iseegr8tfuldeadppl/Kiwico/ByeDominoRobotOG/domino_robot.png

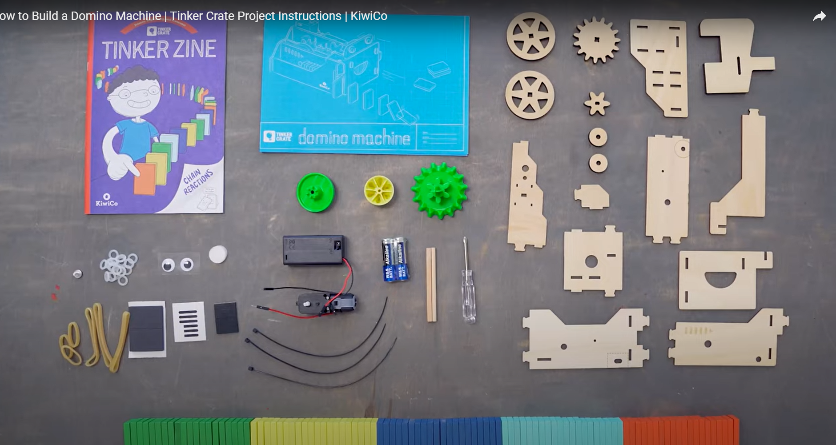
ByeDominoRobotOG/domino_robot.png
