iseegr8tfuldeadppl/Kiwico/circuitDiagrams/2.jpg

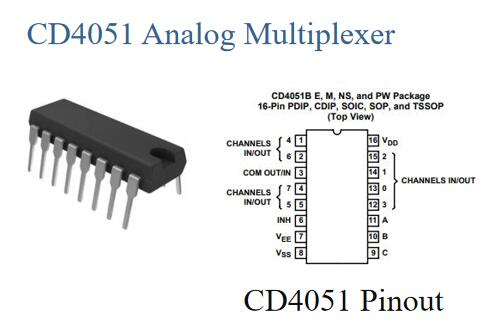
circuitDiagrams/2.jpg
