iseegr8tfuldeadppl/Kiwico/rpm_to_mm_per_s.png

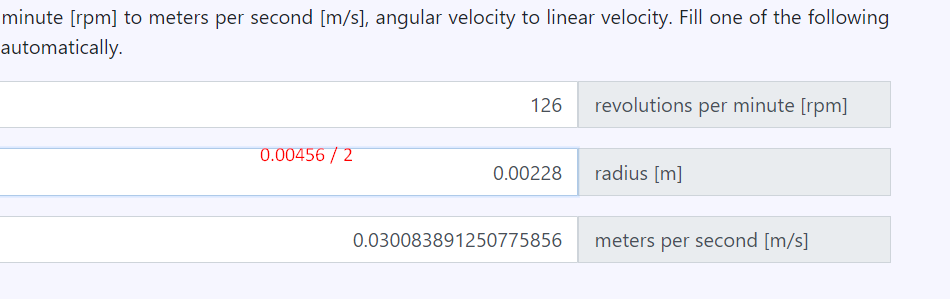
rpm_to_mm_per_s.png
