iseegr8tfuldeadppl/Kiwico/UselessBox/useless_box_truth_table.png

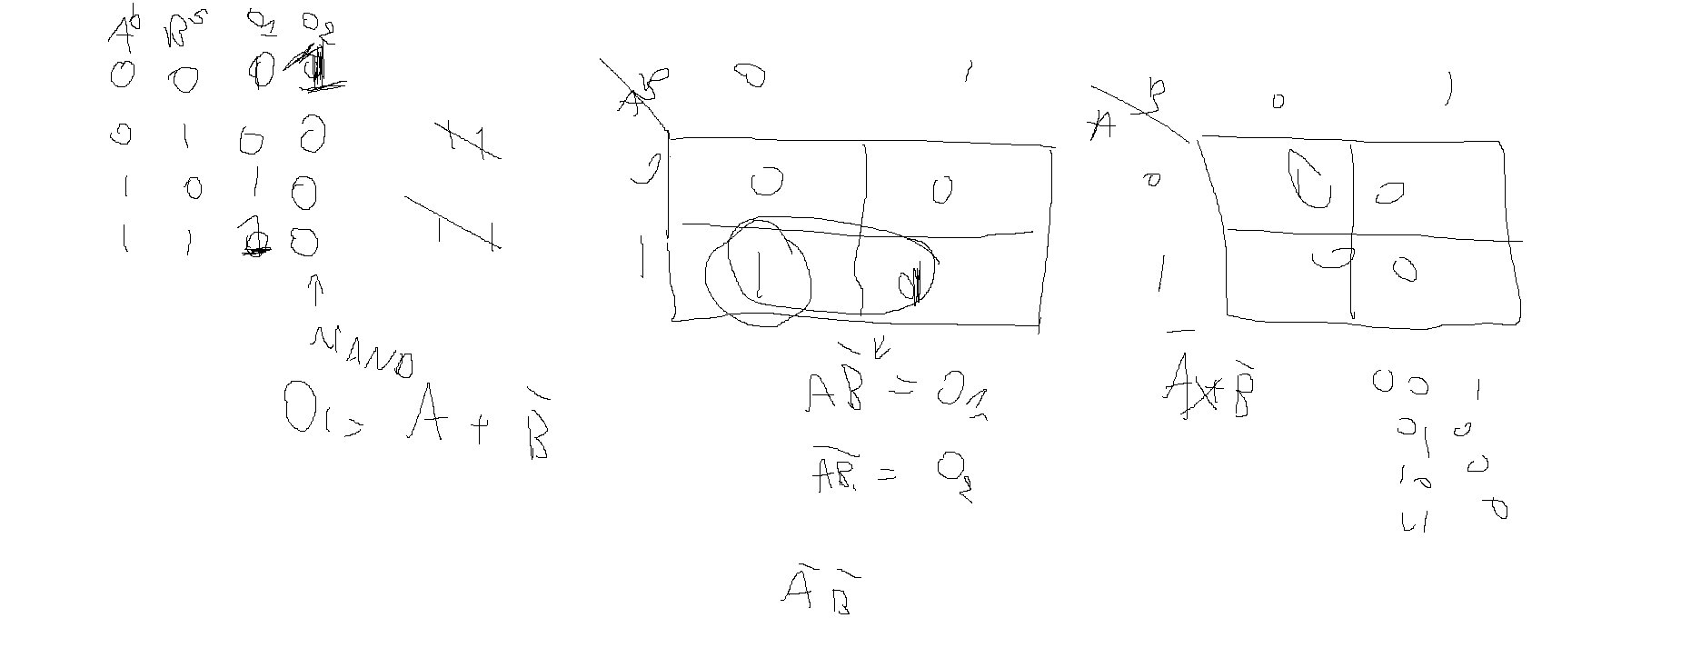
UselessBox/useless_box_truth_table.png
