iseegr8tfuldeadppl/Kiwico/body.SLDASM

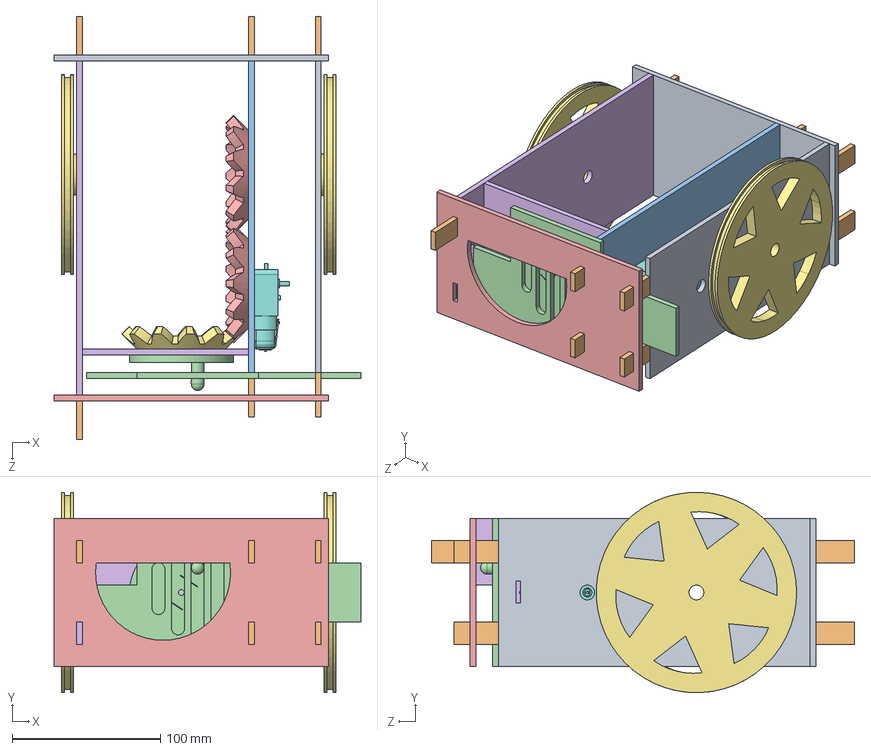
[picture p64: CAD file, 2023-03-07]
body.SLDASM
206.8 x 135.0 x 285.0 mm
back-wall
pin x 11
right-wall
front-wall
BevelGear x 2
separator
wheel x 2
TT Motor
right-most-wall
gear_back_plate
gear_front_plate
rotating_plate
front-smiley
left-wall
frontGear
