iseegr8tfuldeadppl/Kiwico/DominoRobotRework/body-v.SLDASM

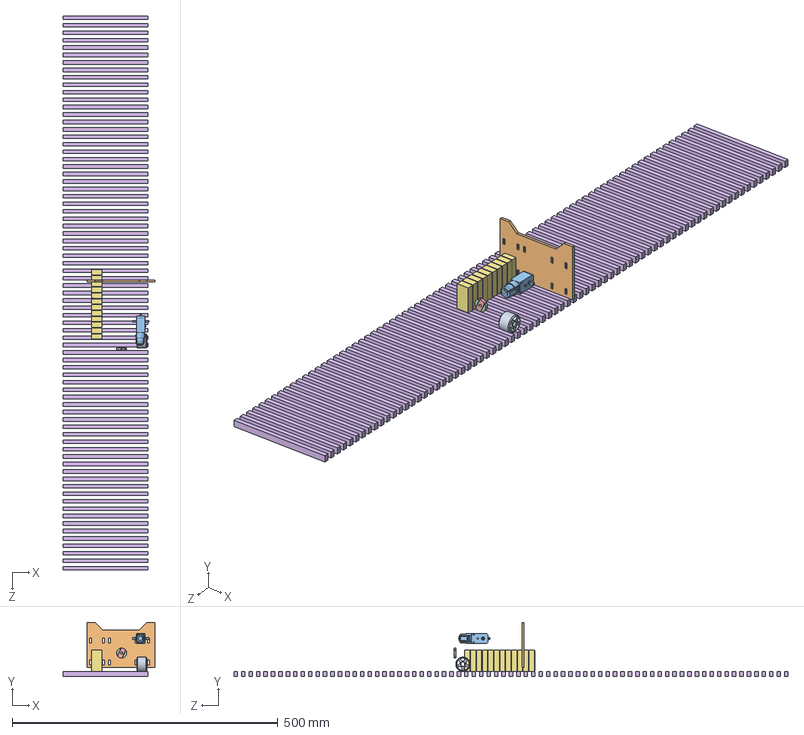
[picture p65: CAD file, 2023-03-17]
DominoRobotRework/body-v.SLDASM
172.5 x 102.5 x 1043.0 mm
back-wall-v
TT Motor-v
gear_front_plate-v
gear_back_plate-v
domino-v x 12
left-tiny_wheel-v
