iseegr8tfuldeadppl/Kiwico/ByeDominoRobotOG/other/developingMyOwnBevelGear/myStandGears.SLDASM

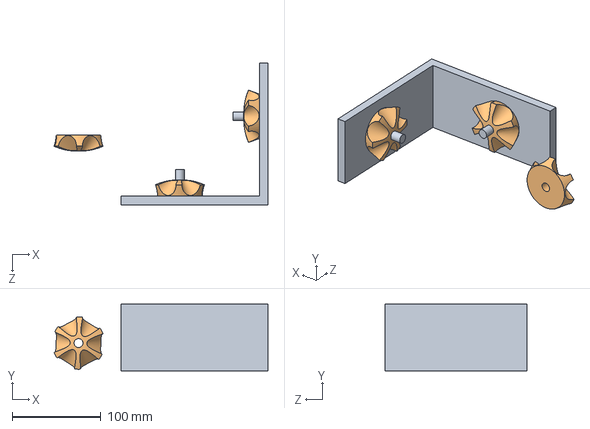
[picture p66: CAD file, 2022-07-12]
ByeDominoRobotOG/other/developingMyOwnBevelGear/myStandGears.SLDASM
241.6 x 75.2 x 160.0 mm
myGearTest
myBevelGear x 3
