iseegr8tfuldeadppl/Kiwico/ByeDominoRobotOG/test parts/test_set.SLDASM

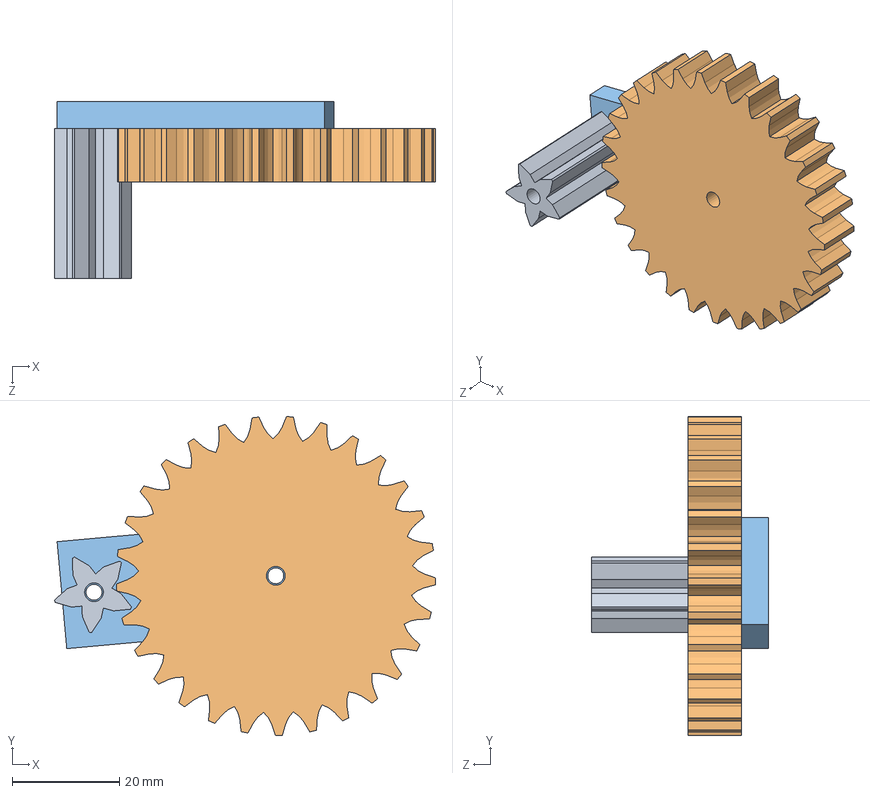
[picture p67: CAD file, 2022-07-19]
ByeDominoRobotOG/test parts/test_set.SLDASM
71.0 x 59.4 x 33.0 mm
test_leg_gear
test_motors_gear
test_stand
