iseegr8tfuldeadppl/Kiwico/UselessBox/entire_thing.SLDASM

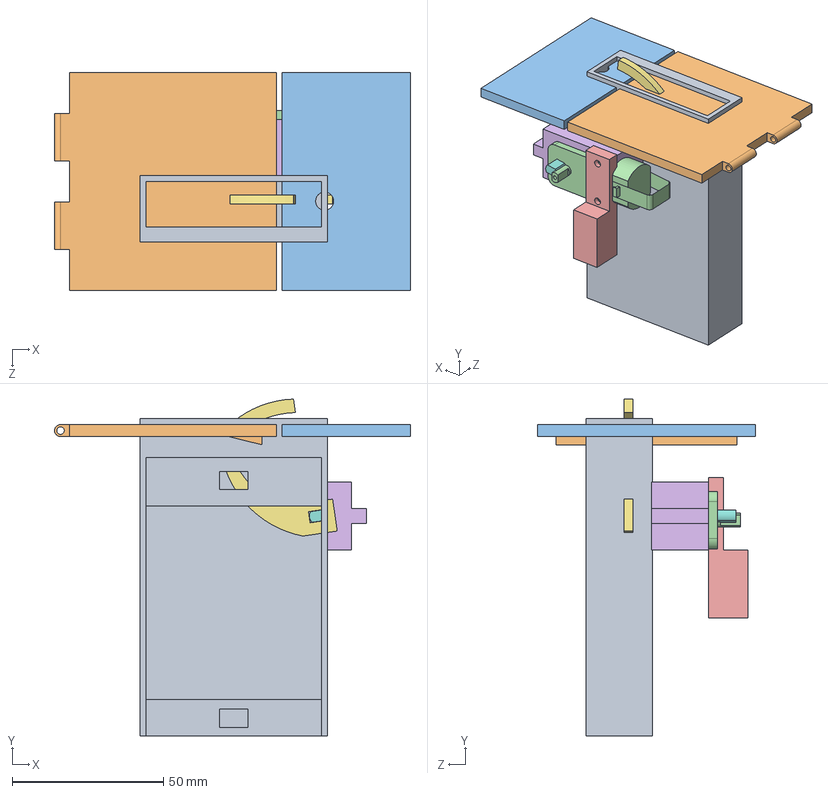
[picture p68: CAD file, 2022-09-26]
UselessBox/entire_thing.SLDASM
117.8 x 111.4 x 72.0 mm
box_openable_top
box_stationary_top
motor_holder
motor
rotator
motor_axis
