iseegr8tfuldeadppl/Kiwico/ByeDominoRobotOG/body-n.SLDASM

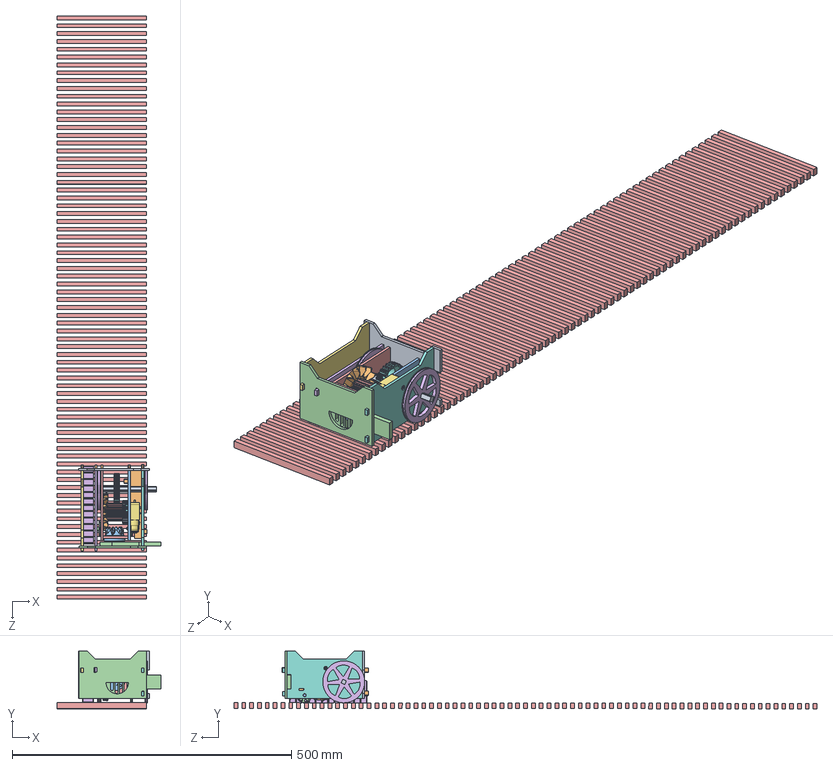
[picture p69: CAD file, 2022-10-12]
ByeDominoRobotOG/body-n.SLDASM
185.5 x 103.6 x 1043.0 mm
back-wall-n
pin-n x 12
right-wall-n
front-wall-n
separator-n
wheel-n x 2
TT Motor-n
right-most-wall-n
gear_back_plate-n
gear_front_plate-n
rotating_plate-n
front-smiley-n
left-wall-n
left-most-wall-n
leftest-most-wall
motors_gear
axis
floor
left_small_wheel_axis
tiny_wheel x 2
domino x 12
4mm_pin x 4
motor-gear
leg-gear
new-good-gear
sweep-gear
right_small_wheel_axis
pre-leg-gear
