iseegr8tfuldeadppl/Kiwico/bevel_gear_testing.SLDASM

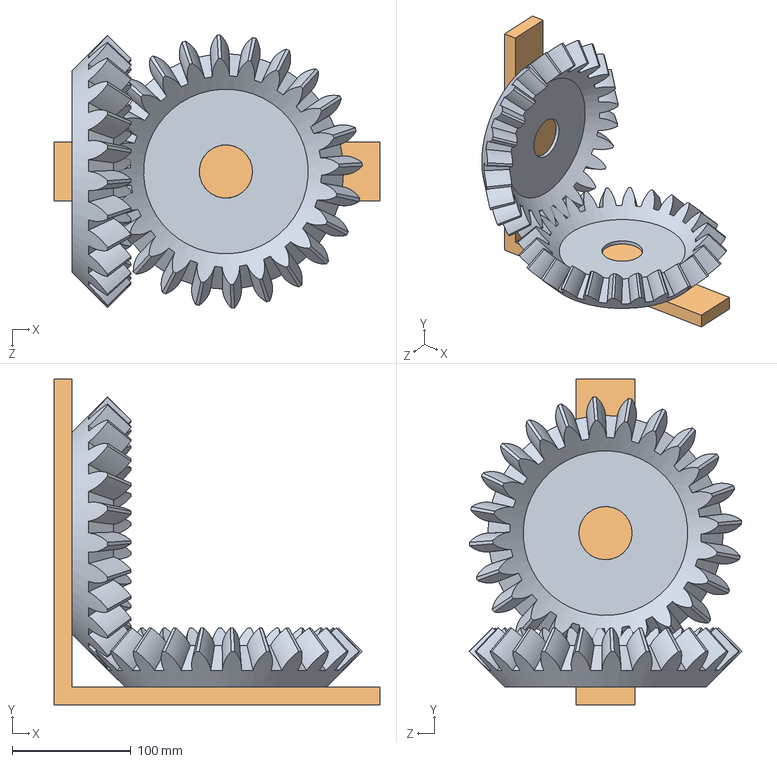
[picture p70: CAD file, 2022-07-11]
bevel_gear_testing.SLDASM
275.0 x 275.0 x 230.2 mm
BevelGear x 2
platform2
