iseegr8tfuldeadppl/Kiwico/ByeDominoRobotOG/other/OGBackup/body.SLDASM

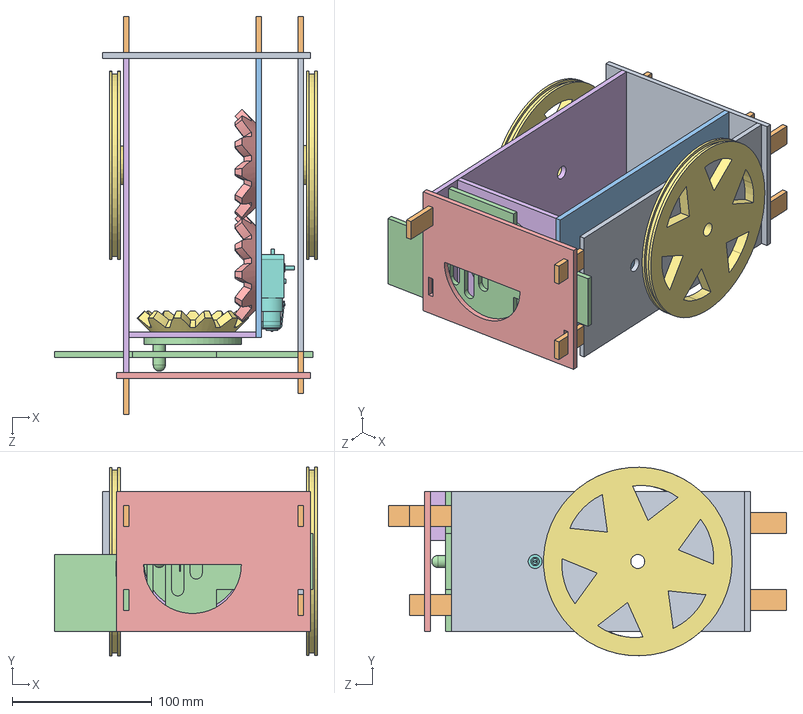
[picture p71: CAD file, 2022-07-11]
ByeDominoRobotOG/other/OGBackup/body.SLDASM
188.3 x 135.0 x 285.0 mm
back-wall
pin x 9
right-wall
front-wall
BevelGear x 2
separator
wheel x 2
TT Motor
right-most-wall
gear_back_plate
gear_front_plate
rotating_plate
front-smiley
left-wall
frontGear
