iseegr8tfuldeadppl/Kiwico/other/gear_training.SLDASM

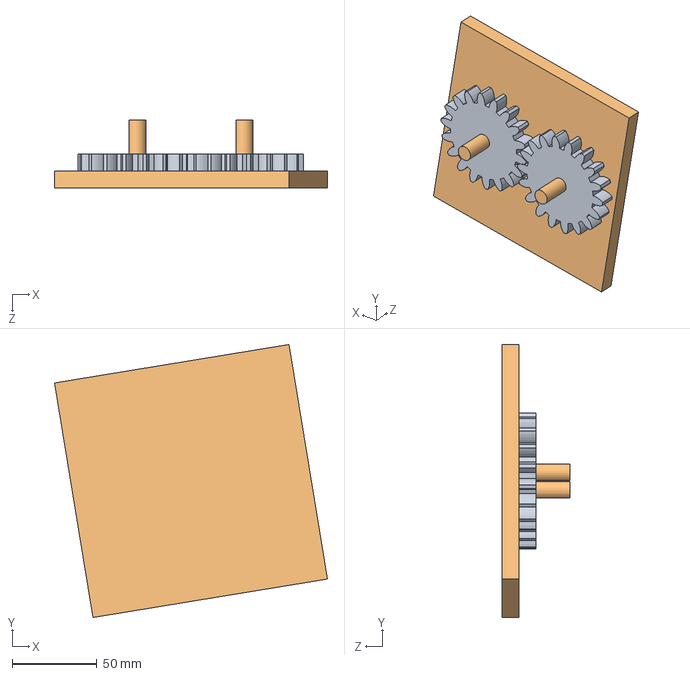
[picture p72: CAD file, 2022-07-11]
other/gear_training.SLDASM
160.8 x 160.8 x 40.0 mm
Gear x 2
platform
