iseegr8tfuldeadppl/Kiwico/ByeDominoRobotOG/completeRework/gear.SLDPRT

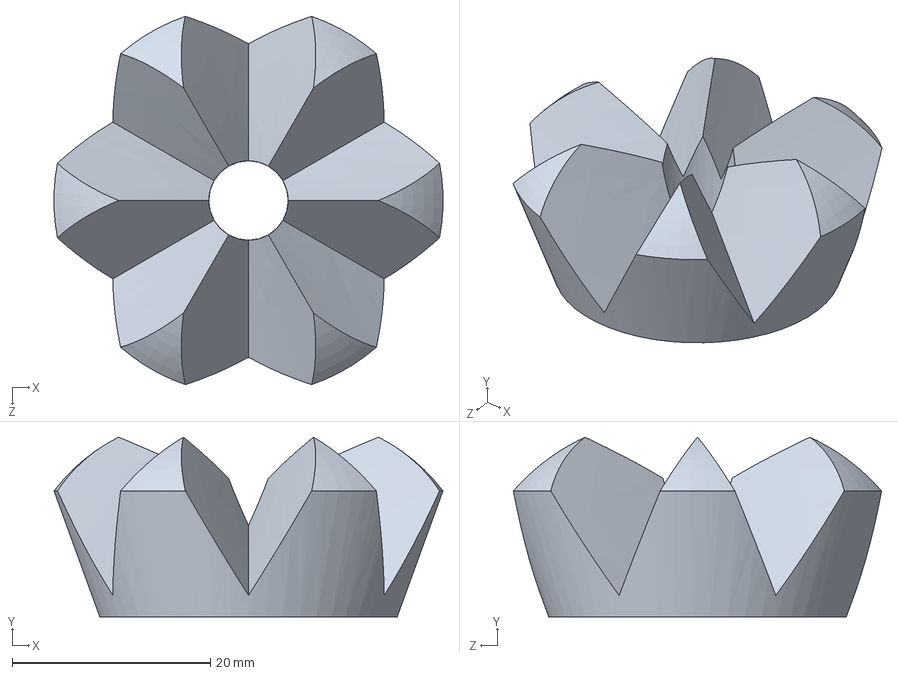
[picture p73: CAD file, 2022-09-19]
ByeDominoRobotOG/completeRework/gear.SLDPRT
39.2 x 18.1 x 37.1 mm
