iseegr8tfuldeadppl/Kiwico/ByeDominoRobotOG/other/developingMyOwnBevelGear/smolmyBevelMarkedGear.SLDPRT

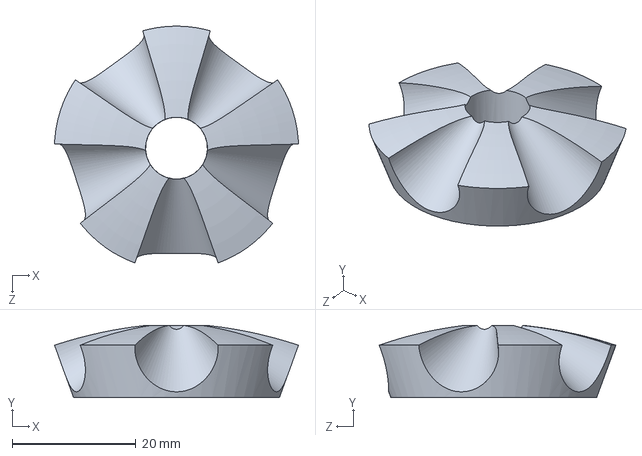
[picture p74: CAD file, 2022-07-17]
ByeDominoRobotOG/other/developingMyOwnBevelGear/smolmyBevelMarkedGear.SLDPRT
39.5 x 11.7 x 38.3 mm
