iseegr8tfuldeadppl/Kiwico/ByeDominoRobotOG/other/OGBackup/left-wall.SLDPRT

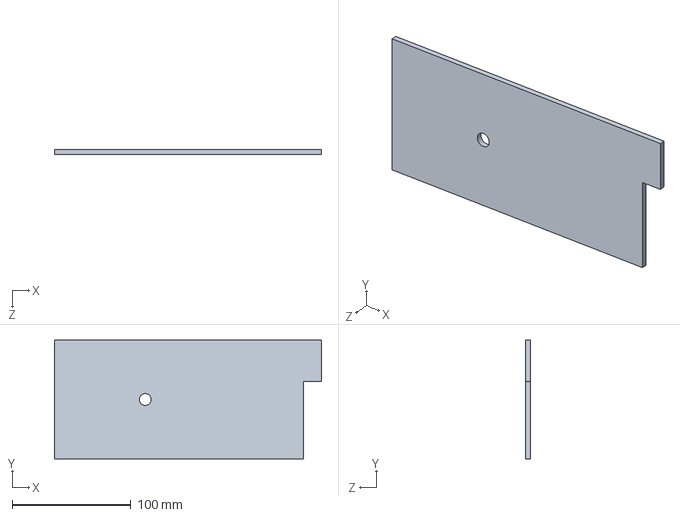
[picture p75: CAD file, 2022-07-11]
ByeDominoRobotOG/other/OGBackup/left-wall.SLDPRT
225.0 x 100.0 x 4.00 mm
