iseegr8tfuldeadppl/Kiwico/ByeDominoRobotOG/right_small_wheel_axis.SLDPRT

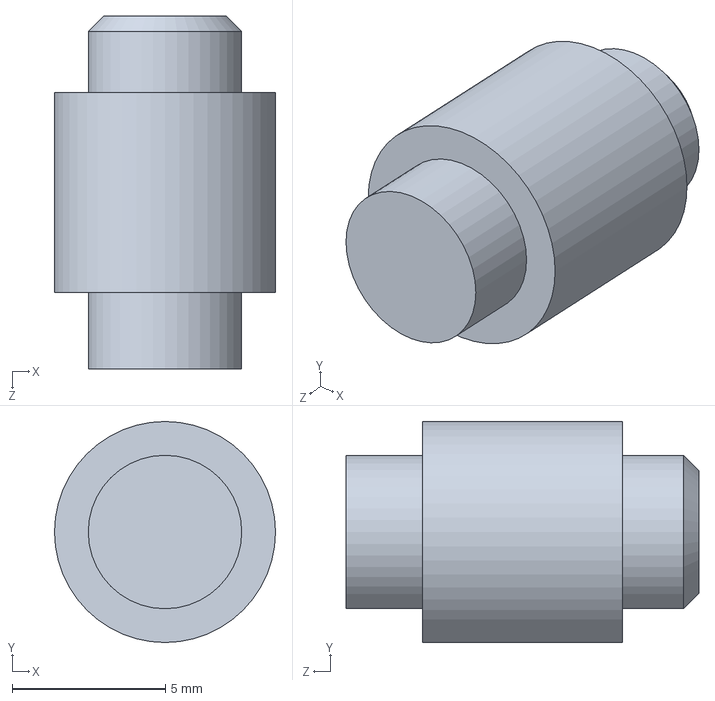
[picture p76: CAD file, 2022-10-16]
ByeDominoRobotOG/right_small_wheel_axis.SLDPRT
7.20 x 7.20 x 11.5 mm
