iseegr8tfuldeadppl/Kiwico/ByeDominoRobotOG/test parts/insertion_and_hole.SLDPRT

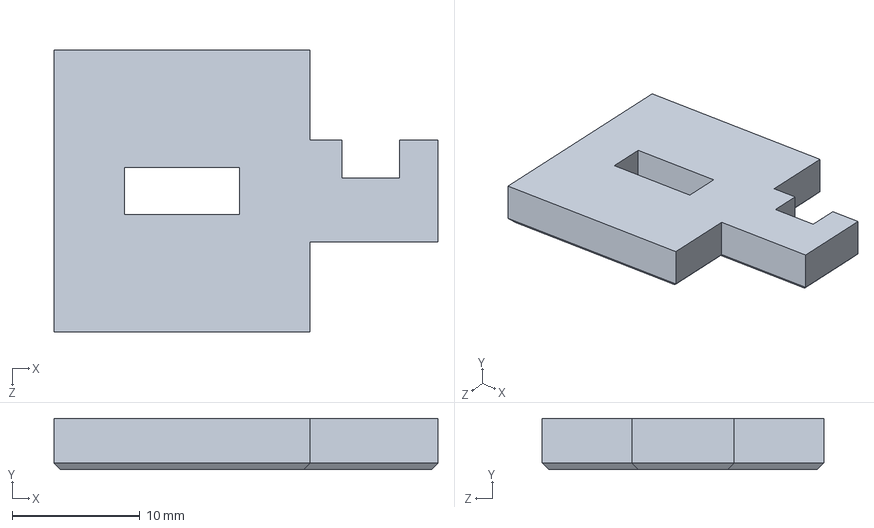
[picture p77: CAD file, 2022-10-12]
ByeDominoRobotOG/test parts/insertion_and_hole.SLDPRT
30.0 x 4.00 x 22.0 mm
