iseegr8tfuldeadppl/Kiwico/DominoRobotRework/test parts/wheelhole.SLDPRT

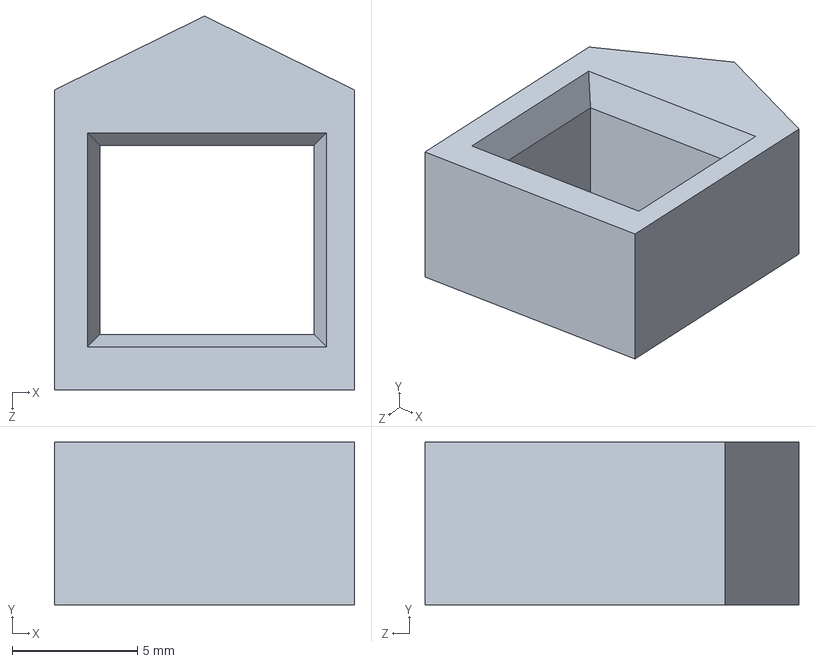
[picture p78: CAD file, 2022-10-24]
DominoRobotRework/test parts/wheelhole.SLDPRT
12.0 x 6.50 x 15.0 mm
