iseegr8tfuldeadppl/Kiwico/I came back to organize all print files/wider-front-smiley-v-between-right-walls.SLDPRT

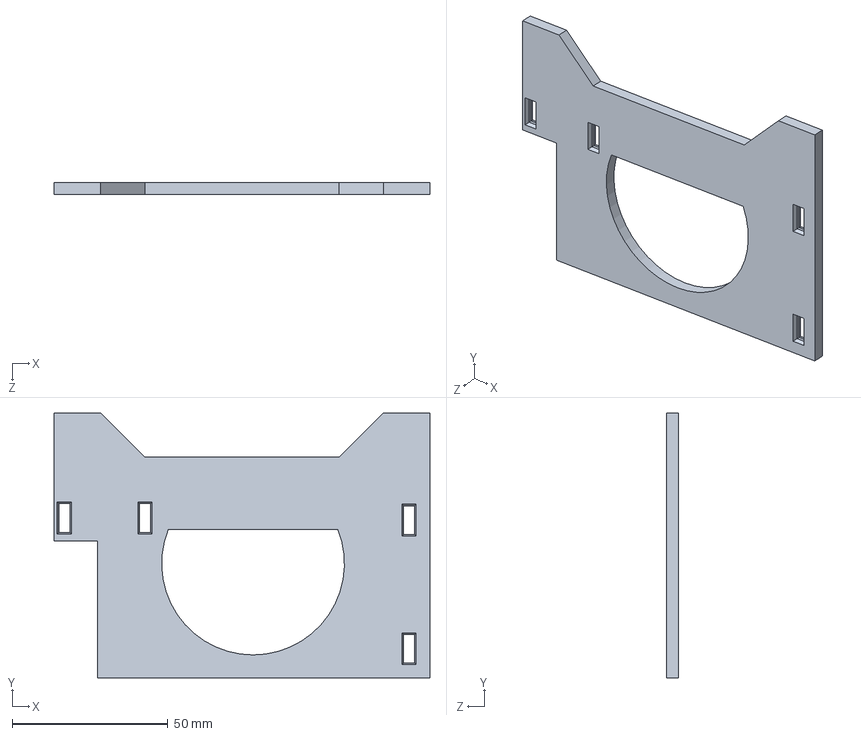
[picture p79: CAD file, 2023-03-14]
I came back to organize all print files/wider-front-smiley-v-between-right-walls.SLDPRT
120.7 x 85.0 x 4.00 mm
