iseegr8tfuldeadppl/Kiwico/other/TT Motor.step.SLDPRT

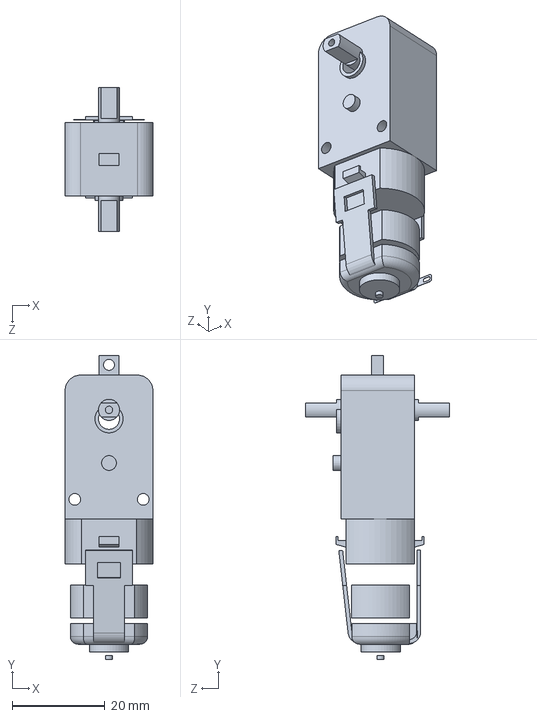
[picture p80: CAD file, 2023-03-07]
other/TT Motor.step.SLDPRT
19.0 x 65.7 x 31.1 mm
