iseegr8tfuldeadppl/Kiwico/UselessBox/switch_holder.SLDPRT

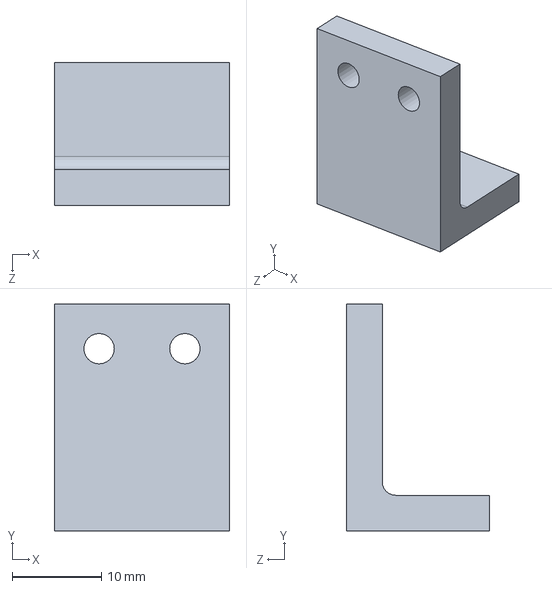
[picture p81: CAD file, 2022-10-02]
UselessBox/switch_holder.SLDPRT
19.6 x 25.4 x 16.0 mm
