iseegr8tfuldeadppl/Kiwico/UselessBox/testParts/axis.SLDPRT

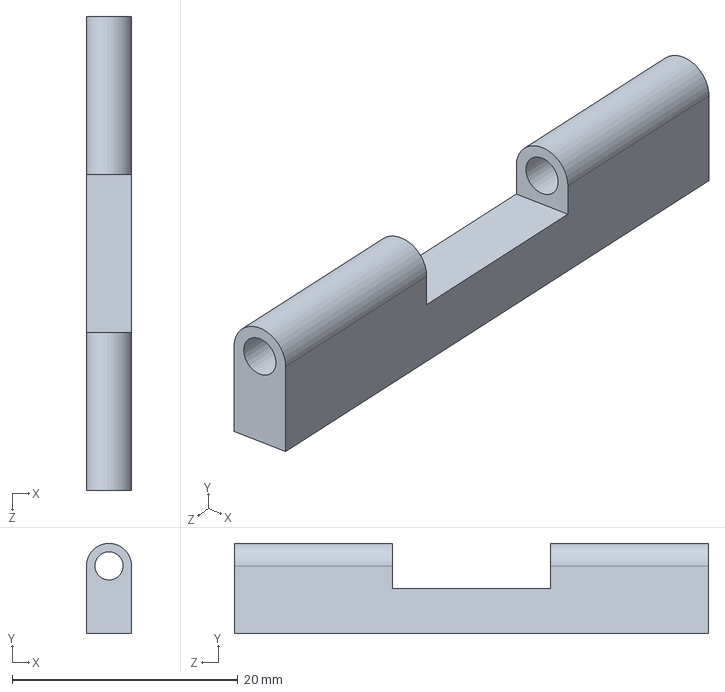
[picture p82: CAD file, 2022-09-25]
UselessBox/testParts/axis.SLDPRT
4.00 x 7.99 x 42.0 mm
