iseegr8tfuldeadppl/Kiwico/ByeDominoRobotOG/left_small_wheel_axis.SLDPRT

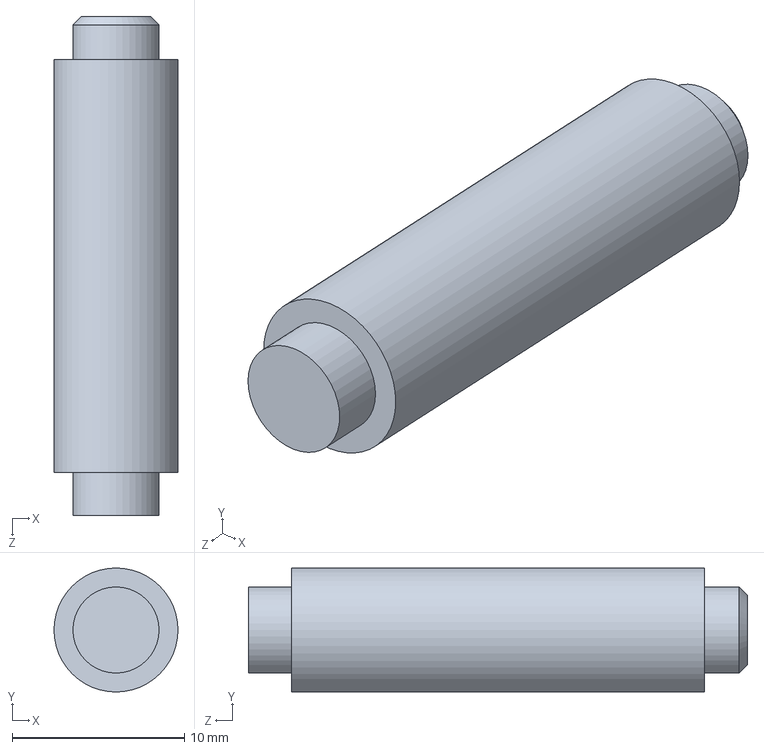
[picture p83: CAD file, 2022-10-16]
ByeDominoRobotOG/left_small_wheel_axis.SLDPRT
7.20 x 7.20 x 29.0 mm
