iseegr8tfuldeadppl/Kiwico/ByeDominoRobotOG/other/developingMyOwnBevelGear/backupmySquashedBevelMarkedGear.SLDPRT

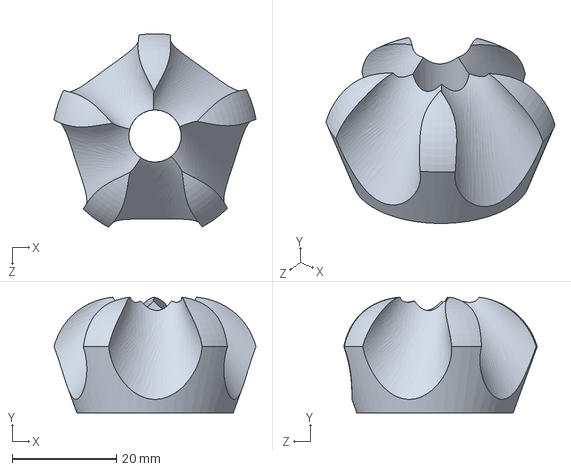
[picture p84: CAD file, 2022-07-17]
ByeDominoRobotOG/other/developingMyOwnBevelGear/backupmySquashedBevelMarkedGear.SLDPRT
38.7 x 22.2 x 37.1 mm
