iseegr8tfuldeadppl/Kiwico/ByeDominoRobotOG/other/OGBackup/back-wall.SLDPRT

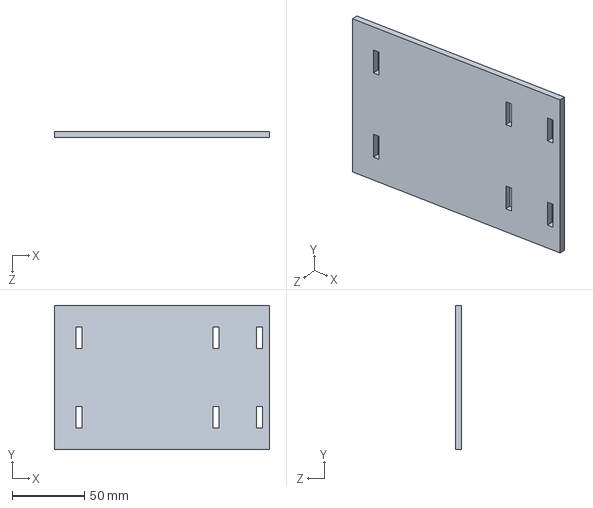
[picture p85: CAD file, 2022-07-11]
ByeDominoRobotOG/other/OGBackup/back-wall.SLDPRT
149.0 x 100.0 x 4.00 mm
