iseegr8tfuldeadppl/Kiwico/ByeDominoRobotOG/test parts/tiny_wheel_hole.SLDPRT

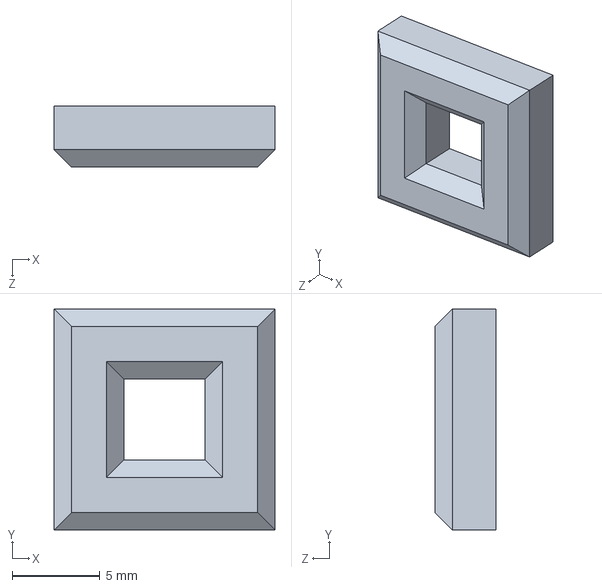
[picture p86: CAD file, 2022-09-28]
ByeDominoRobotOG/test parts/tiny_wheel_hole.SLDPRT
12.6 x 12.6 x 3.50 mm
