iseegr8tfuldeadppl/Kiwico/DominoRobotRework/back-wall-v.SLDPRT

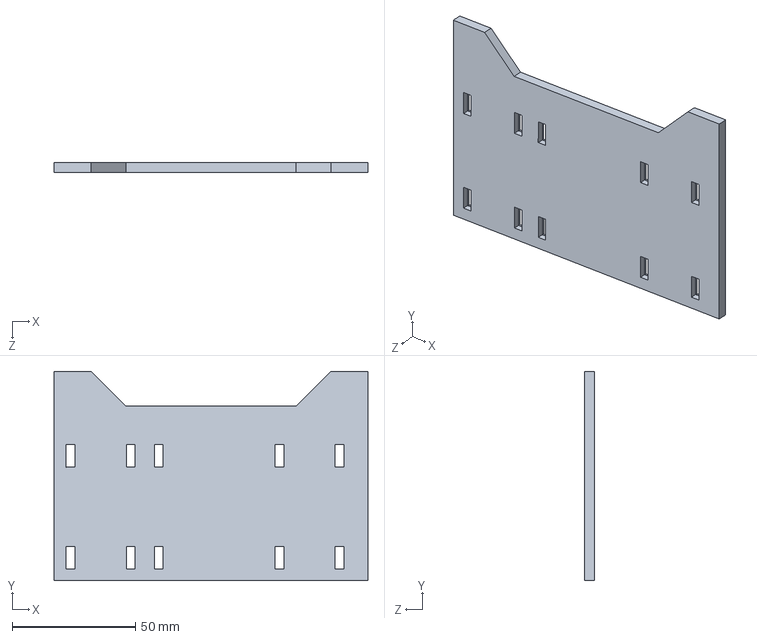
[picture p87: CAD file, 2023-03-17]
DominoRobotRework/back-wall-v.SLDPRT
127.4 x 85.0 x 4.00 mm
