iseegr8tfuldeadppl/Kiwico/DominoRobotRework/test parts/axis-test.SLDPRT

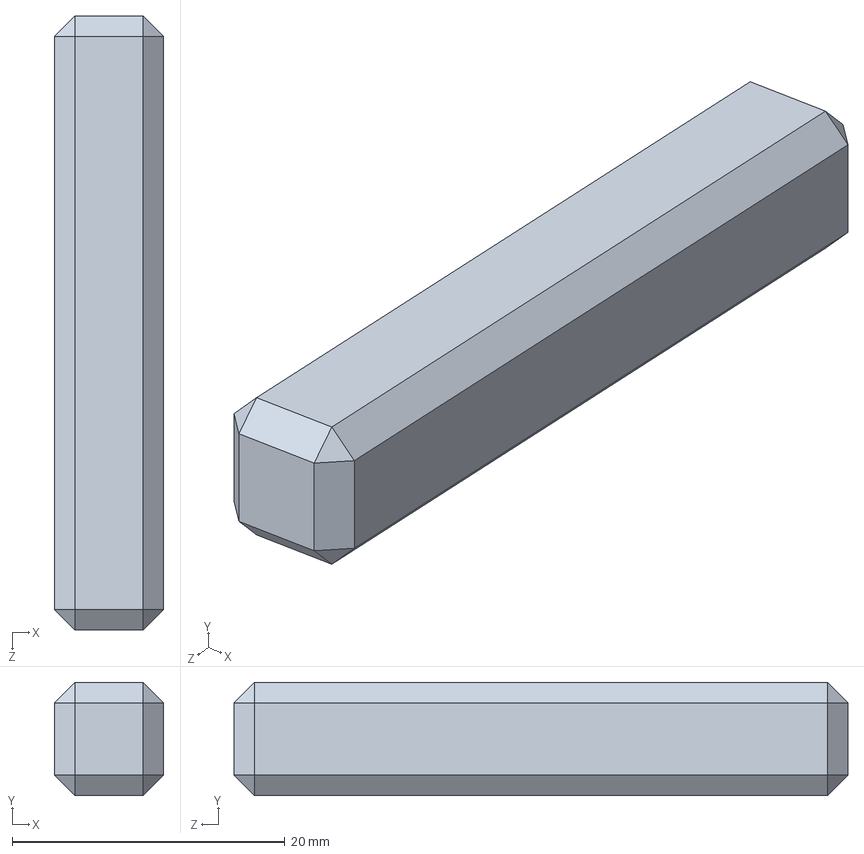
[picture p88: CAD file, 2022-10-24]
DominoRobotRework/test parts/axis-test.SLDPRT
8.00 x 8.30 x 45.0 mm
