iseegr8tfuldeadppl/Kiwico/other/platform2.SLDPRT

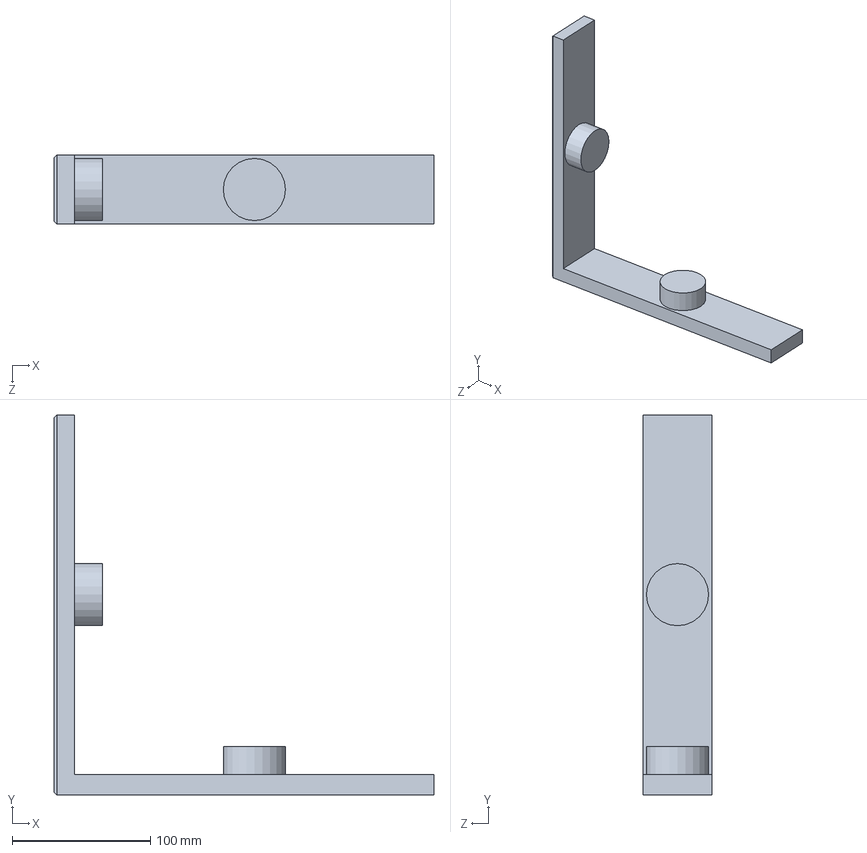
[picture p89: CAD file, 2022-07-11]
other/platform2.SLDPRT
275.0 x 275.0 x 50.0 mm
