iseegr8tfuldeadppl/Kiwico/UselessBox/small_switch_holder.SLDPRT

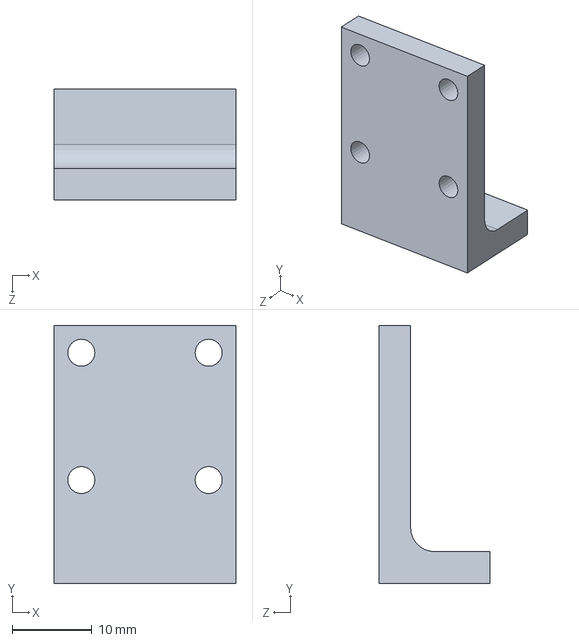
[picture p90: CAD file, 2022-10-02]
UselessBox/small_switch_holder.SLDPRT
22.8 x 32.4 x 14.0 mm
