iseegr8tfuldeadppl/Kiwico/ByeDominoRobotOG/other/developingMyOwnBevelGear/myBevelGear.SLDPRT

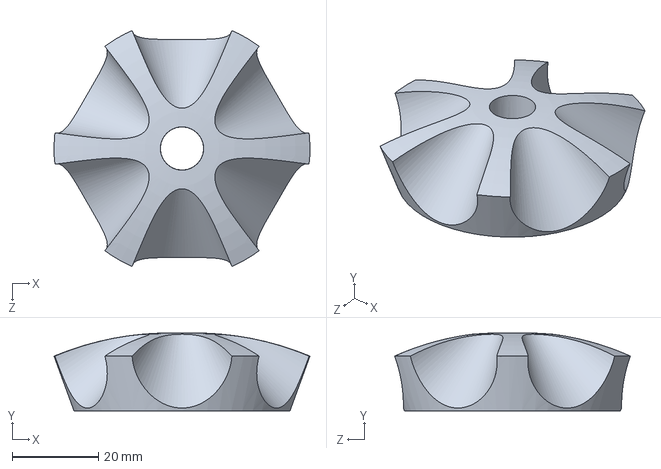
[picture p91: CAD file, 2022-07-12]
ByeDominoRobotOG/other/developingMyOwnBevelGear/myBevelGear.SLDPRT
59.2 x 18.0 x 54.5 mm
