iseegr8tfuldeadppl/Kiwico/ByeDominoRobotOG/other/OGBackup/separator.SLDPRT

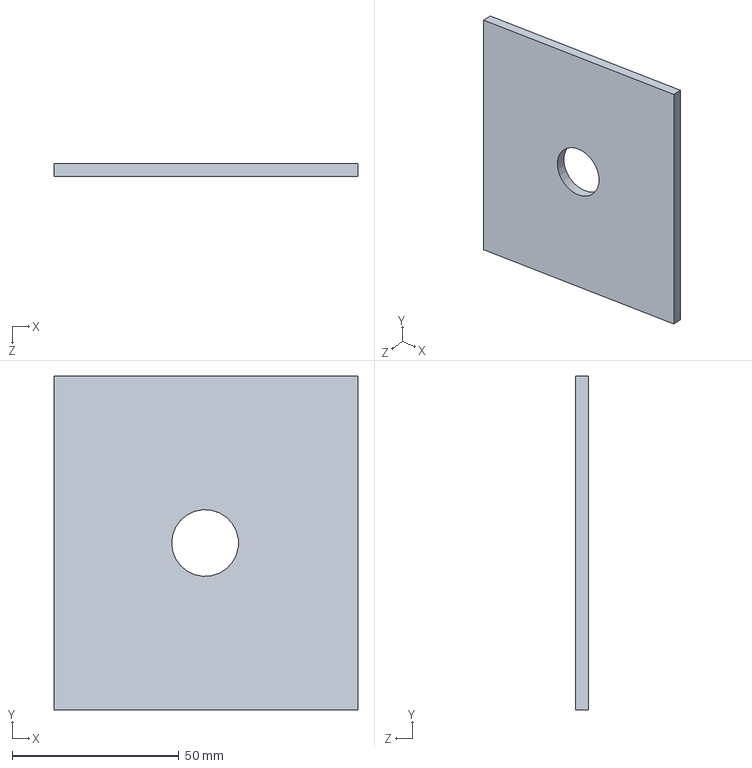
[picture p92: CAD file, 2022-07-11]
ByeDominoRobotOG/other/OGBackup/separator.SLDPRT
91.0 x 100.0 x 4.00 mm
