iseegr8tfuldeadppl/Kiwico/ByeDominoRobotOG/pin-n.SLDPRT

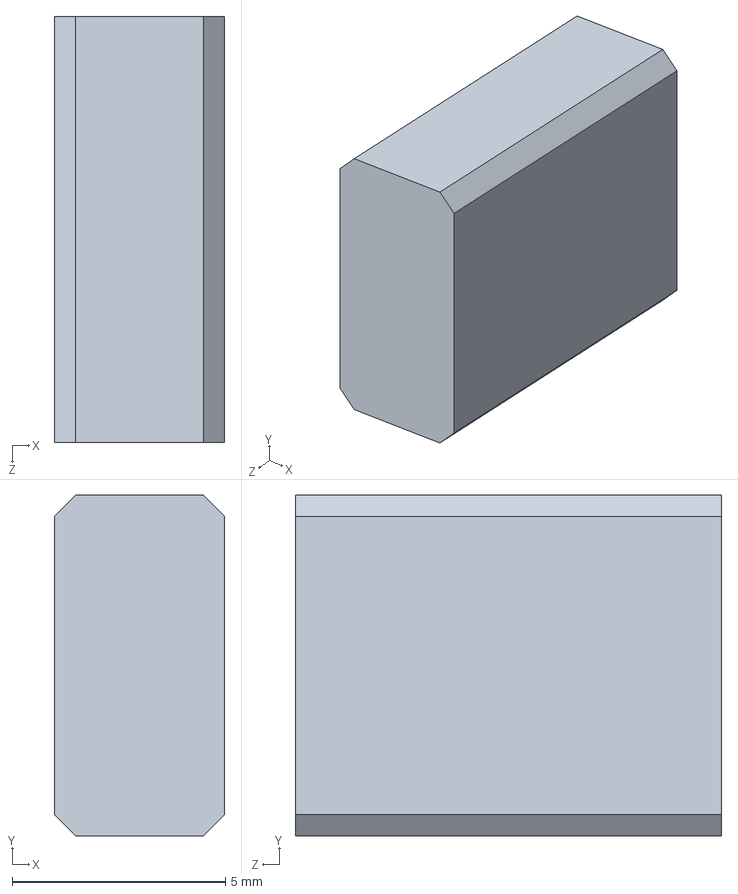
[picture p93: CAD file, 2022-10-12]
ByeDominoRobotOG/pin-n.SLDPRT
4.00 x 8.00 x 10.0 mm
