iseegr8tfuldeadppl/Kiwico/ByeDominoRobotOG/test parts/motorShaftFemaleTest.SLDPRT

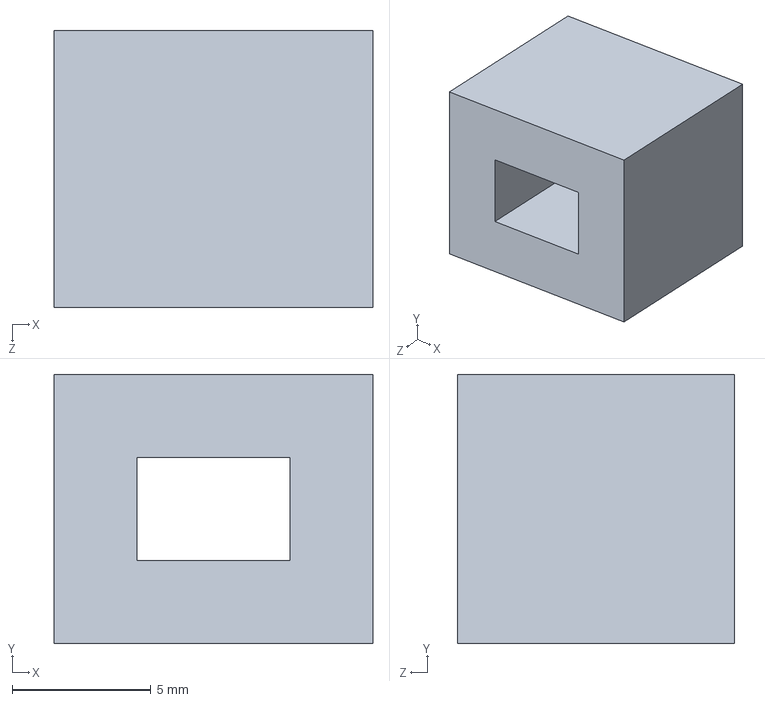
[picture p94: CAD file, 2022-09-18]
ByeDominoRobotOG/test parts/motorShaftFemaleTest.SLDPRT
11.5 x 9.70 x 10.0 mm
