iseegr8tfuldeadppl/Kiwico/DominoRobotRework/left-tiny_wheel-v.SLDPRT

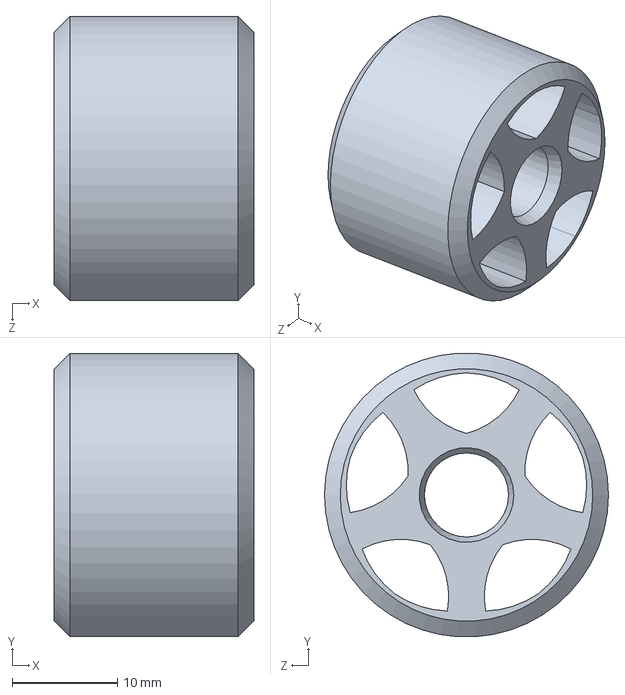
[picture p95: CAD file, 2023-03-17]
DominoRobotRework/left-tiny_wheel-v.SLDPRT
19.0 x 26.9 x 27.0 mm
