iseegr8tfuldeadppl/Kiwico/DominoRobotRework/test parts/insertion.SLDPRT

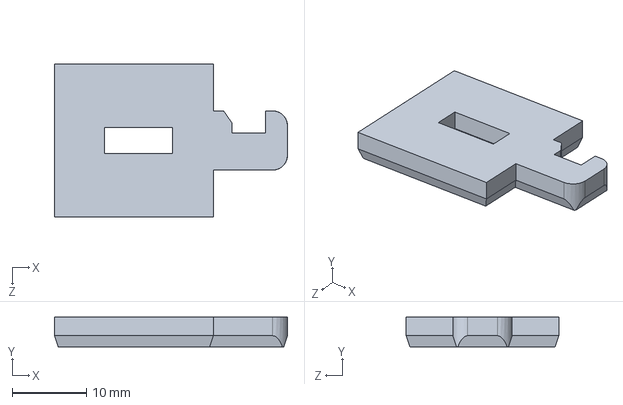
[picture p96: CAD file, 2022-10-20]
DominoRobotRework/test parts/insertion.SLDPRT
31.4 x 4.00 x 20.6 mm
