iseegr8tfuldeadppl/Kiwico/Gear.SLDPRT

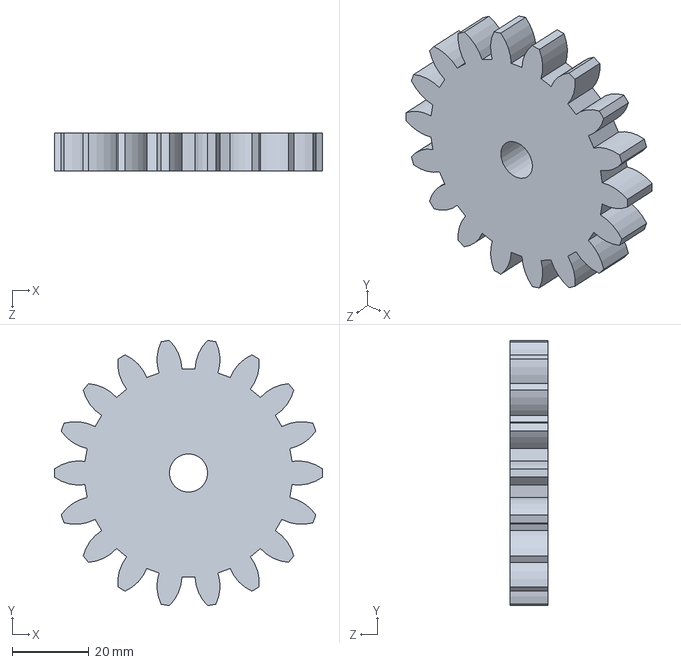
[picture p97: CAD file, 2022-07-11]
Gear.SLDPRT
70.0 x 69.3 x 10.0 mm
