iseegr8tfuldeadppl/Kiwico/other/platform.SLDPRT

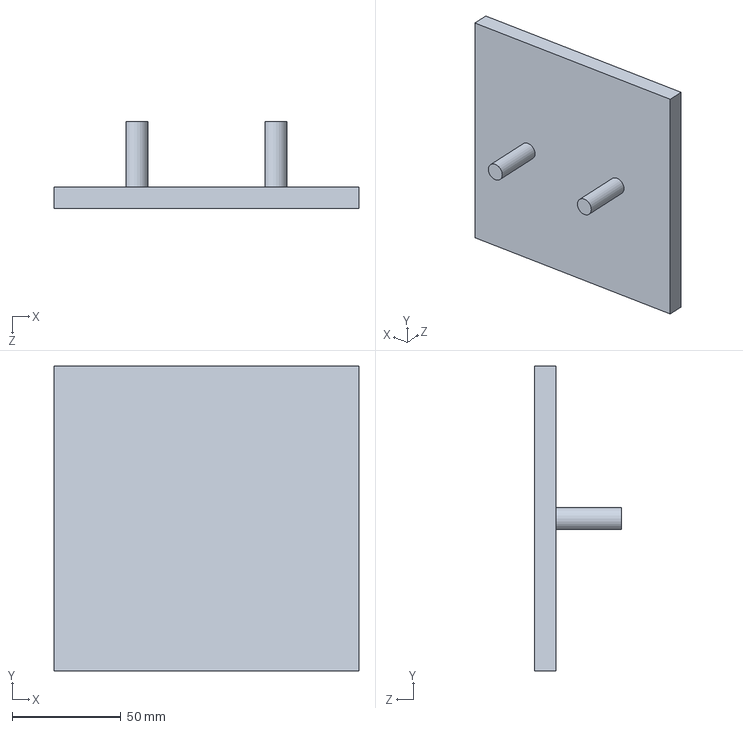
[picture p98: CAD file, 2022-07-11]
other/platform.SLDPRT
140.0 x 140.0 x 40.0 mm
