iseegr8tfuldeadppl/Kiwico/UselessBox/rotator.SLDPRT

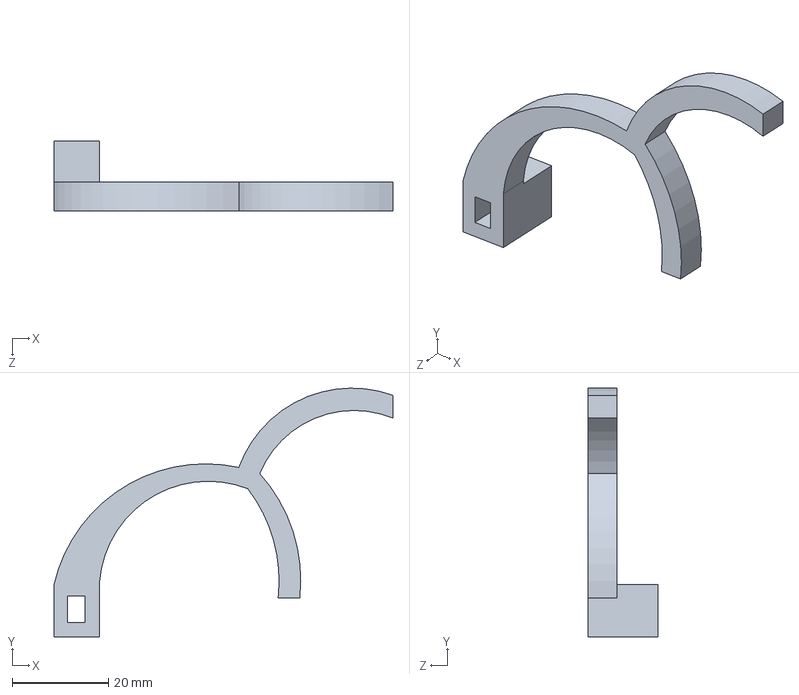
[picture p99: CAD file, 2022-09-27]
UselessBox/rotator.SLDPRT
70.4 x 51.7 x 14.5 mm
