iseegr8tfuldeadppl/Kiwico/ByeDominoRobotOG/motors_gear.SLDPRT

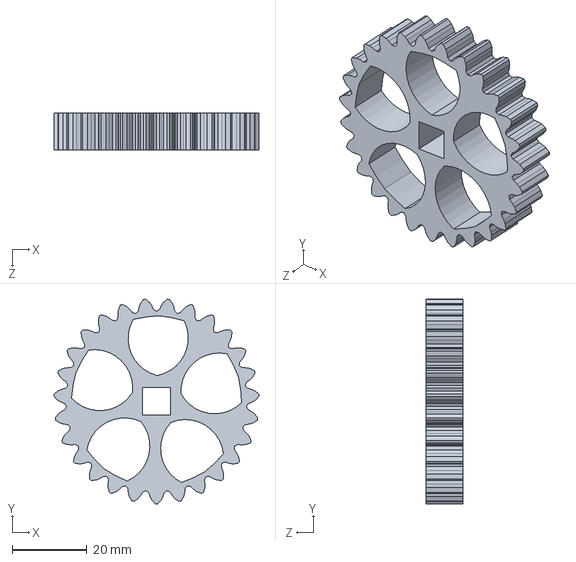
[picture p100: CAD file, 2022-10-12]
ByeDominoRobotOG/motors_gear.SLDPRT
54.9 x 54.8 x 10.0 mm
