iseegr8tfuldeadppl/Kiwico/ByeDominoRobotOG/other/OGBackup/front-smiley.SLDPRT

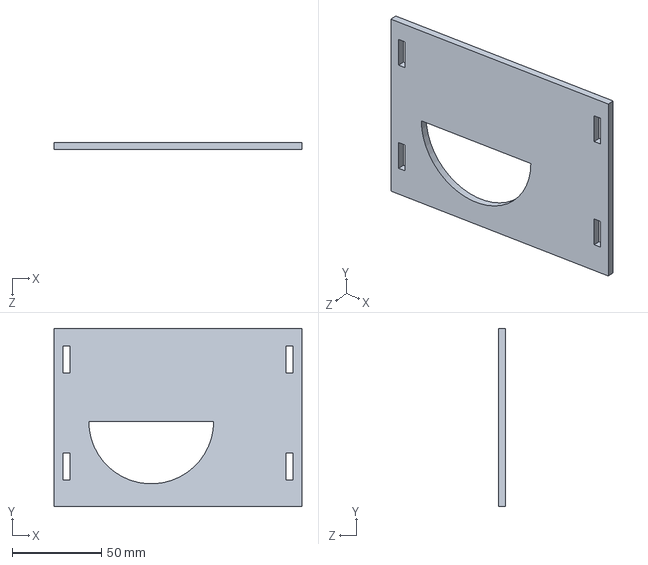
[picture p101: CAD file, 2022-07-11]
ByeDominoRobotOG/other/OGBackup/front-smiley.SLDPRT
139.0 x 100.0 x 4.00 mm
