iseegr8tfuldeadppl/Kiwico/ByeDominoRobotOG/test parts/test_stand.SLDPRT

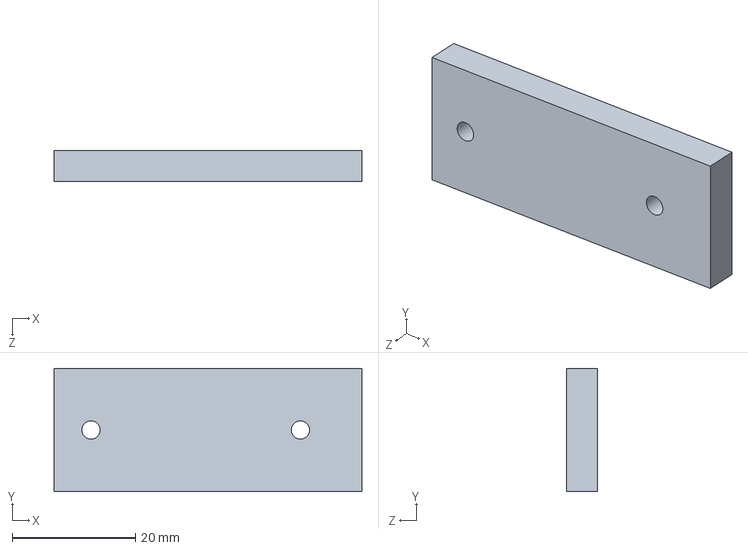
[picture p102: CAD file, 2022-07-20]
ByeDominoRobotOG/test parts/test_stand.SLDPRT
50.0 x 20.0 x 5.00 mm
