iseegr8tfuldeadppl/Kiwico/DominoRobotRework/box.SLDPRT

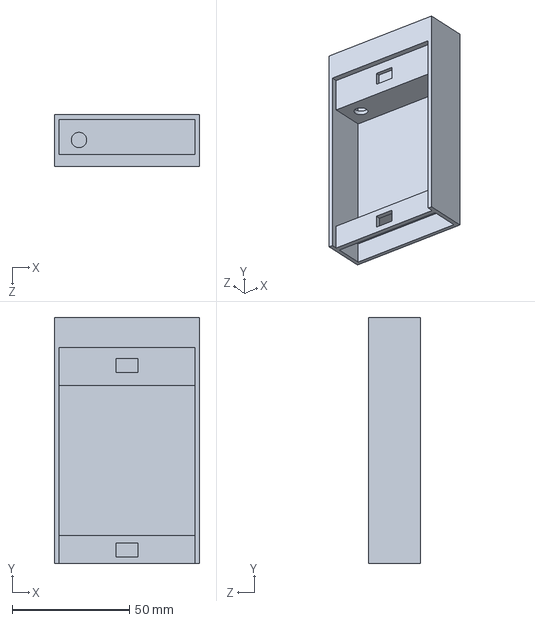
[picture p103: CAD file, 2023-03-17]
DominoRobotRework/box.SLDPRT
62.0 x 105.0 x 22.0 mm
