iseegr8tfuldeadppl/Kiwico/DominoRobotRework/test parts/tiny_wheel_hole.SLDPRT

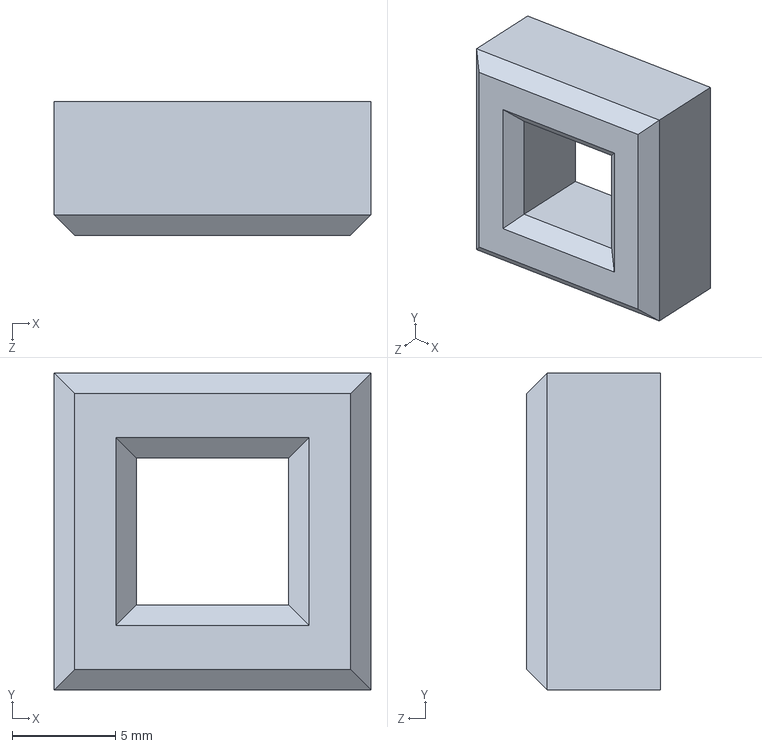
[picture p104: CAD file, 2022-10-20]
DominoRobotRework/test parts/tiny_wheel_hole.SLDPRT
15.4 x 15.4 x 6.50 mm
