iseegr8tfuldeadppl/Kiwico/other/BevelGear2.SLDPRT

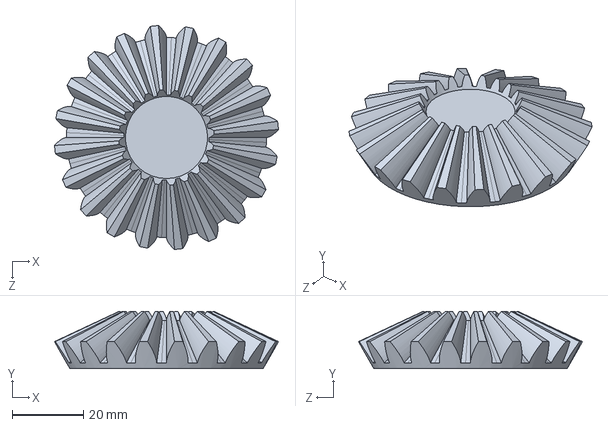
[picture p105: CAD file, 2022-07-11]
other/BevelGear2.SLDPRT
62.8 x 16.0 x 62.8 mm
