iseegr8tfuldeadppl/Kiwico/rotator.SLDPRT

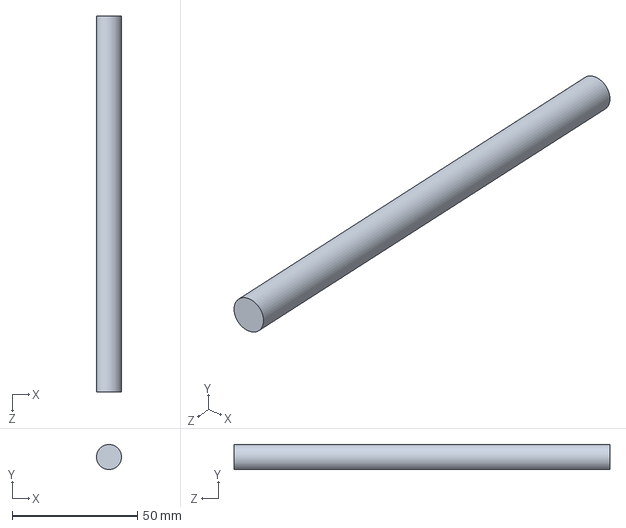
[picture p106: CAD file, 2022-07-11]
rotator.SLDPRT
10.0 x 10.0 x 150.0 mm
