iseegr8tfuldeadppl/Kiwico/UselessBox/box.SLDPRT

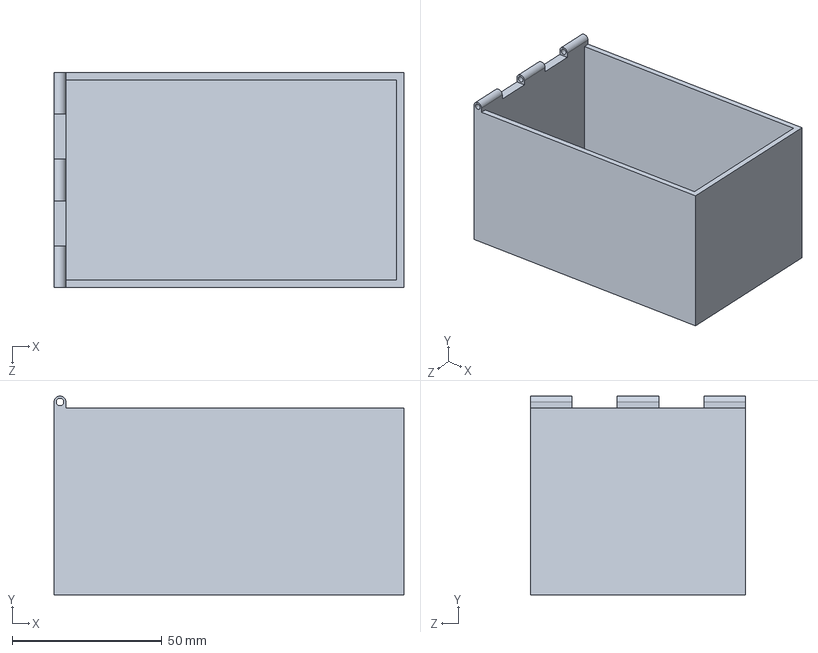
[picture p107: CAD file, 2022-09-26]
UselessBox/box.SLDPRT
117.0 x 66.5 x 72.0 mm
