iseegr8tfuldeadppl/Kiwico/back-wall.SLDPRT

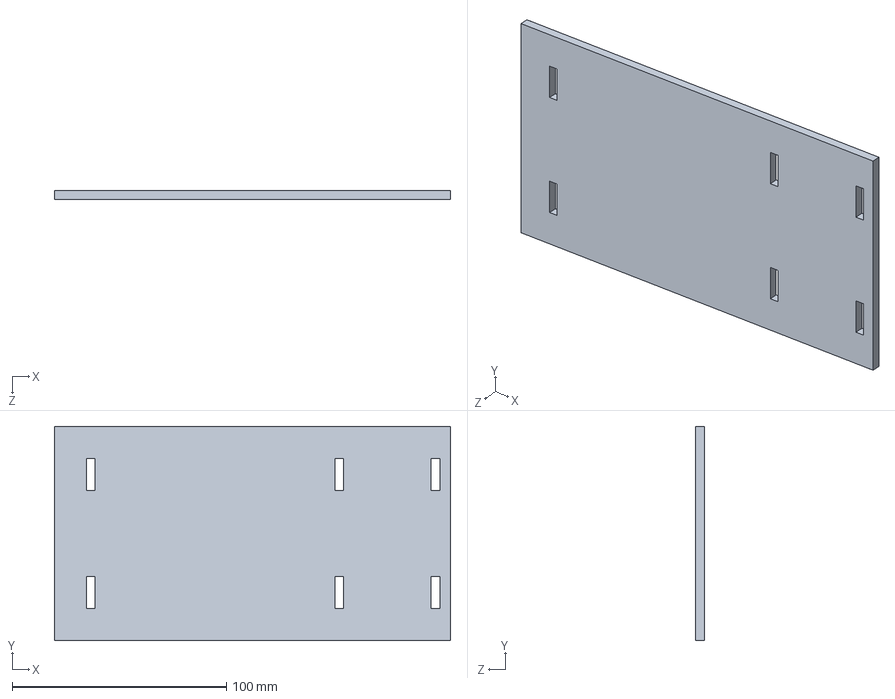
[picture p108: CAD file, 2022-07-11]
back-wall.SLDPRT
185.0 x 100.0 x 4.00 mm
