iseegr8tfuldeadppl/Kiwico/ByeDominoRobotOG/other/developingMyOwnBevelGear/myGearTest.SLDPRT

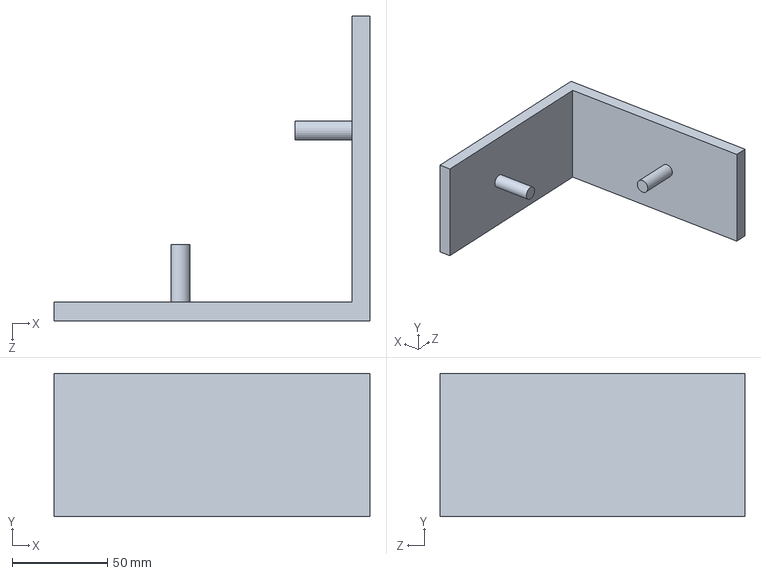
[picture p109: CAD file, 2022-07-12]
ByeDominoRobotOG/other/developingMyOwnBevelGear/myGearTest.SLDPRT
165.9 x 75.2 x 160.0 mm
