iseegr8tfuldeadppl/Kiwico/ByeDominoRobotOG/other/OGBackup/right-wall.SLDPRT

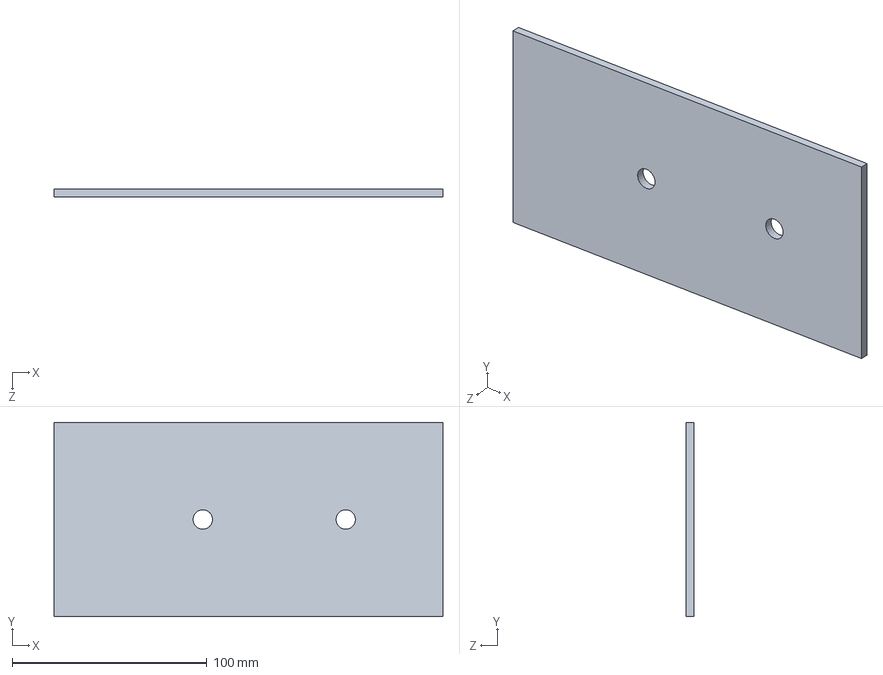
[picture p110: CAD file, 2022-07-11]
ByeDominoRobotOG/other/OGBackup/right-wall.SLDPRT
200.0 x 100.0 x 4.00 mm
