iseegr8tfuldeadppl/Kiwico/DominoRobotRework/left_small_wheel_sock.SLDPRT

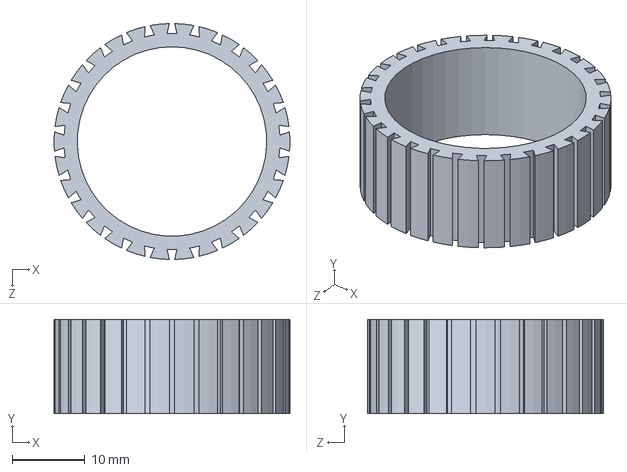
[picture p111: CAD file, 2023-03-17]
DominoRobotRework/left_small_wheel_sock.SLDPRT
32.4 x 13.0 x 32.4 mm
