iseegr8tfuldeadppl/Kiwico/ByeDominoRobotOG/leg-gear.SLDPRT

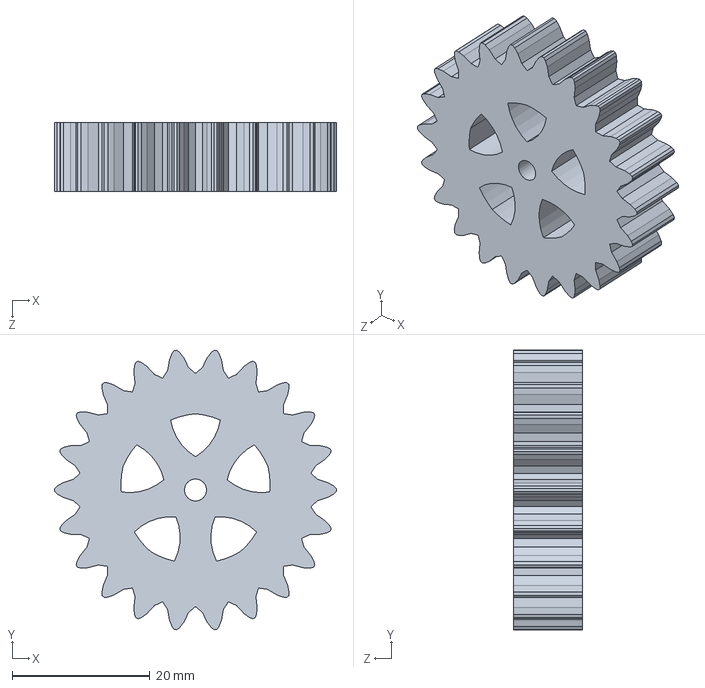
[picture p112: CAD file, 2022-10-12]
ByeDominoRobotOG/leg-gear.SLDPRT
41.0 x 40.6 x 10.0 mm
