iseegr8tfuldeadppl/Kiwico/ByeDominoRobotOG/other/OGBackup/front-wall.SLDPRT

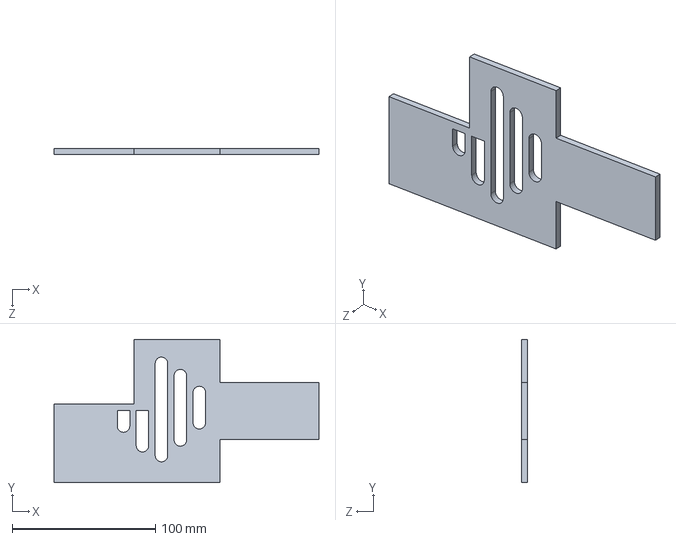
[picture p113: CAD file, 2022-07-11]
ByeDominoRobotOG/other/OGBackup/front-wall.SLDPRT
185.0 x 100.0 x 4.00 mm
