iseegr8tfuldeadppl/Kiwico/ByeDominoRobotOG/test parts/test_motors_gear.SLDPRT

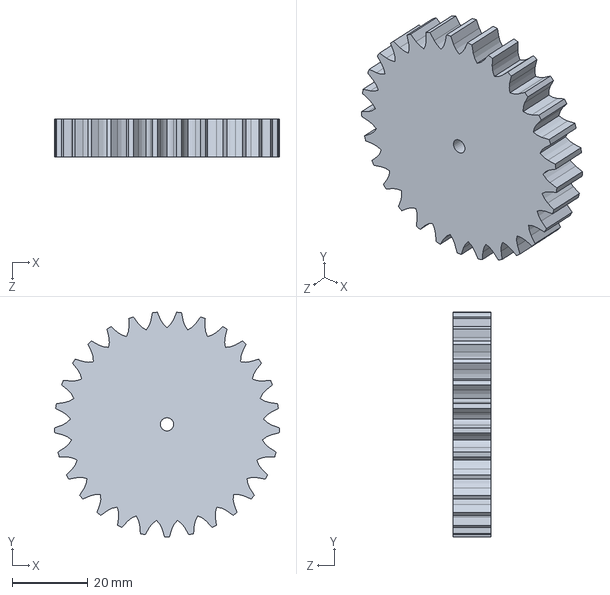
[picture p114: CAD file, 2022-07-19]
ByeDominoRobotOG/test parts/test_motors_gear.SLDPRT
59.5 x 59.4 x 10.0 mm
