iseegr8tfuldeadppl/Kiwico/DominoRobotRework/rotating_plate-v.SLDPRT

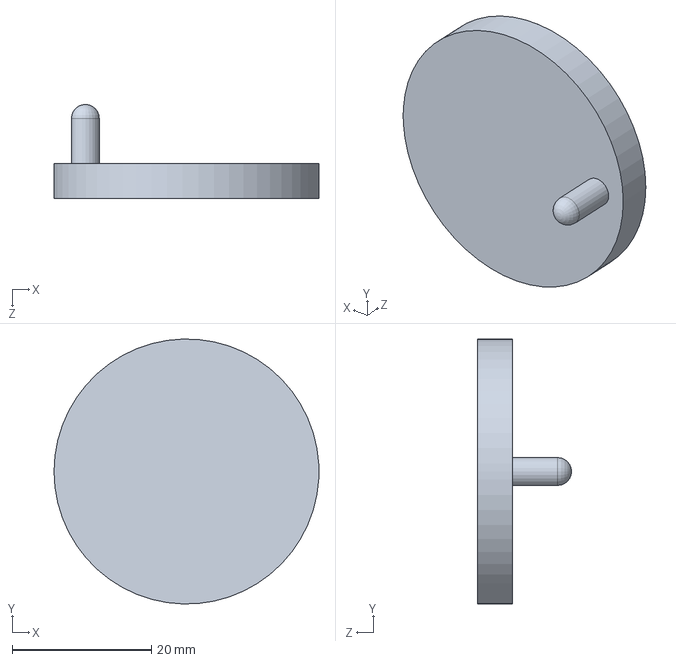
[picture p115: CAD file, 2023-03-17]
DominoRobotRework/rotating_plate-v.SLDPRT
38.0 x 38.0 x 13.5 mm
