iseegr8tfuldeadppl/Kiwico/front-smiley.SLDPRT

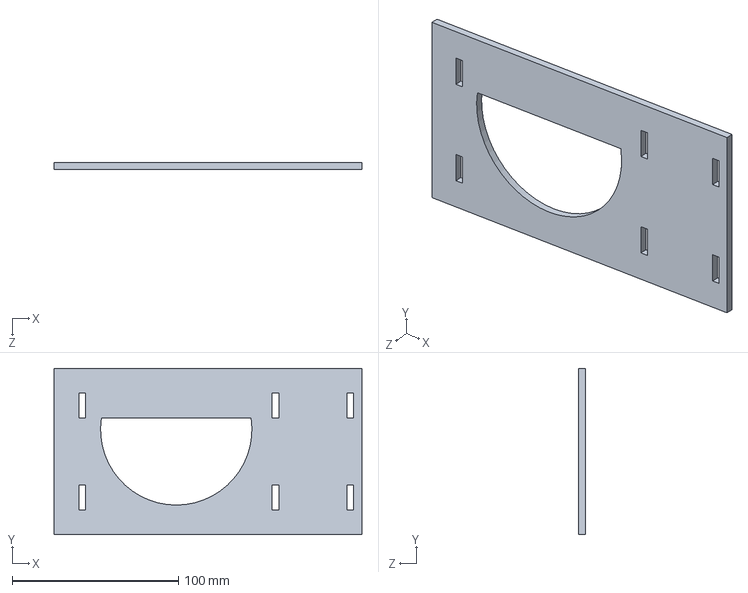
[picture p116: CAD file, 2022-07-11]
front-smiley.SLDPRT
185.0 x 100.0 x 4.00 mm
