iseegr8tfuldeadppl/Kiwico/UselessBox/box_openable_top.SLDPRT

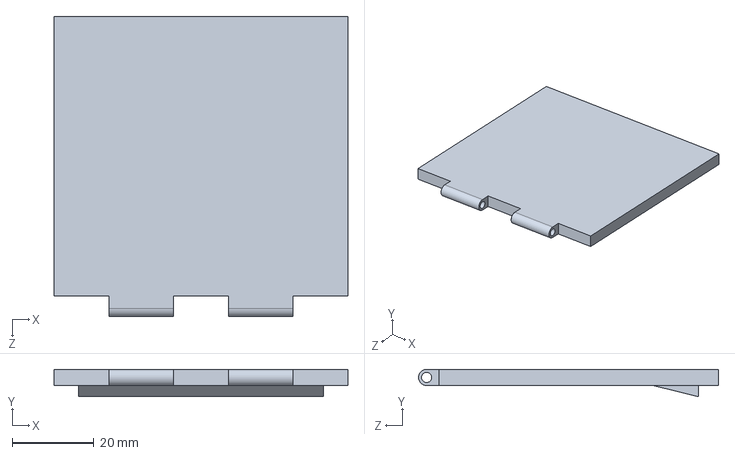
[picture p117: CAD file, 2022-09-26]
UselessBox/box_openable_top.SLDPRT
72.0 x 6.74 x 73.5 mm
