iseegr8tfuldeadppl/Kiwico/ByeDominoRobotOG/other/OGBackup/right-most-wall.SLDPRT

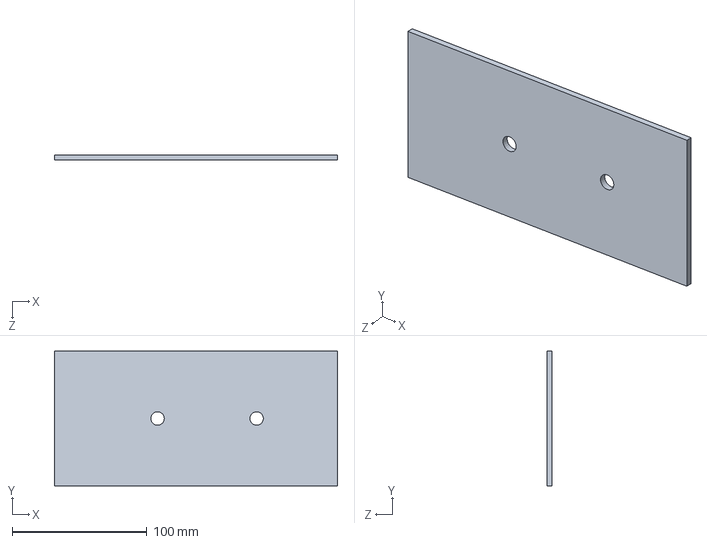
[picture p118: CAD file, 2022-07-11]
ByeDominoRobotOG/other/OGBackup/right-most-wall.SLDPRT
210.0 x 100.0 x 4.00 mm
