iseegr8tfuldeadppl/Kiwico/ByeDominoRobotOG/test parts/test_leg_gear.SLDPRT

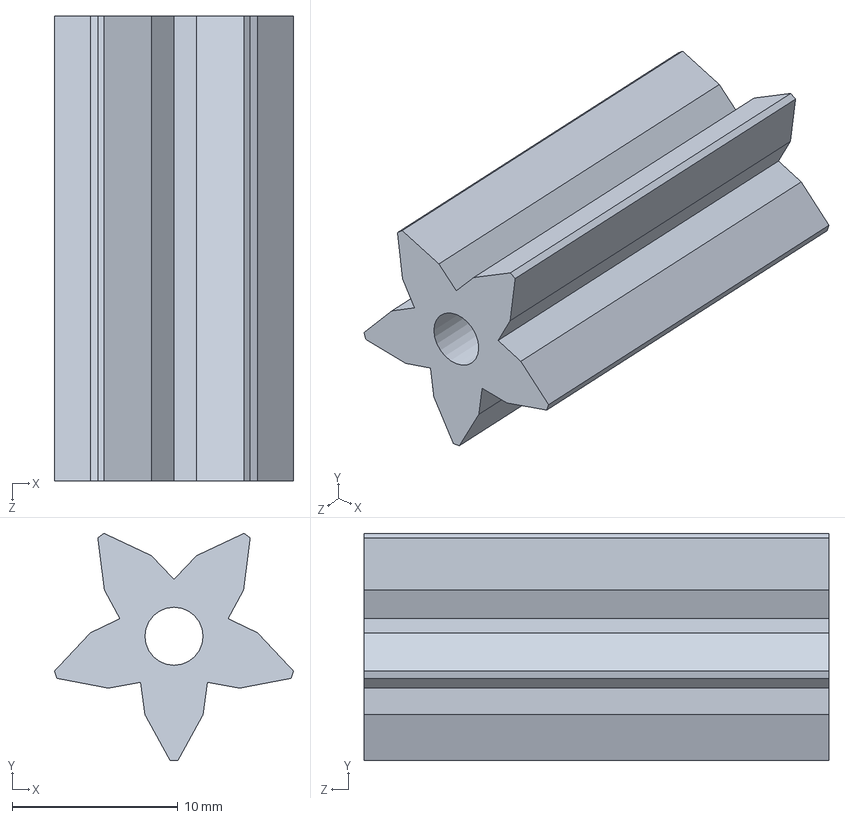
[picture p119: CAD file, 2022-07-19]
ByeDominoRobotOG/test parts/test_leg_gear.SLDPRT
14.4 x 13.7 x 28.0 mm
