iseegr8tfuldeadppl/Kiwico/connector.SLDPRT

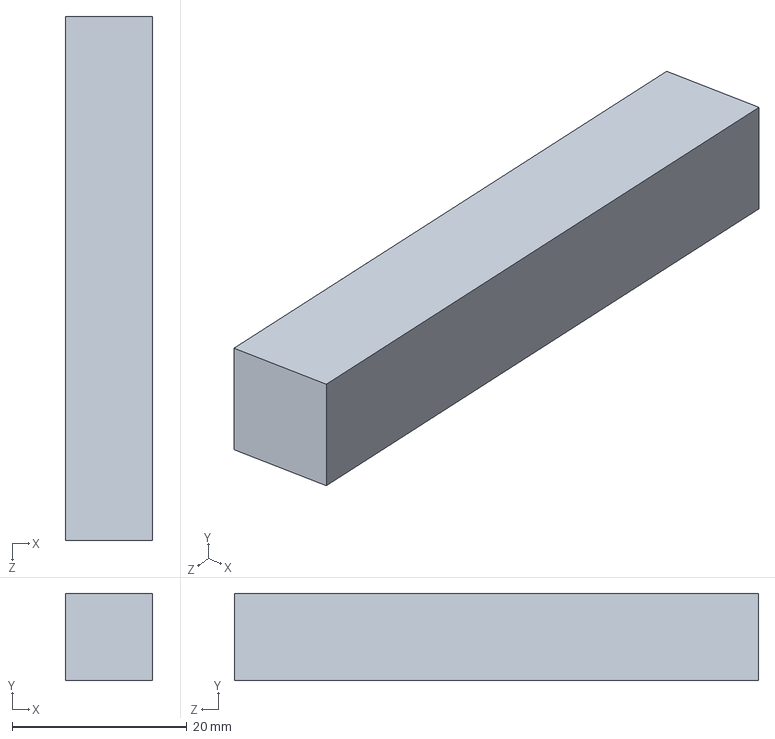
[picture p120: CAD file, 2022-07-11]
connector.SLDPRT
10.0 x 10.0 x 60.0 mm
