iseegr8tfuldeadppl/Kiwico/DominoRobotRework/sweep-gear-v.SLDPRT

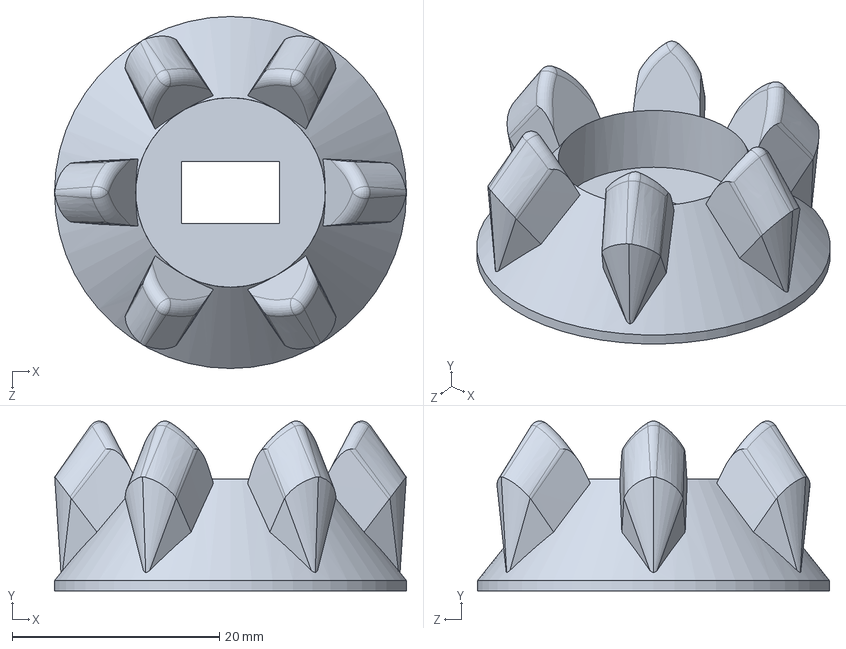
[picture p121: CAD file, 2023-03-17]
DominoRobotRework/sweep-gear-v.SLDPRT
34.0 x 16.4 x 34.0 mm
