iseegr8tfuldeadppl/Kiwico/other/BevelGearBackup.SLDPRT

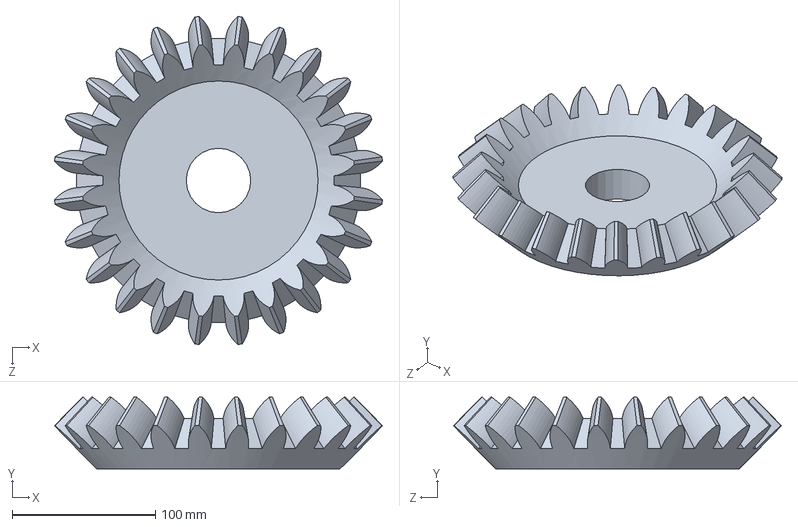
[picture p122: CAD file, 2022-07-11]
other/BevelGearBackup.SLDPRT
228.8 x 50.0 x 228.8 mm
