iseegr8tfuldeadppl/Kiwico/UselessBox/box_stationary_top.SLDPRT

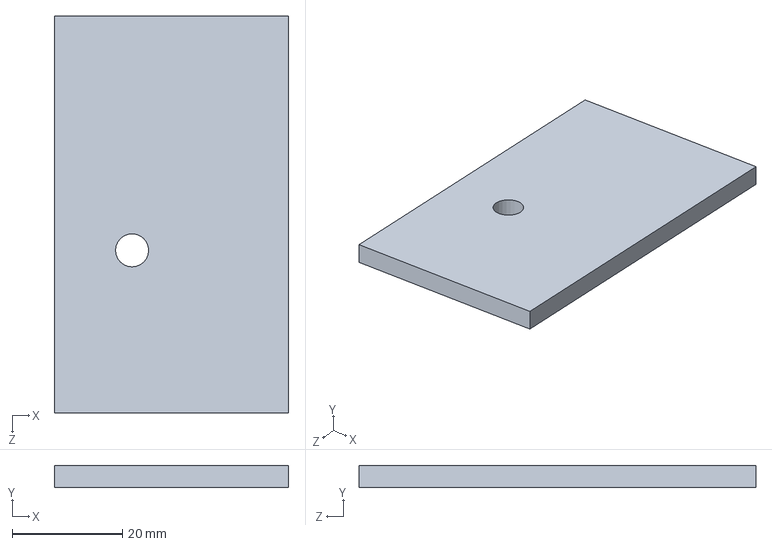
[picture p123: CAD file, 2022-09-25]
UselessBox/box_stationary_top.SLDPRT
42.5 x 4.00 x 72.0 mm
