iseegr8tfuldeadppl/Kiwico/ByeDominoRobotOG/other/OGBackup/rotating_plate.SLDPRT

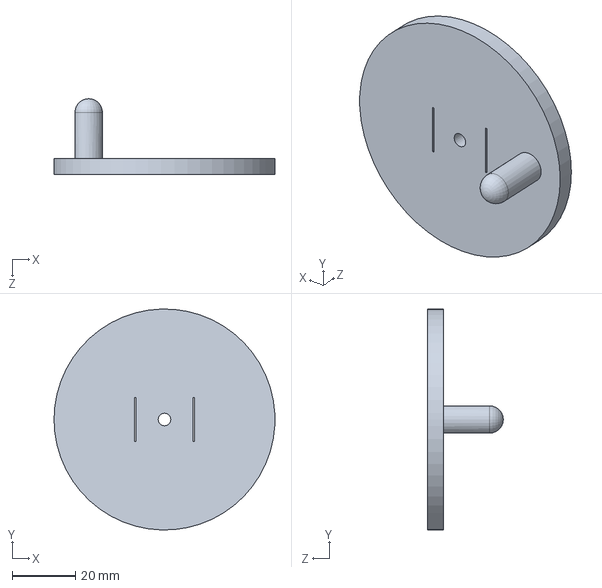
[picture p124: CAD file, 2022-07-11]
ByeDominoRobotOG/other/OGBackup/rotating_plate.SLDPRT
70.0 x 70.0 x 24.0 mm
