iseegr8tfuldeadppl/Kiwico/ByeDominoRobotOG/pinner.SLDPRT

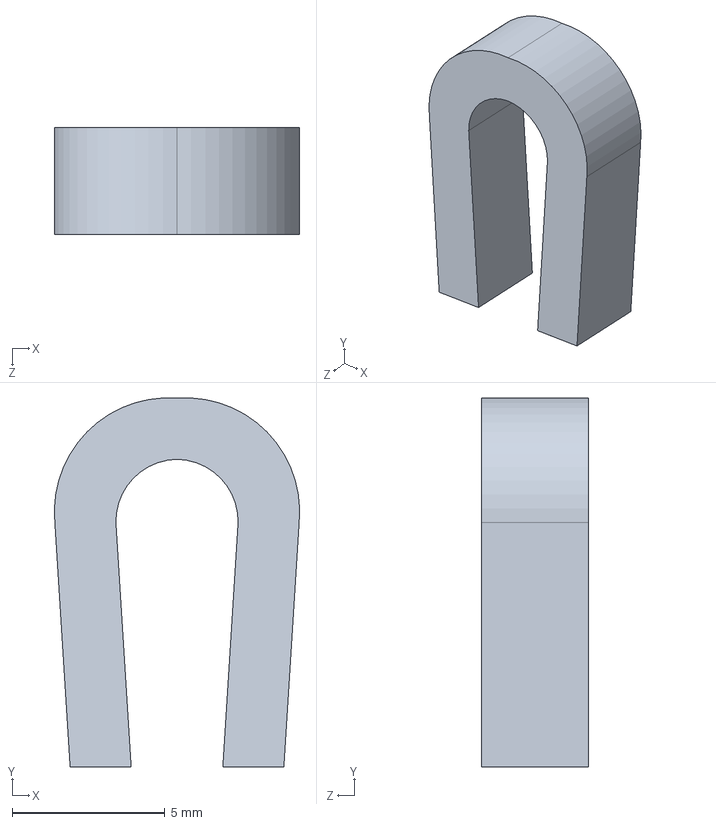
[picture p125: CAD file, 2022-10-12]
ByeDominoRobotOG/pinner.SLDPRT
8.03 x 12.1 x 3.50 mm
