iseegr8tfuldeadppl/Kiwico/DominoRobotRework/gear-back-plate-snap.SLDPRT

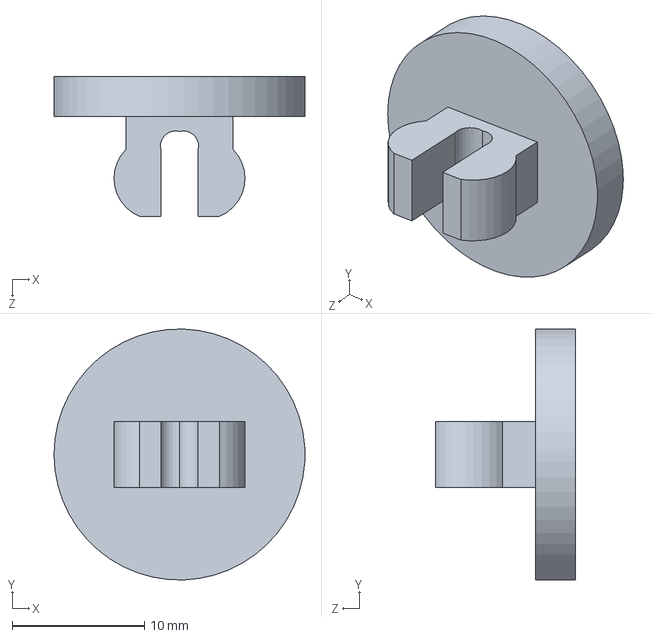
[picture p126: CAD file, 2023-03-17]
DominoRobotRework/gear-back-plate-snap.SLDPRT
19.0 x 19.0 x 10.6 mm
