iseegr8tfuldeadppl/Kiwico/gear_front_plate.SLDPRT

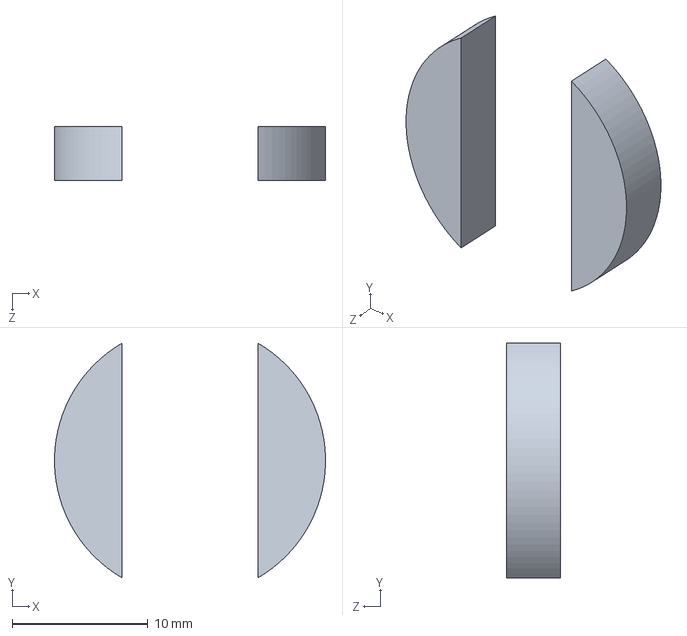
[picture p127: CAD file, 2022-07-11]
gear_front_plate.SLDPRT
20.0 x 17.3 x 4.00 mm
