iseegr8tfuldeadppl/Kiwico/UselessBox/motor.SLDPRT

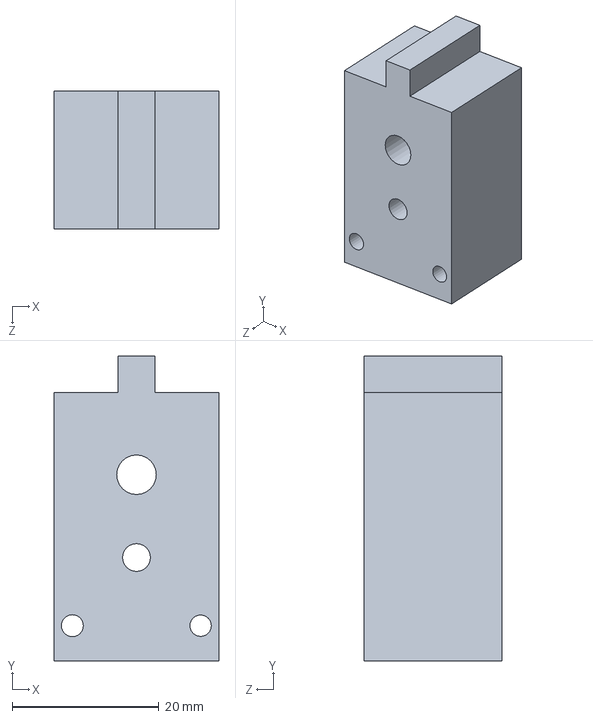
[picture p128: CAD file, 2022-09-19]
UselessBox/motor.SLDPRT
22.5 x 41.5 x 18.8 mm
