iseegr8tfuldeadppl/Kiwico/ByeDominoRobotOG/pre-leg-gear.SLDPRT

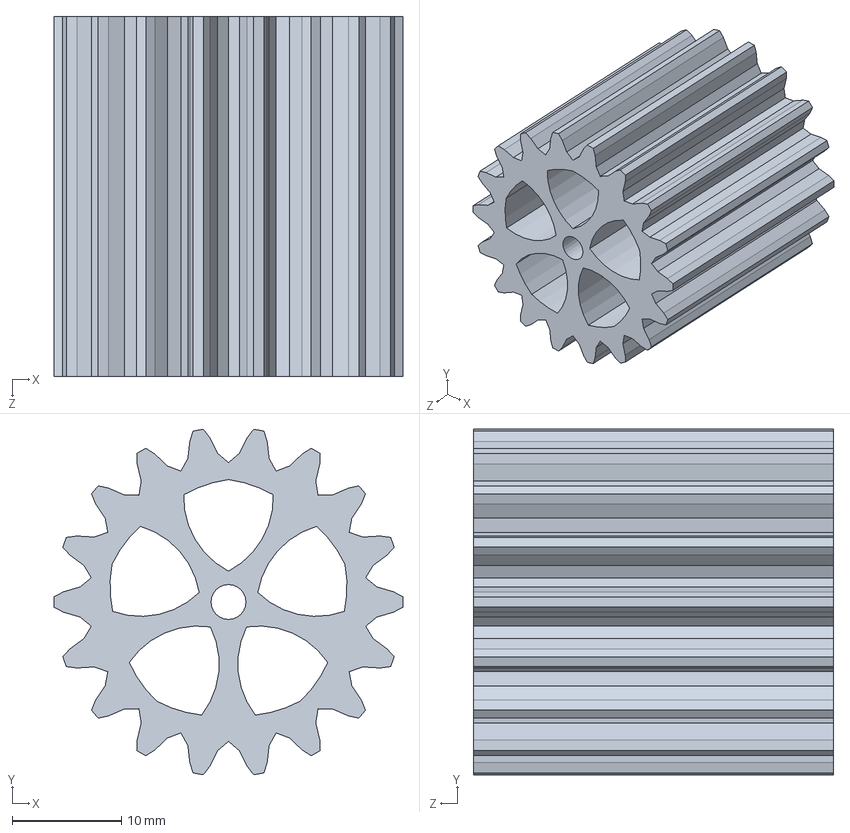
[picture p129: CAD file, 2022-10-12]
ByeDominoRobotOG/pre-leg-gear.SLDPRT
32.0 x 31.7 x 33.0 mm
