iseegr8tfuldeadppl/Kiwico/DominoRobotRework/smol-leg-gear-v.SLDPRT

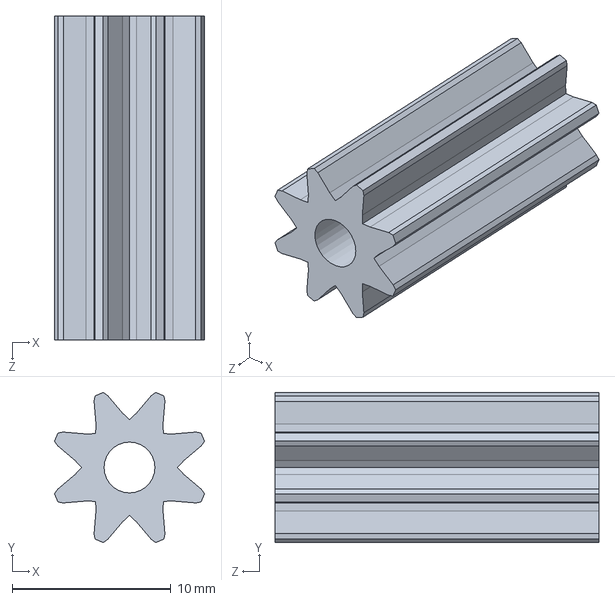
[picture p130: CAD file, 2023-03-17]
DominoRobotRework/smol-leg-gear-v.SLDPRT
9.44 x 9.44 x 20.4 mm
