iseegr8tfuldeadppl/Kiwico/UselessBox/TT Motor-n.SLDPRT

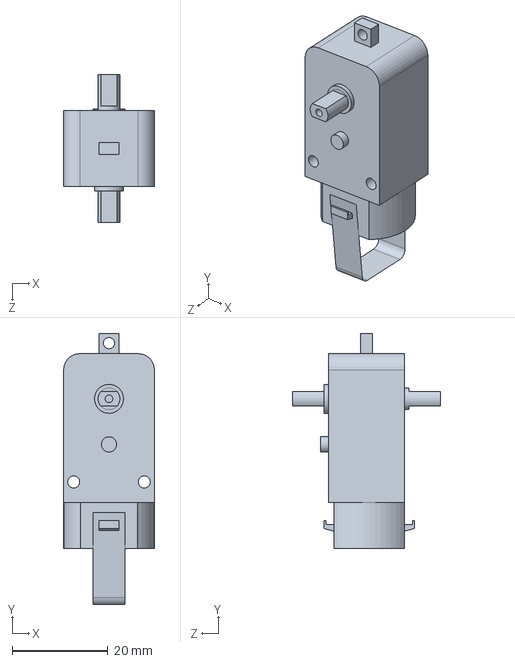
[picture p131: CAD file, 2022-09-19]
UselessBox/TT Motor-n.SLDPRT
19.0 x 56.7 x 31.1 mm
