iseegr8tfuldeadppl/Kiwico/ByeDominoRobotOG/front-wall-n.SLDPRT

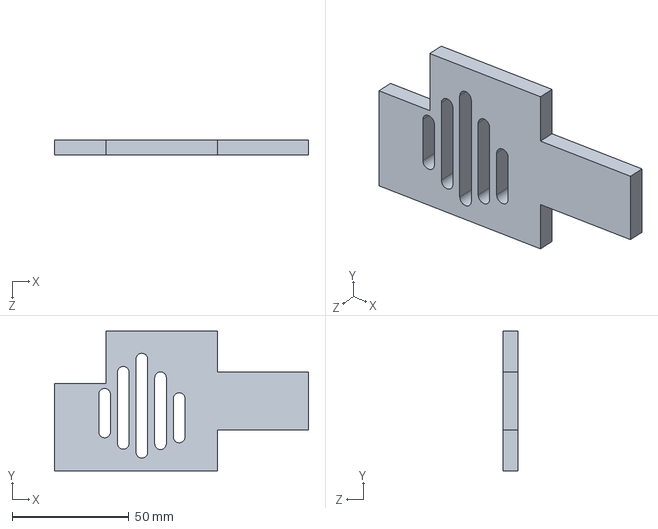
[picture p132: CAD file, 2022-10-11]
ByeDominoRobotOG/front-wall-n.SLDPRT
109.0 x 60.0 x 6.40 mm
