iseegr8tfuldeadppl/Kiwico/ByeDominoRobotOG/other/OGBackup/BevelGear.SLDPRT

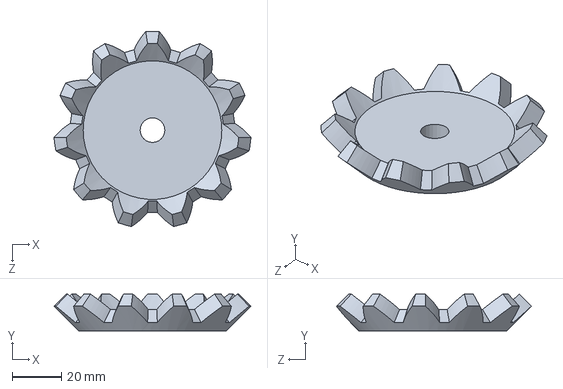
[picture p133: CAD file, 2022-07-11]
ByeDominoRobotOG/other/OGBackup/BevelGear.SLDPRT
79.9 x 15.0 x 79.1 mm
