iseegr8tfuldeadppl/Kiwico/DominoRobotRework/wheel-v.SLDPRT

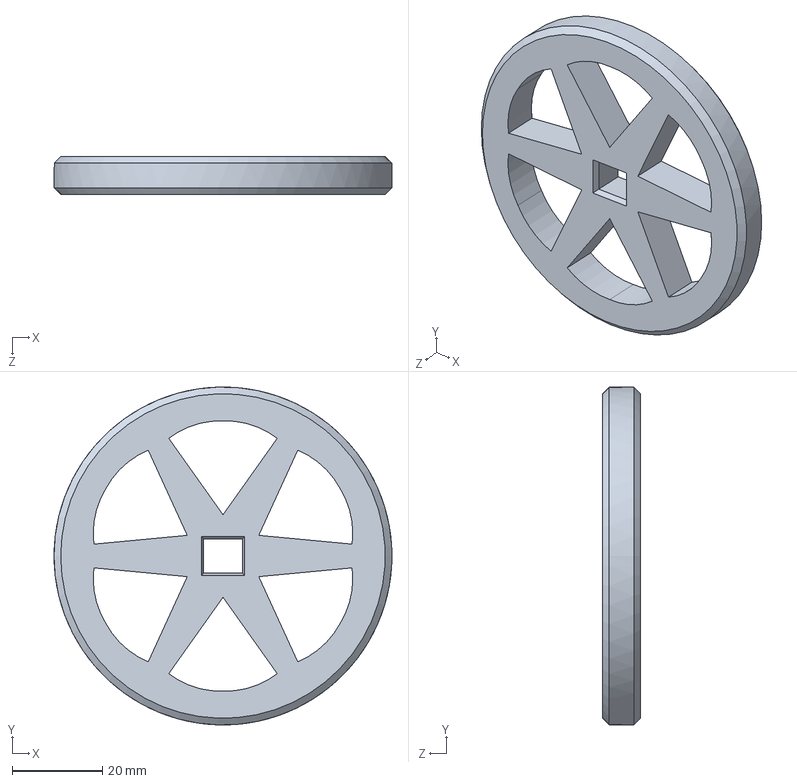
[picture p134: CAD file, 2023-03-17]
DominoRobotRework/wheel-v.SLDPRT
75.0 x 75.0 x 8.50 mm
