iseegr8tfuldeadppl/Kiwico/other/TT Motor.step

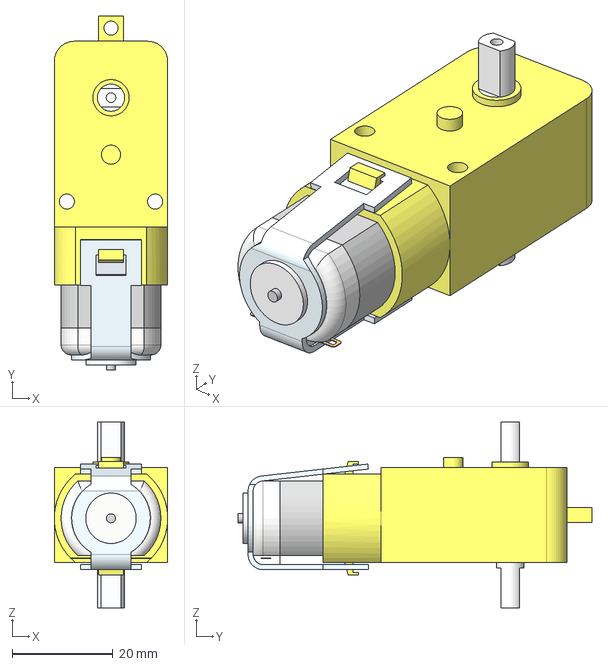
[picture p135: CAD file, 2022-07-11]
other/TT Motor.step
22.5 x 70.2 x 36.8 mm
