iseegr8tfuldeadppl/Kiwico/UselessBox/motor_axis.SLDPRT

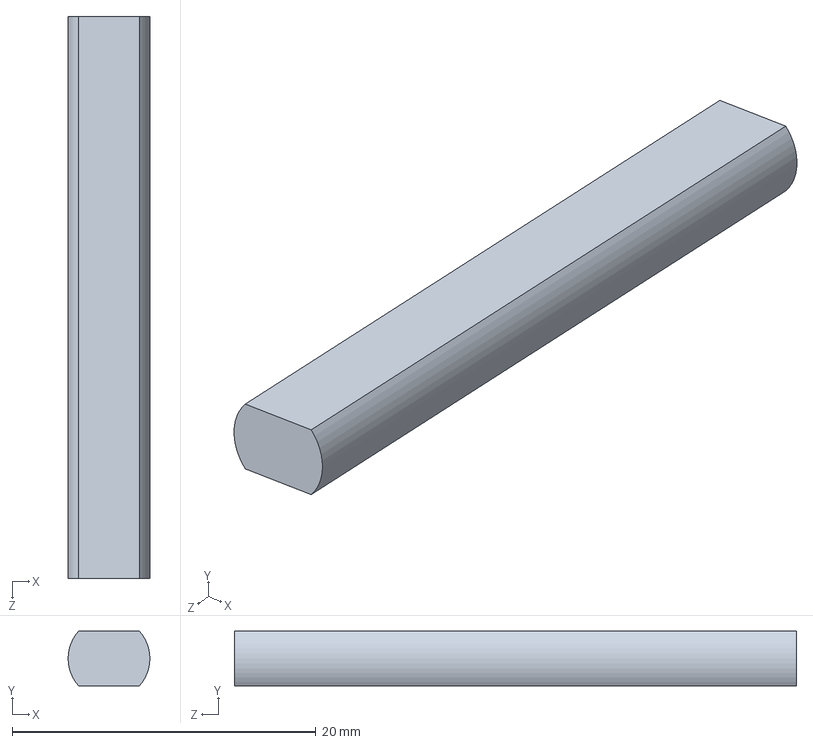
[picture p136: CAD file, 2022-09-19]
UselessBox/motor_axis.SLDPRT
5.39 x 3.59 x 37.0 mm
