iseegr8tfuldeadppl/Kiwico/ByeDominoRobotOG/domino.SLDPRT

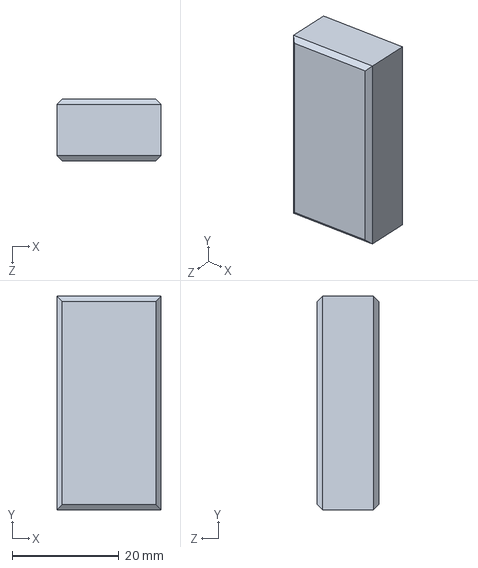
[picture p137: CAD file, 2022-10-11]
ByeDominoRobotOG/domino.SLDPRT
19.5 x 40.0 x 11.5 mm
