iseegr8tfuldeadppl/Kiwico/DominoRobotRework/pre-leg-gear-v.SLDPRT

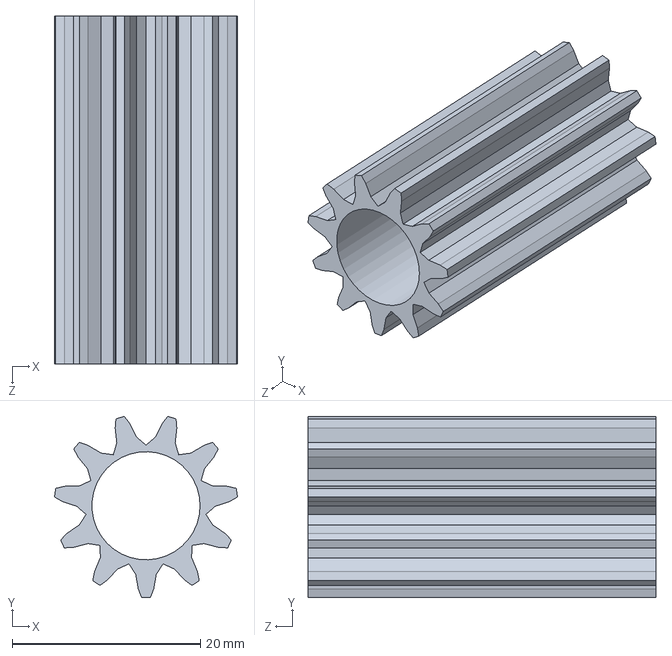
[picture p138: CAD file, 2023-03-17]
DominoRobotRework/pre-leg-gear-v.SLDPRT
19.5 x 19.3 x 37.0 mm
