iseegr8tfuldeadppl/Kiwico/UselessBox/motor_holder.SLDPRT

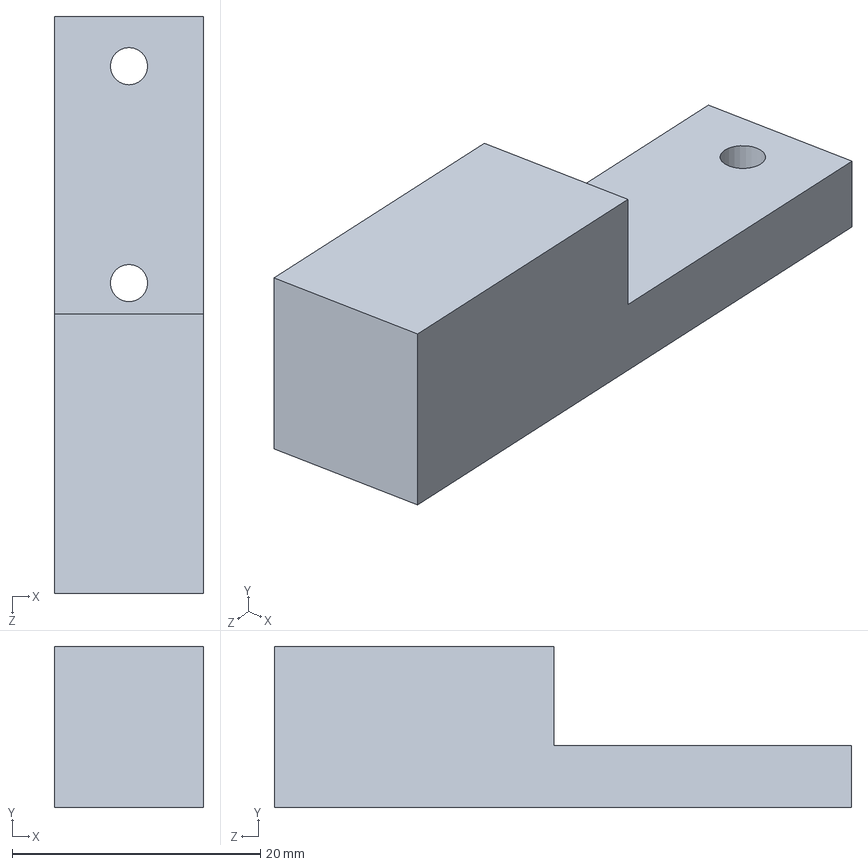
[picture p139: CAD file, 2022-09-19]
UselessBox/motor_holder.SLDPRT
12.0 x 13.0 x 46.5 mm
