iseegr8tfuldeadppl/Kiwico/ByeDominoRobotOG/other/OGBackup/pin.SLDPRT

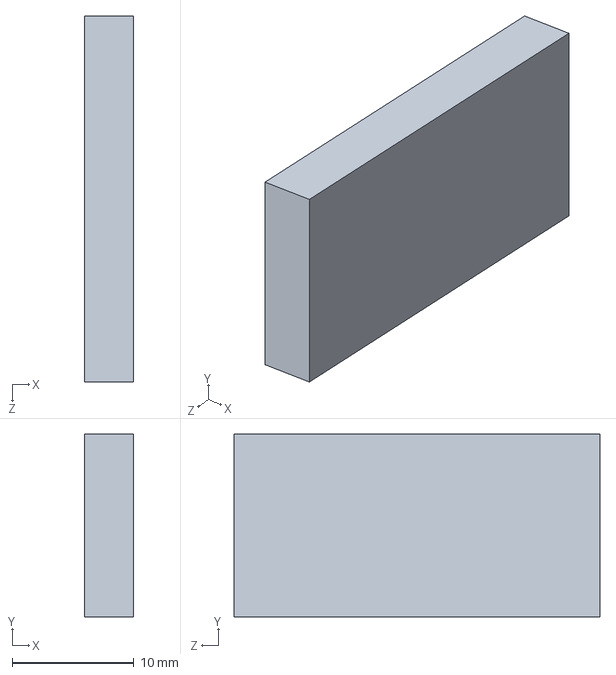
[picture p140: CAD file, 2022-07-11]
ByeDominoRobotOG/other/OGBackup/pin.SLDPRT
4.00 x 15.0 x 30.0 mm
