iseegr8tfuldeadppl/Kiwico/ByeDominoRobotOG/tiny_wheel.SLDPRT

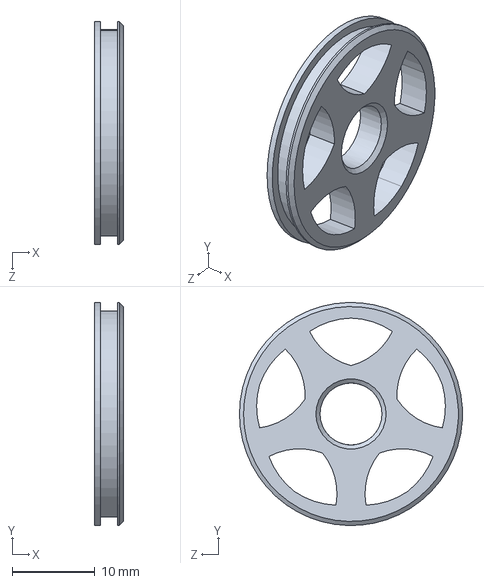
[picture p141: CAD file, 2022-10-11]
ByeDominoRobotOG/tiny_wheel.SLDPRT
3.50 x 27.0 x 27.0 mm
