iseegr8tfuldeadppl/Kiwico/DominoRobotRework/pin-v.SLDPRT

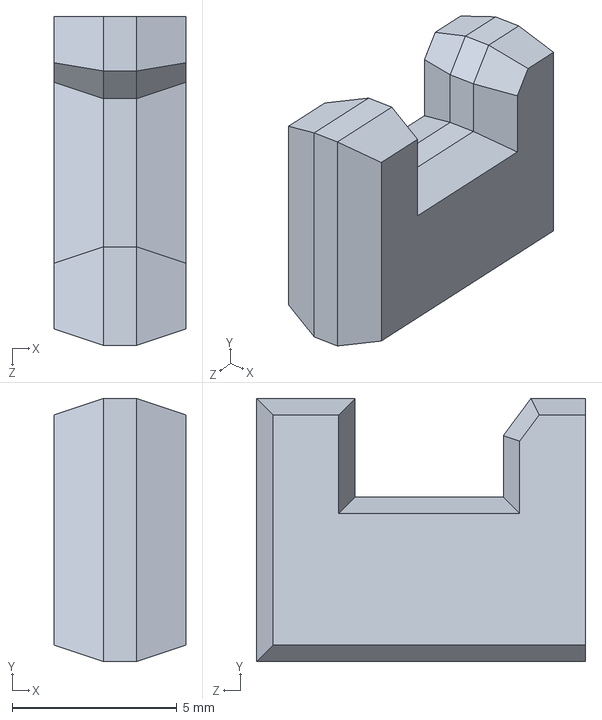
[picture p142: CAD file, 2023-03-17]
DominoRobotRework/pin-v.SLDPRT
4.00 x 8.00 x 10.0 mm
