iseegr8tfuldeadppl/Kiwico/ByeDominoRobotOG/other/OGBackup/wheel.SLDPRT

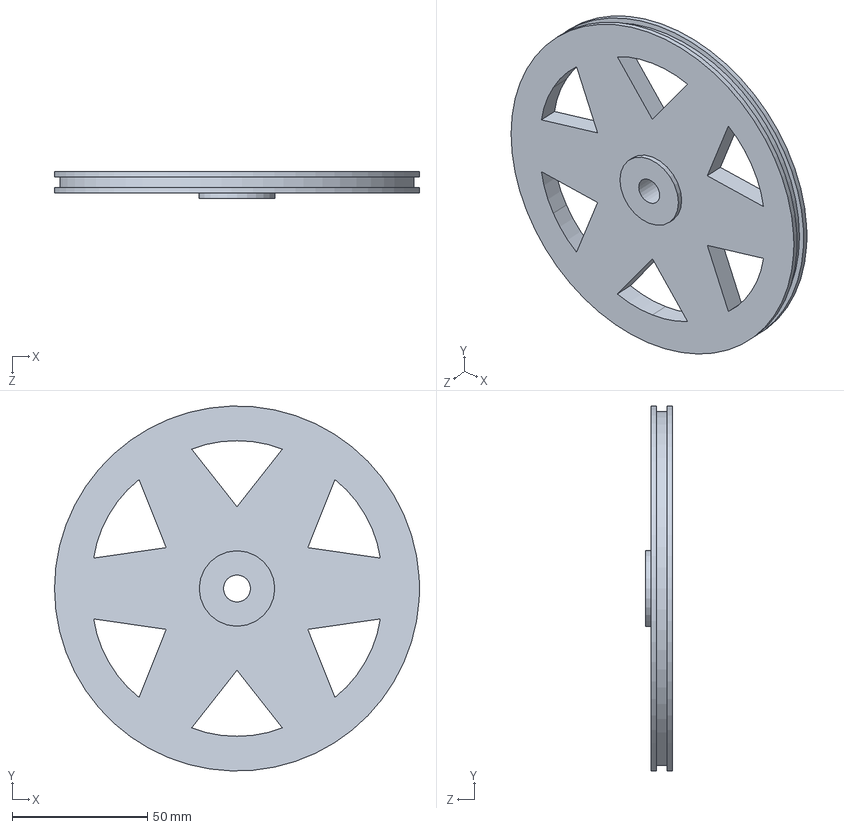
[picture p143: CAD file, 2022-07-11]
ByeDominoRobotOG/other/OGBackup/wheel.SLDPRT
135.0 x 134.9 x 10.0 mm
