iseegr8tfuldeadppl/Kiwico/ByeDominoRobotOG/right-most-wall-n.SLDPRT

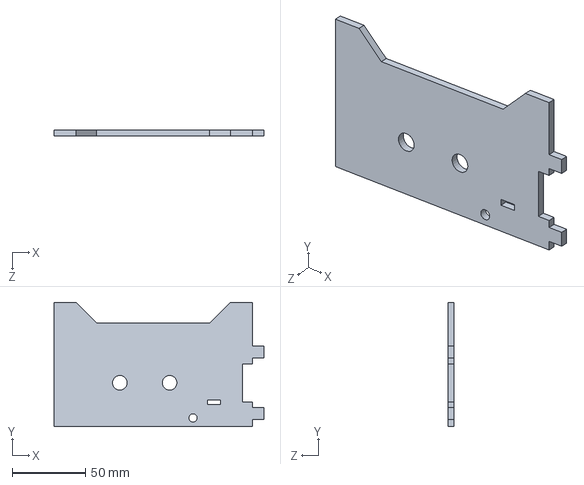
[picture p144: CAD file, 2022-10-09]
ByeDominoRobotOG/right-most-wall-n.SLDPRT
143.5 x 85.0 x 4.00 mm
