iseegr8tfuldeadppl/Kiwico/ByeDominoRobotOG/right-wall-n.SLDPRT

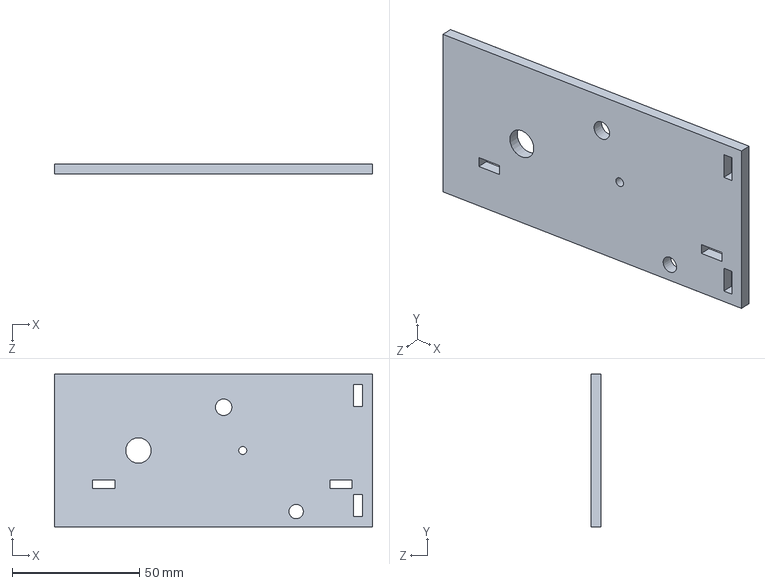
[picture p145: CAD file, 2022-10-09]
ByeDominoRobotOG/right-wall-n.SLDPRT
125.0 x 60.0 x 4.00 mm
