iseegr8tfuldeadppl/Kiwico/DominoRobotRework/axis-v.SLDPRT

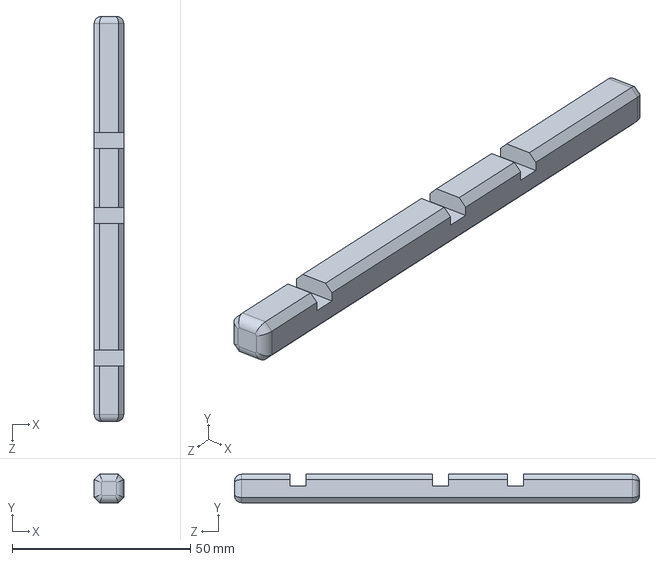
[picture p146: CAD file, 2023-03-17]
DominoRobotRework/axis-v.SLDPRT
8.30 x 8.00 x 113.5 mm
