iseegr8tfuldeadppl/Kiwico/ByeDominoRobotOG/TT Motor-n.SLDPRT

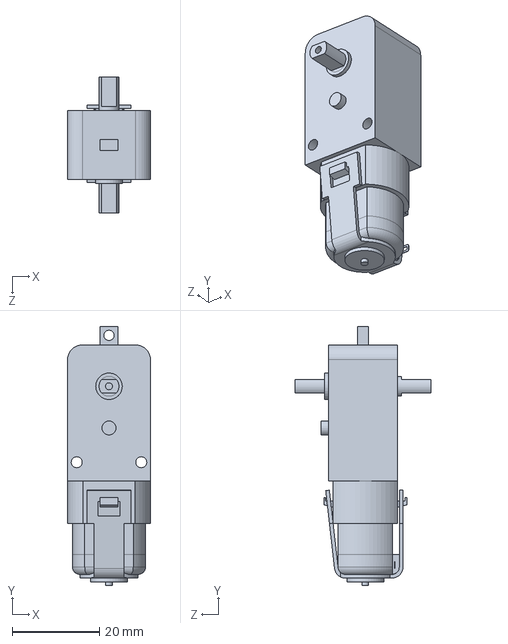
[picture p147: CAD file, 2022-10-09]
ByeDominoRobotOG/TT Motor-n.SLDPRT
19.0 x 59.3 x 31.1 mm
