iseegr8tfuldeadppl/Kiwico/ByeDominoRobotOG/motor-gear.SLDPRT

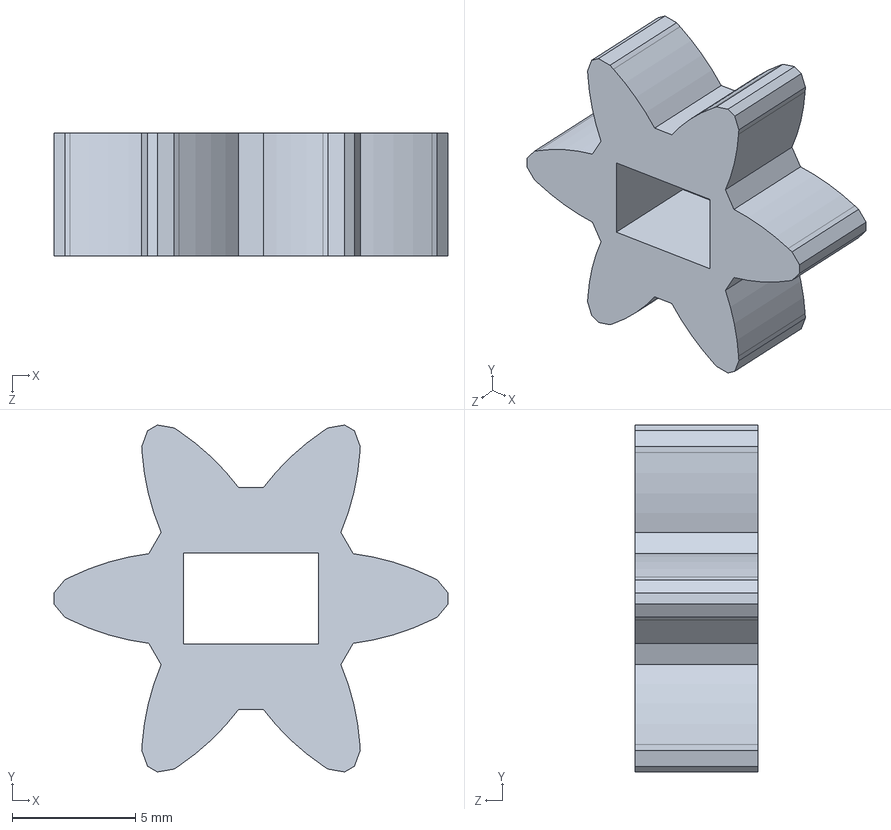
[picture p148: CAD file, 2022-10-09]
ByeDominoRobotOG/motor-gear.SLDPRT
16.0 x 14.1 x 5.00 mm
