iseegr8tfuldeadppl/Kiwico/DominoRobotRework/motors_gear-v.SLDPRT

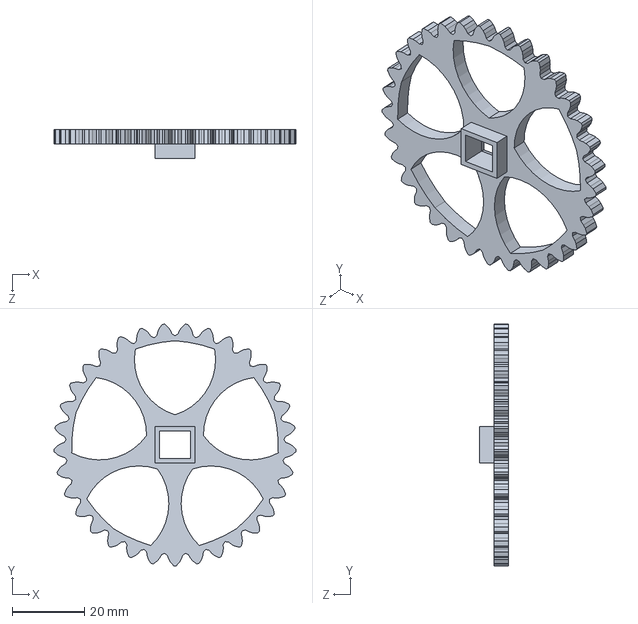
[picture p149: CAD file, 2023-03-17]
DominoRobotRework/motors_gear-v.SLDPRT
67.2 x 67.1 x 8.00 mm
