iseegr8tfuldeadppl/Kiwico/ByeDominoRobotOG/other/OGBackup/gear_back_plate.SLDPRT

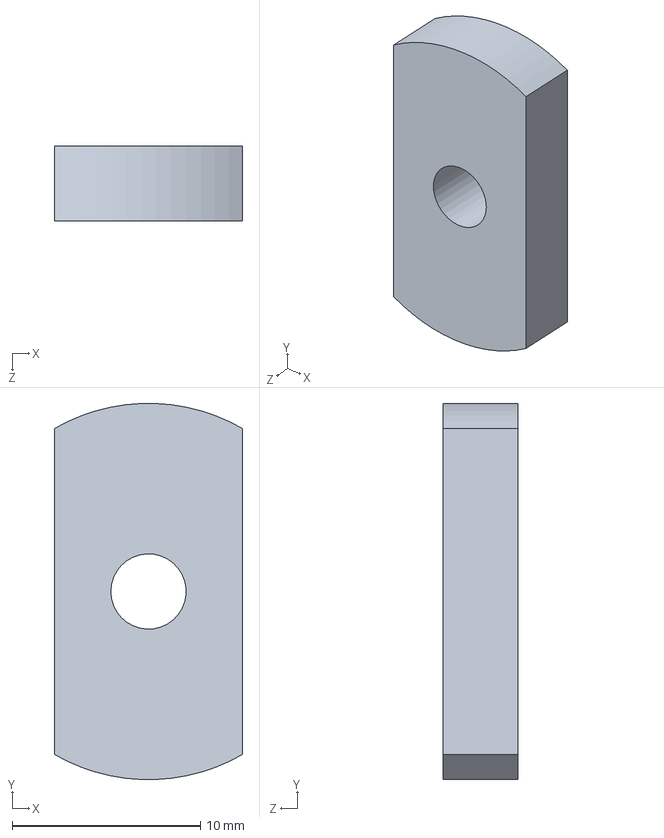
[picture p150: CAD file, 2022-07-11]
ByeDominoRobotOG/other/OGBackup/gear_back_plate.SLDPRT
10.0 x 20.0 x 4.00 mm
