iseegr8tfuldeadppl/Kiwico/DominoRobotRework/left-most-wall-v.SLDPRT

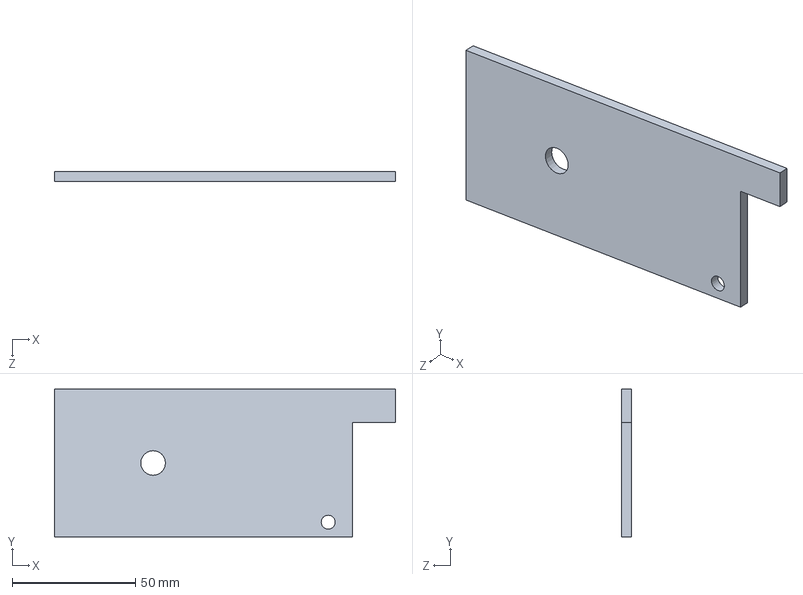
[picture p151: CAD file, 2023-03-17]
DominoRobotRework/left-most-wall-v.SLDPRT
138.3 x 60.0 x 4.00 mm
