iseegr8tfuldeadppl/Kiwico/front-wall.SLDPRT

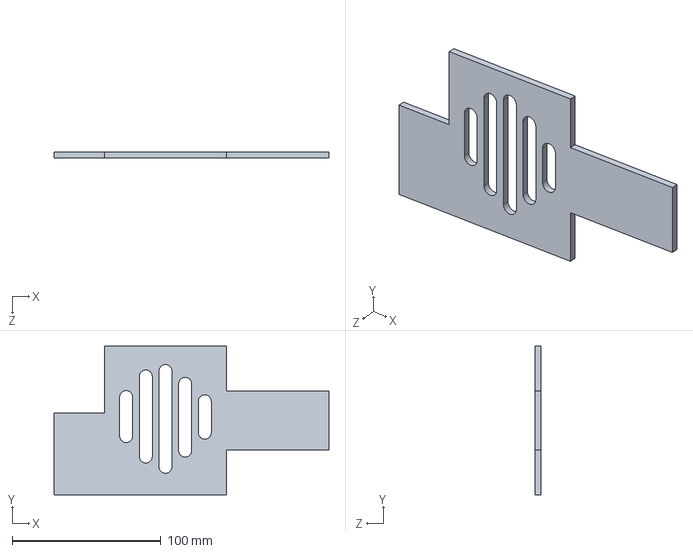
[picture p152: CAD file, 2022-07-11]
front-wall.SLDPRT
185.0 x 100.0 x 4.00 mm
