iseegr8tfuldeadppl/Kiwico/ByeDominoRobotOG/floor.SLDPRT

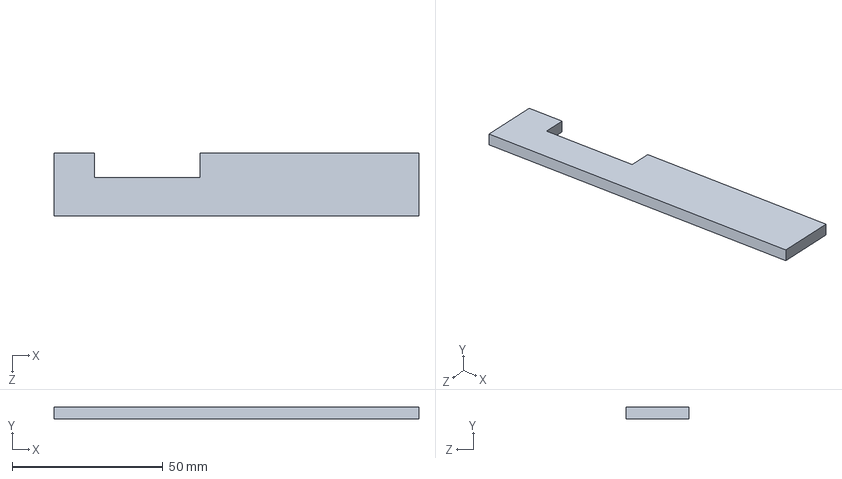
[picture p153: CAD file, 2022-10-02]
ByeDominoRobotOG/floor.SLDPRT
121.0 x 4.00 x 21.0 mm
