iseegr8tfuldeadppl/Kiwico/DominoRobotRework/large_wheel_sock.SLDPRT

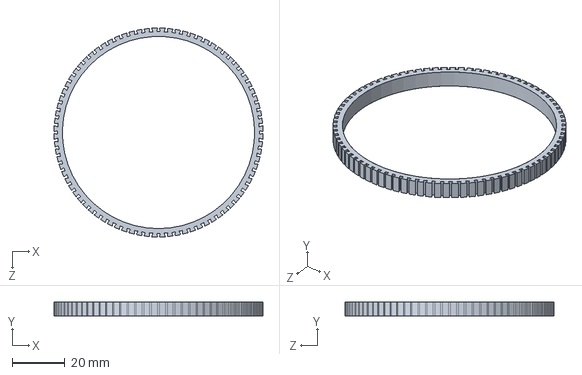
[picture p154: CAD file, 2023-03-10]
DominoRobotRework/large_wheel_sock.SLDPRT
79.4 x 5.50 x 79.4 mm
