iseegr8tfuldeadppl/Kiwico/ByeDominoRobotOG/wheel-n.SLDPRT

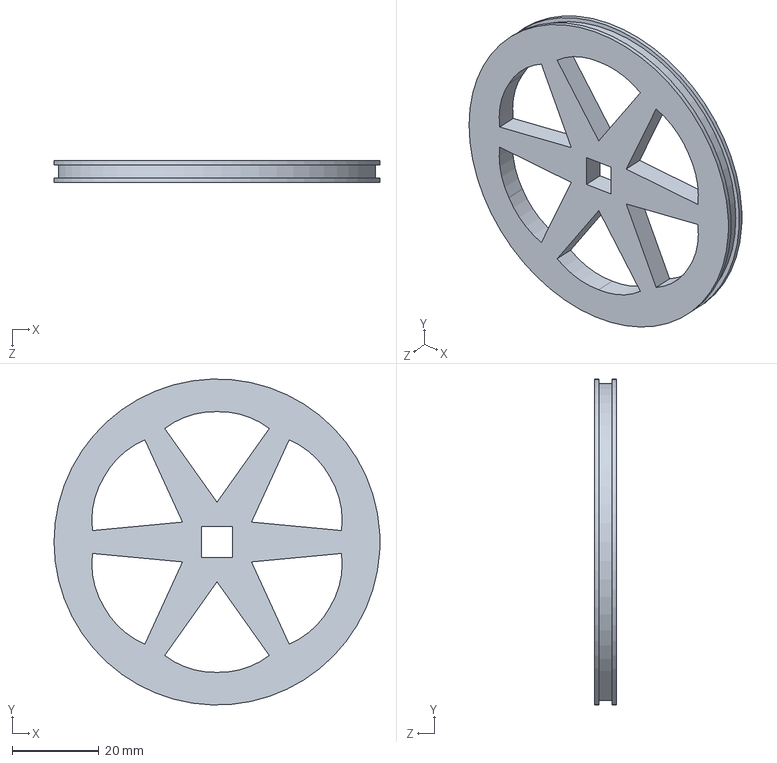
[picture p155: CAD file, 2022-10-02]
ByeDominoRobotOG/wheel-n.SLDPRT
75.0 x 75.0 x 5.00 mm
