iseegr8tfuldeadppl/Kiwico/DominoRobotRework/right_small_wheel_sock.SLDPRT

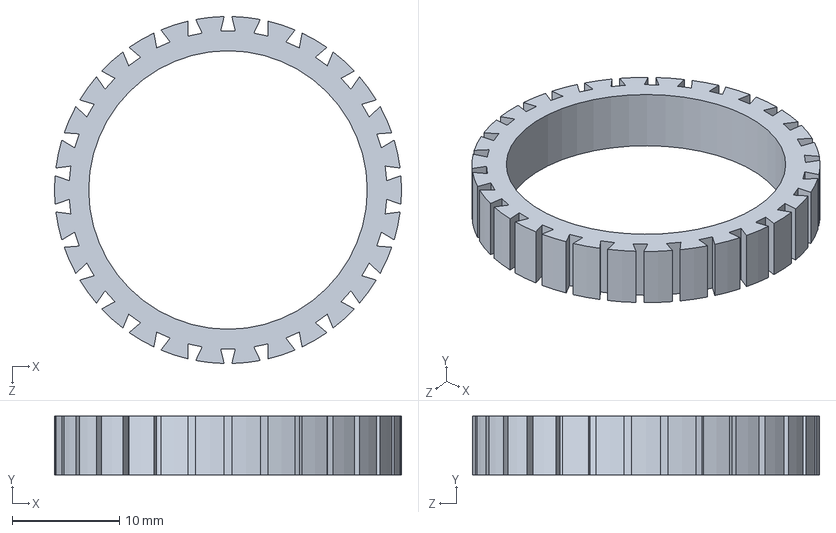
[picture p156: CAD file, 2023-03-07]
DominoRobotRework/right_small_wheel_sock.SLDPRT
32.4 x 5.50 x 32.4 mm
