iseegr8tfuldeadppl/Kiwico/separator.SLDPRT

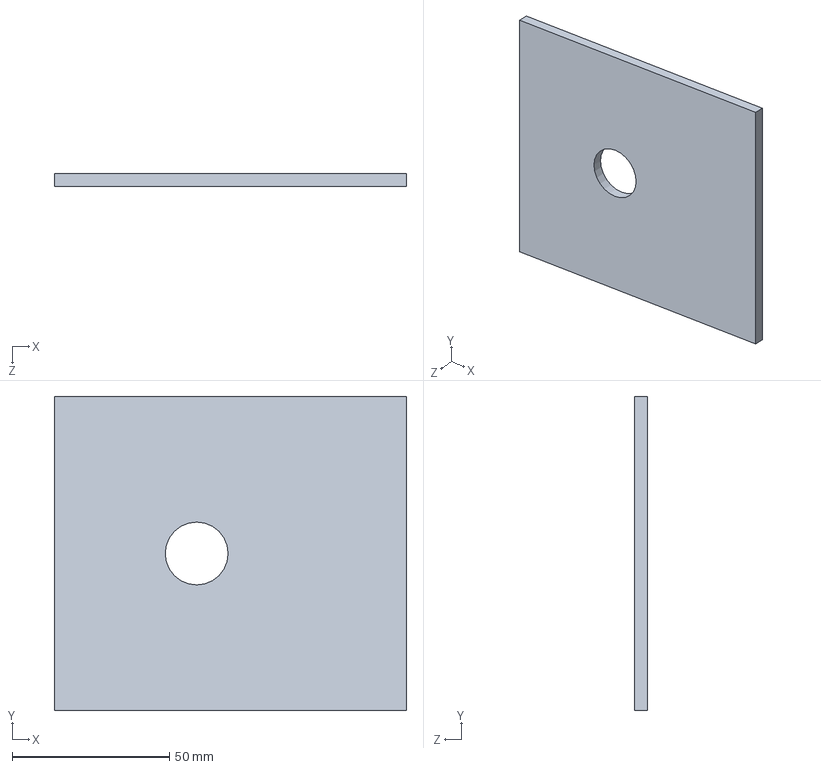
[picture p157: CAD file, 2022-07-11]
separator.SLDPRT
112.0 x 100.0 x 4.00 mm
