iseegr8tfuldeadppl/Kiwico/ByeDominoRobotOG/axis.SLDPRT

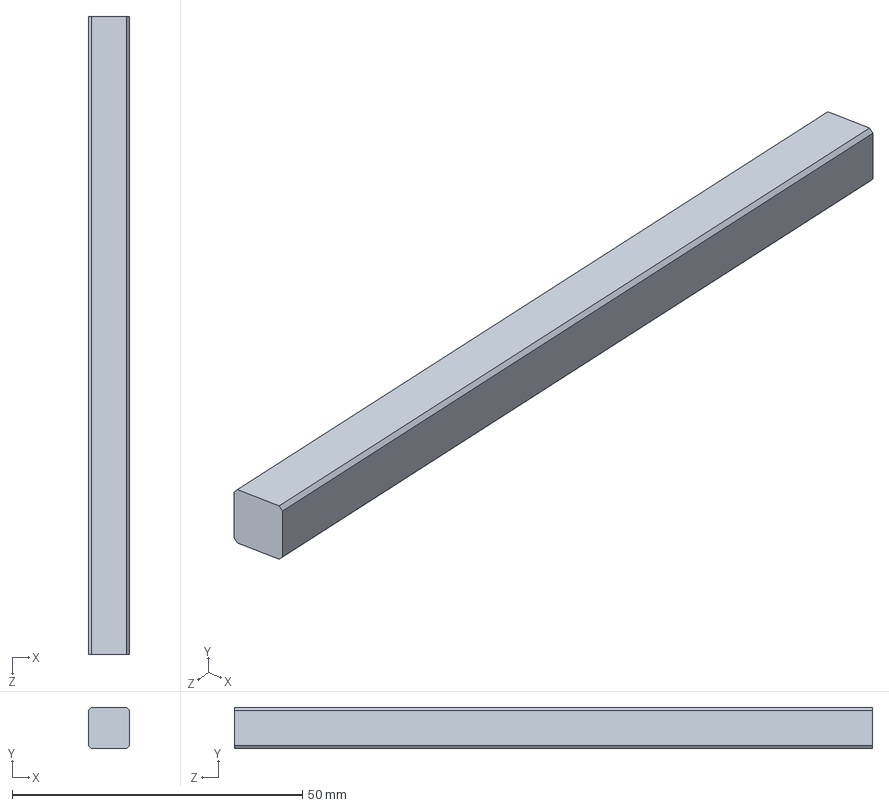
[picture p158: CAD file, 2022-09-28]
ByeDominoRobotOG/axis.SLDPRT
7.07 x 7.07 x 110.0 mm
