iseegr8tfuldeadppl/Kiwico/DominoRobotRework/left-wall-v.SLDPRT

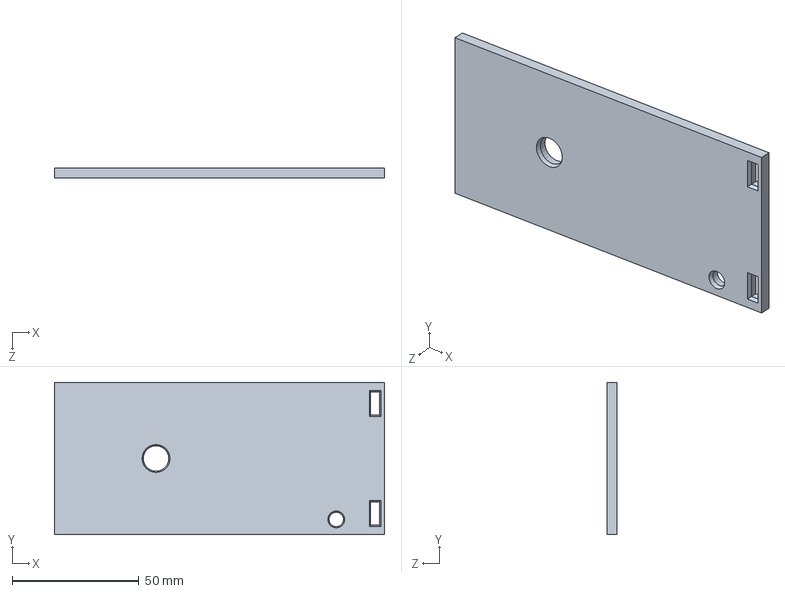
[picture p159: CAD file, 2023-03-07]
DominoRobotRework/left-wall-v.SLDPRT
130.0 x 60.0 x 4.00 mm
