iseegr8tfuldeadppl/Kiwico/ByeDominoRobotOG/sweep-gear.SLDPRT

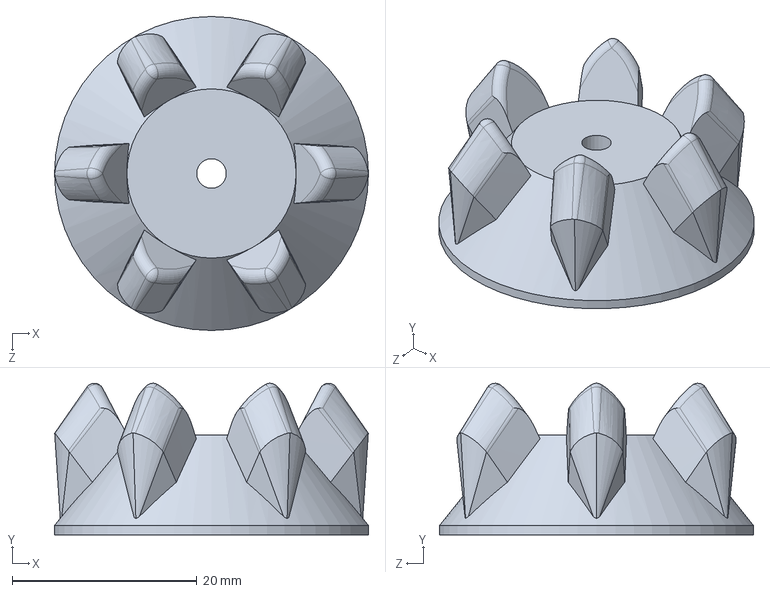
[picture p160: CAD file, 2022-09-27]
ByeDominoRobotOG/sweep-gear.SLDPRT
34.0 x 16.4 x 34.0 mm
