iseegr8tfuldeadppl/Kiwico/ByeDominoRobotOG/new-good-gear.SLDPRT

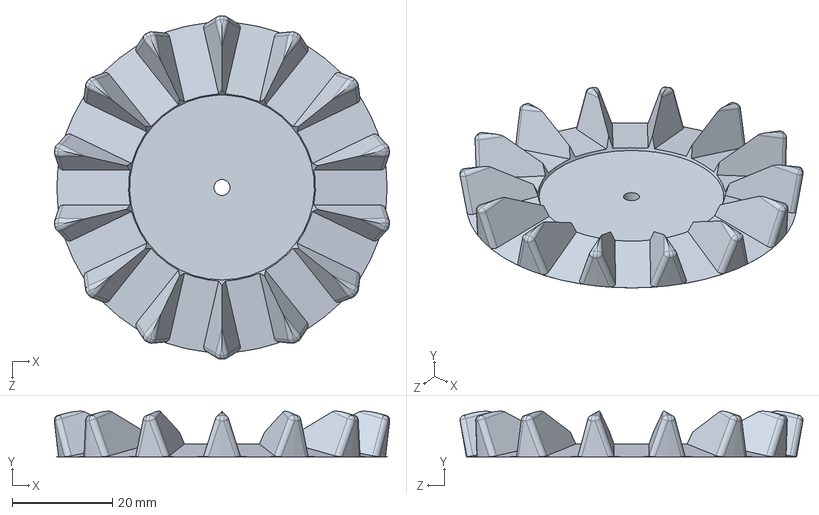
[picture p161: CAD file, 2022-09-27]
ByeDominoRobotOG/new-good-gear.SLDPRT
67.0 x 9.14 x 68.5 mm
