iseegr8tfuldeadppl/Kiwico/ByeDominoRobotOG/separator-n.SLDPRT

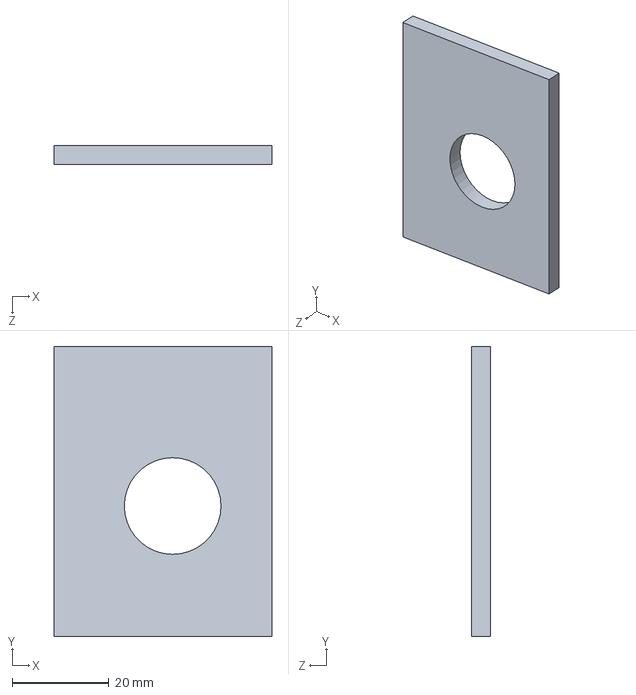
[picture p162: CAD file, 2022-09-27]
ByeDominoRobotOG/separator-n.SLDPRT
45.0 x 60.0 x 4.00 mm
