iseegr8tfuldeadppl/Kiwico/DominoRobotRework/4mm_pin-v.SLDPRT

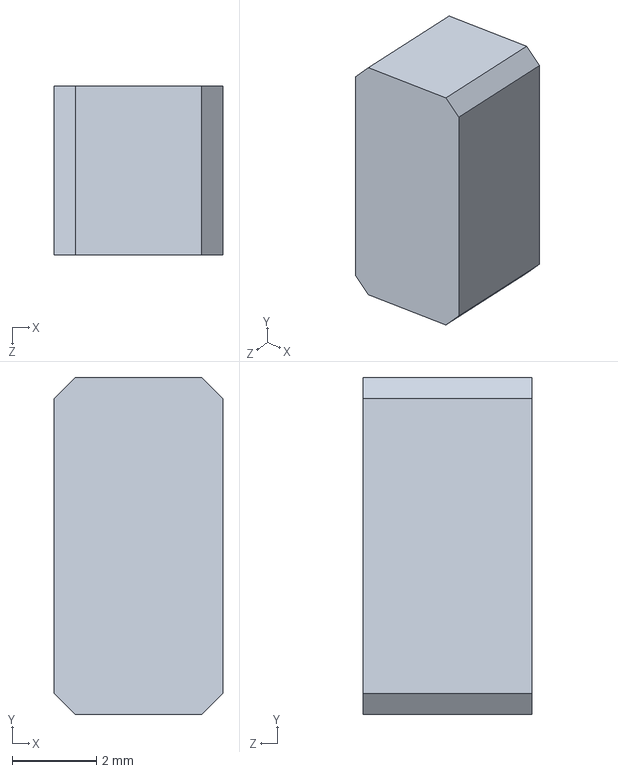
[picture p163: CAD file, 2023-03-07]
DominoRobotRework/4mm_pin-v.SLDPRT
4.00 x 8.00 x 4.00 mm
