iseegr8tfuldeadppl/Kiwico/DominoRobotRework/right-tiny_wheel-v.SLDPRT

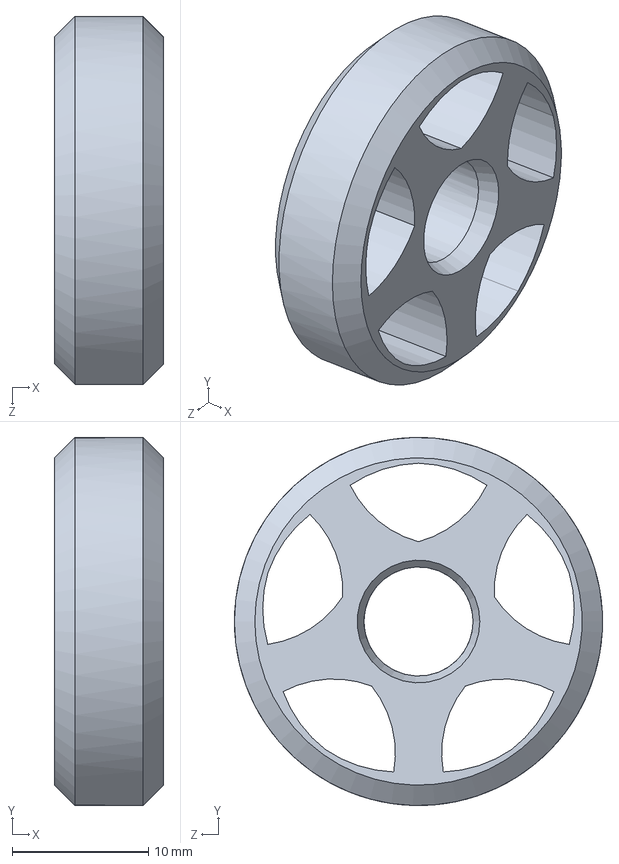
[picture p164: CAD file, 2023-03-07]
DominoRobotRework/right-tiny_wheel-v.SLDPRT
8.00 x 27.0 x 27.0 mm
