iseegr8tfuldeadppl/Kiwico/DominoRobotRework/linear-gear.SLDPRT

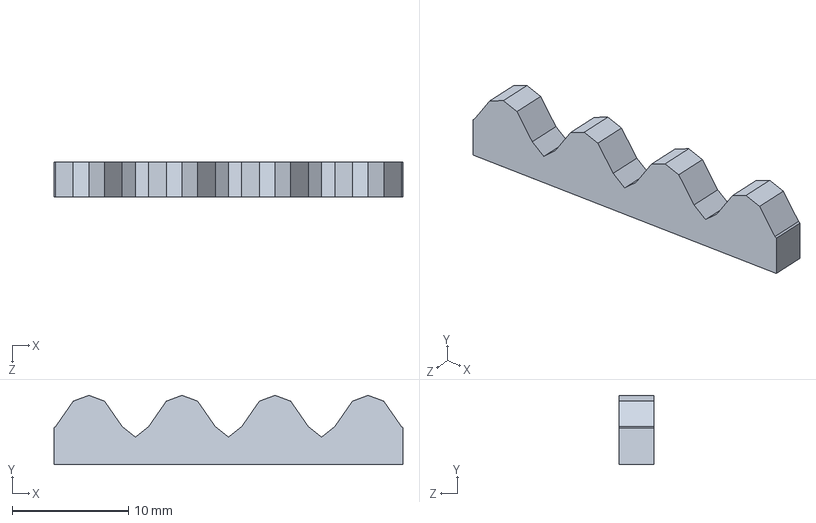
[picture p165: CAD file, 2022-12-05]
DominoRobotRework/linear-gear.SLDPRT
30.0 x 5.96 x 3.00 mm
