iseegr8tfuldeadppl/Kiwico/ByeDominoRobotOG/mySquashedBevelMarkedGear.SLDPRT

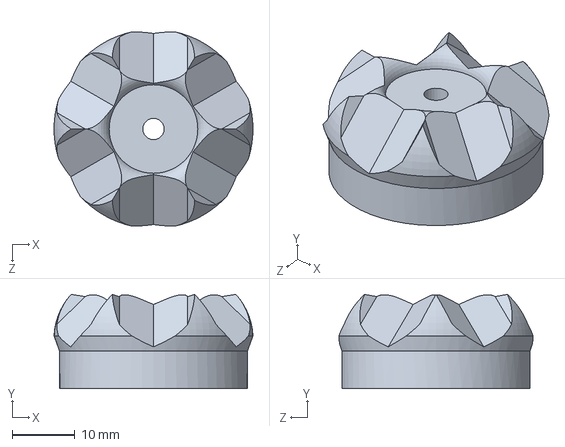
[picture p166: CAD file, 2022-09-24]
ByeDominoRobotOG/mySquashedBevelMarkedGear.SLDPRT
31.8 x 15.0 x 31.0 mm
