iseegr8tfuldeadppl/Kiwico/DominoRobotRework/domino-v.SLDPRT

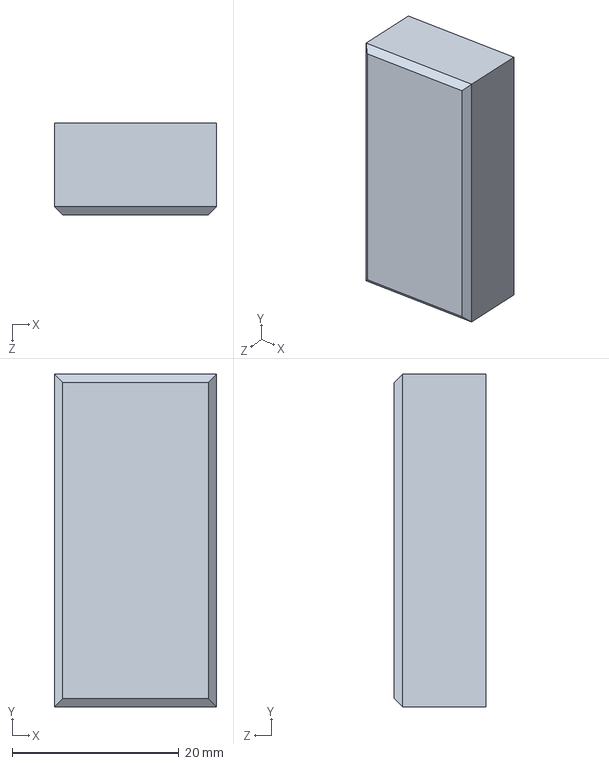
[picture p167: CAD file, 2022-12-05]
DominoRobotRework/domino-v.SLDPRT
19.5 x 40.0 x 11.0 mm
