iseegr8tfuldeadppl/Kiwico/DominoRobotRework/motor-gear-v.SLDPRT

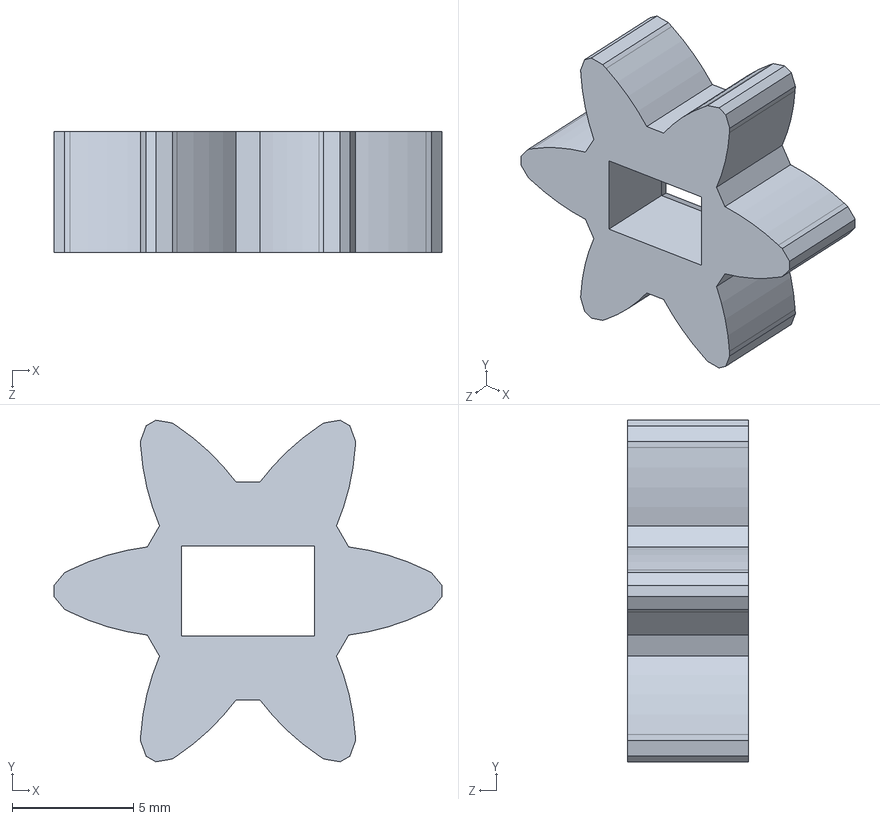
[picture p168: CAD file, 2022-12-05]
DominoRobotRework/motor-gear-v.SLDPRT
16.0 x 14.1 x 5.00 mm
