iseegr8tfuldeadppl/Kiwico/ByeDominoRobotOG/rotating_plate-n.SLDPRT

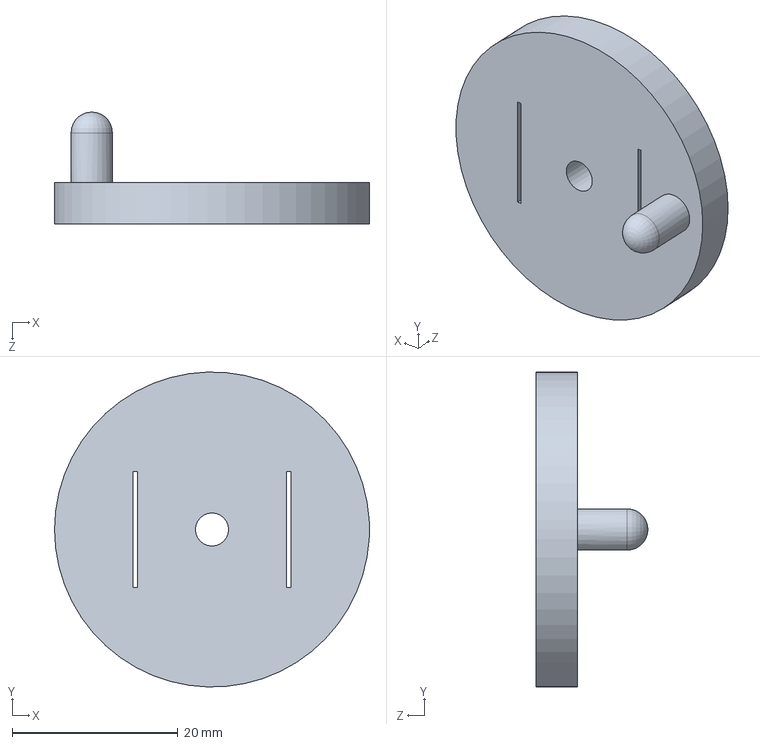
[picture p169: CAD file, 2022-09-23]
ByeDominoRobotOG/rotating_plate-n.SLDPRT
38.0 x 38.0 x 13.5 mm
