iseegr8tfuldeadppl/Kiwico/DominoRobotRework/right_small_wheel_axis-v.SLDPRT

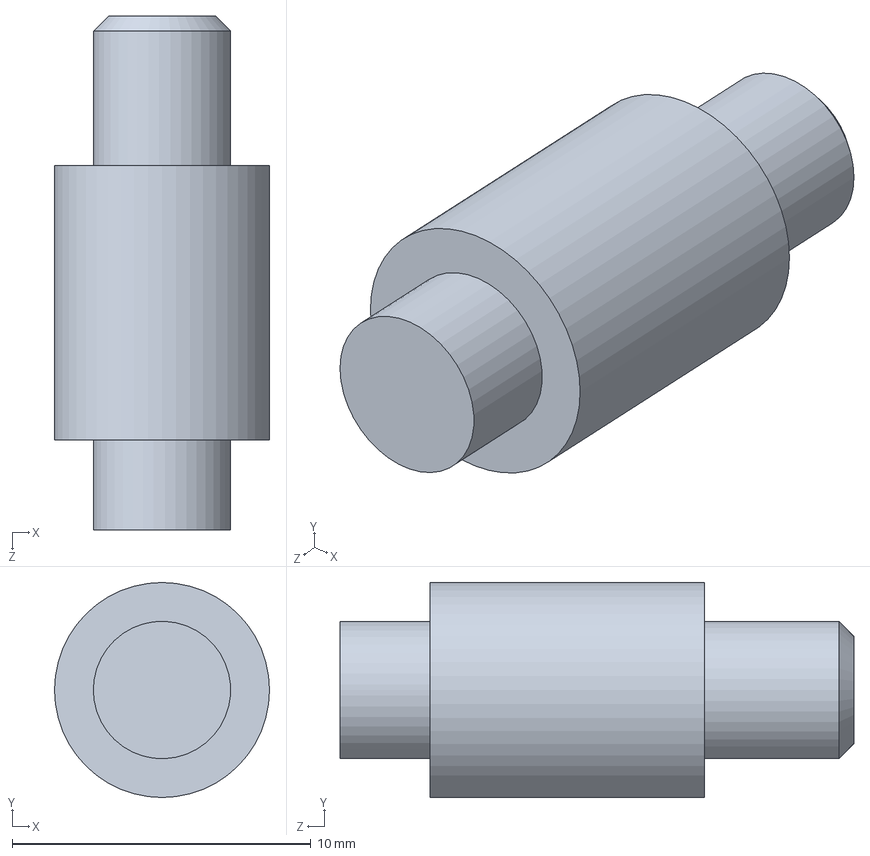
[picture p170: CAD file, 2022-10-24]
DominoRobotRework/right_small_wheel_axis-v.SLDPRT
7.20 x 7.20 x 17.2 mm
