iseegr8tfuldeadppl/Kiwico/DominoRobotRework/switchholder.SLDPRT

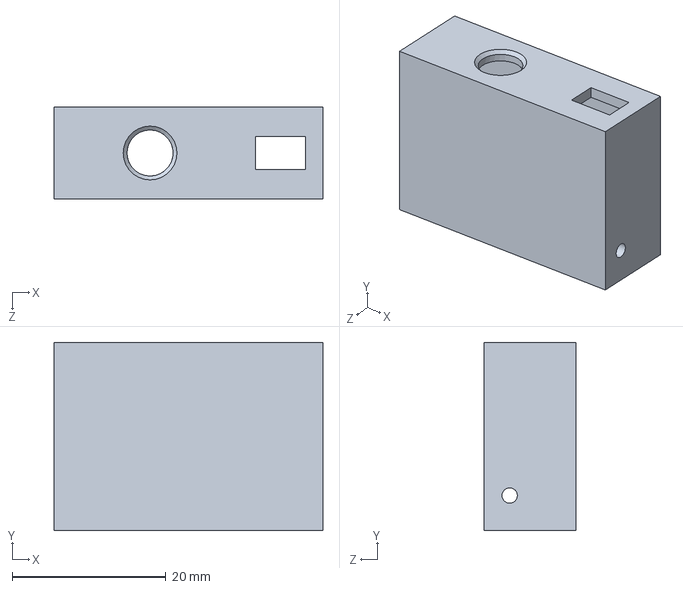
[picture p171: CAD file, 2022-10-24]
DominoRobotRework/switchholder.SLDPRT
35.0 x 24.5 x 12.0 mm
