iseegr8tfuldeadppl/Kiwico/DominoRobotRework/left_small_wheel_axis-v.SLDPRT

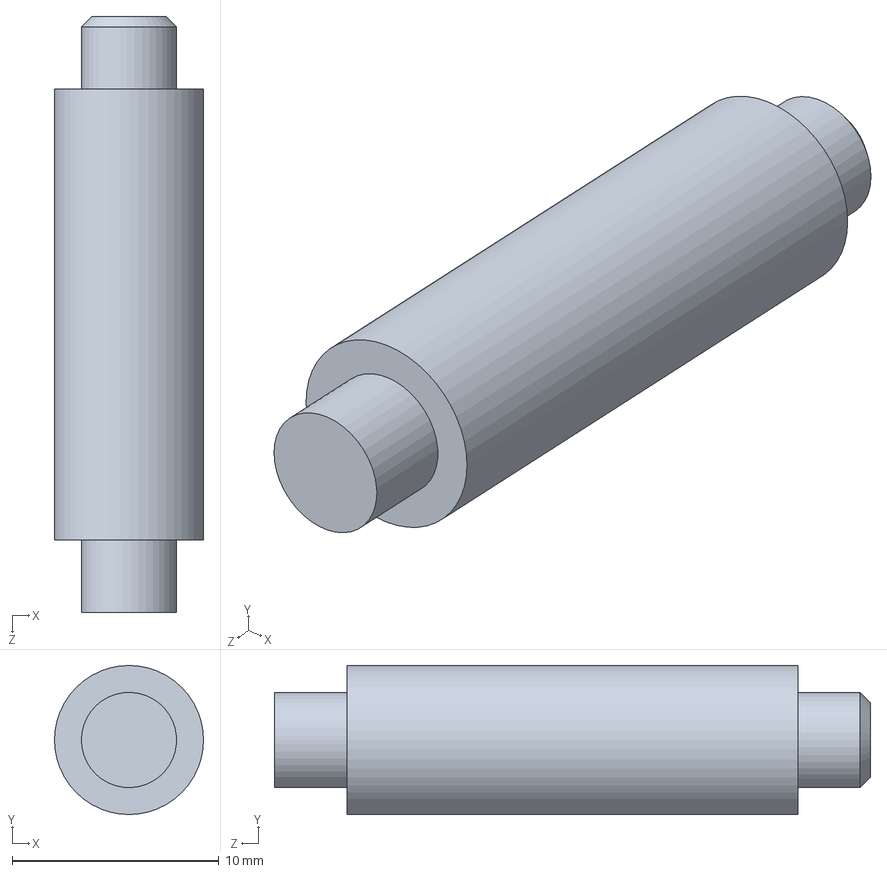
[picture p172: CAD file, 2022-10-23]
DominoRobotRework/left_small_wheel_axis-v.SLDPRT
7.20 x 7.20 x 28.8 mm
