iseegr8tfuldeadppl/Kiwico/ByeDominoRobotOG/front-smiley-n.SLDPRT

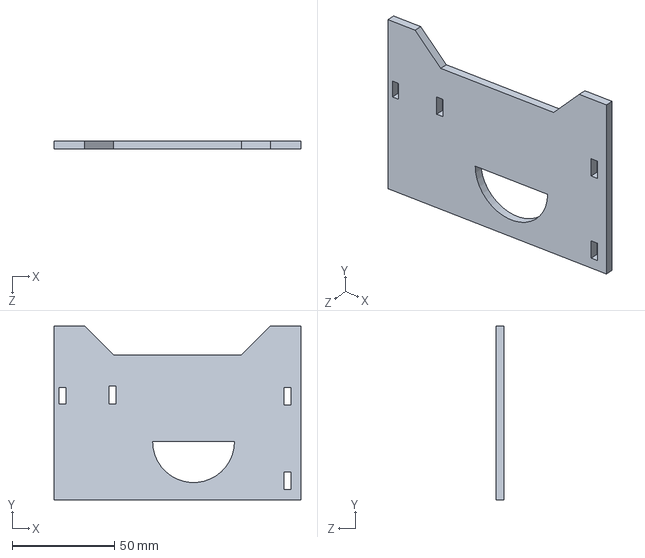
[picture p173: CAD file, 2022-09-18]
ByeDominoRobotOG/front-smiley-n.SLDPRT
120.7 x 85.0 x 4.00 mm
