iseegr8tfuldeadppl/Kiwico/other/gear_test.SLDASM

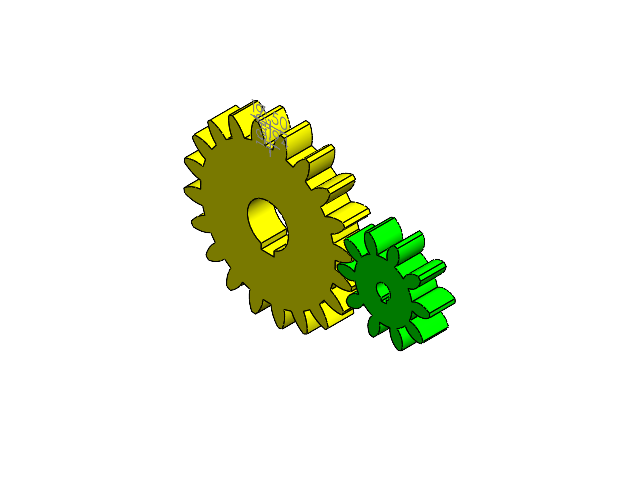
[picture p174: CAD file, 2022-07-11]
other/gear_test.SLDASM
spur gear_am x 2
