iseegr8tfuldeadppl/Kiwico/(list of files, cad)

Other CAD files:
DominoRobotRework/subass/separ.SLDASM
DominoRobotRework/Copy of right.SLDASM
ByeDominoRobotOG/back-wall-n.SLDPRT
other/BevelGear2Backup.SLDPRT
BevelGear2Backup.SLDPRT
ByeDominoRobotOG/other/OGBackup/frontGear.SLDPRT
right-most-wall.SLDPRT
rotating_plate.SLDPRT
DominoRobotRework/front-smiley-v.SLDPRT
DominoRobotRework/leg-gear-v.SLDPRT
ByeDominoRobotOG/other/OGBackup/TT Motor.SLDPRT
ByeDominoRobotOG/left-wall-n.SLDPRT
frontGear.SLDPRT
BevelGear.SLDPRT
DominoRobotRework/right-wall-v.SLDPRT
DominoRobotRework/right-most-wall-v.SLDPRT
ByeDominoRobotOG/left-most-wall-n.SLDPRT
ByeDominoRobotOG/smol-leg-gear.SLDPRT
left-wall.SLDPRT
ByeDominoRobotOG/gear_front_plate-n.SLDPRT
right-wall.SLDPRT
ByeDominoRobotOG/gear_back_plate-n.SLDPRT
ByeDominoRobotOG/4mm_pin.SLDPRT
ByeDominoRobotOG/leftest-most-wall.SLDPRT
ByeDominoRobotOG/myBevelMarkedGear.SLDPRT
ByeDominoRobotOG/road.SLDPRT
DominoRobotRework/axis-pinner.SLDPRT
DominoRobotRework/cover.SLDPRT
DominoRobotRework/floor-v.SLDPRT
DominoRobotRework/front-wall-v.SLDPRT
DominoRobotRework/gear_back_plate-v.SLDPRT
DominoRobotRework/gear_front_plate-v.SLDPRT
DominoRobotRework/leftest-most-wall-v.SLDPRT
DominoRobotRework/new-good-gear-v.SLDPRT
DominoRobotRework/pinner-v.SLDPRT
DominoRobotRework/real-domino.SLDPRT
DominoRobotRework/second-floor-v.SLDPRT
DominoRobotRework/separator-v.SLDPRT
DominoRobotRework/thumb.SLDPRT
TT Motor.SLDPRT
