iseegr8tfuldeadppl/Kiwico/PCB/how_to_output_a_pcb.png

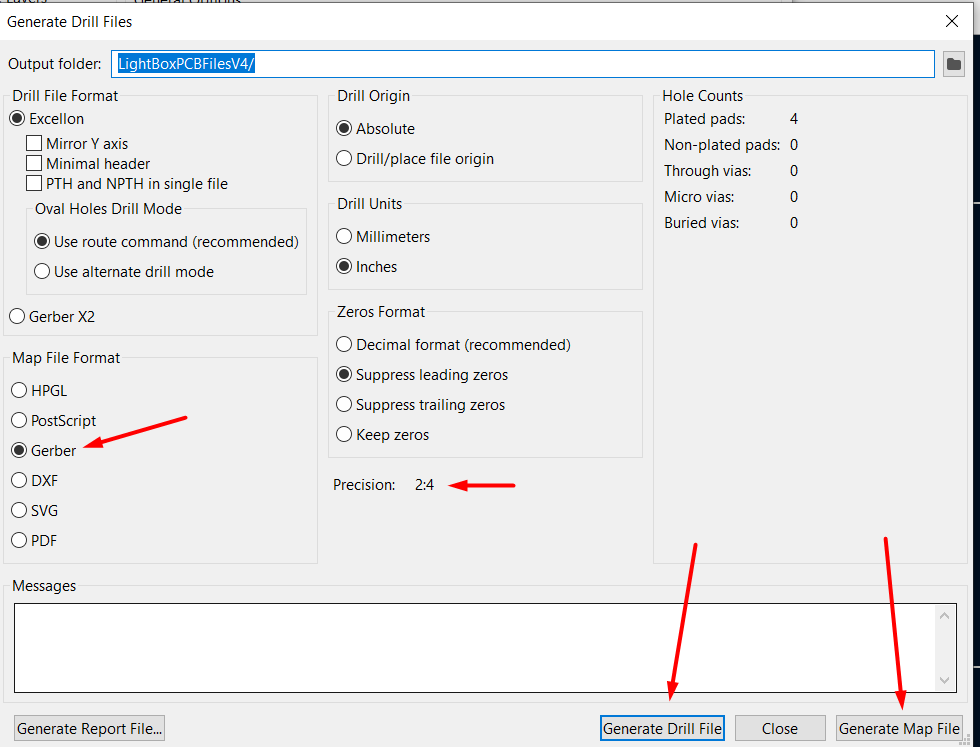
PCB/how_to_output_a_pcb.png
