iseegr8tfuldeadppl/Kiwico/(commit log)

2022-07-11 Modeling
    - cleanup
    - gate left right tuned
    [BevelGear.SLDPRT, frontGear.SLDPRT, rotating_plate.SLDPRT]
2022-07-11 Backup
    - Scaling all parts process ongoing
    - backup made
    [BevelGear-n.SLDPRT, BevelGear.SLDPRT, TT Motor-n.SLDPRT, TT Motor.SLDPRT, back-wall-n.SLDPRT, back-wall.SLDPRT, body-n.SLDASM, body.SLDASM]
2022-07-12 Resizing & Remodeling
    - modeled my first bevel gear
    - downscaled most parts still got more left
    - slightly clearer vision on resulting product
    [BevelGear-n.SLDPRT, back-wall-n.SLDPRT, body-n.SLDASM, front-smiley-n.SLDPRT, frontGear-n.SLDPRT, left-wall-n.SLDPRT, myBevelGear.SLDPRT, myBevelMarkedGear.SLDPRT]
2022-07-17 Modeling Update
    - gear section mostly overhalled reducing width, increasing reliability
    - rose robot to final shape even more
    - mechanisms seem to mostly be done, it's proportions now
    [axis.SLDPRT, back-wall-n.SLDPRT, backupmySquashedBevelMarkedGear.SLDPRT, body-n.SLDASM, floor.SLDPRT, front-smiley-n.SLDPRT, front-wall-n.SLDPRT, left-most-wall-n.SLDPRT]
2022-07-18 Car Model Update
    - added pretty walls
    - adjusted, raised and installed motor floor
    [back-wall-n.SLDPRT, backupmySquashedBevelMarkedGear.SLDPRT, body-n.SLDASM, floor.SLDPRT, front-smiley-n.SLDPRT, leftest-most-wall.SLDPRT, pin-n.SLDPRT, right-most-wall-n.SLDPRT]
2022-07-19 Modeling
    - added teeth to motor gears
    - switched axis to square rod
    - mated everything together
    [axis.SLDPRT, backupmySquashedBevelMarkedGear.SLDPRT, body-n.SLDASM, left-most-wall-n.SLDPRT, left-wall-n.SLDPRT, leg_gear.SLDPRT, motors_gear.SLDPRT, myBevelMarkedGear.SLDPRT]
2022-07-19 Test Phase
    - reduced teeth of motors gear improving pace
    - performed motion studies
    - pre-final mates
    TODO:
    - add small fronttal dummy wheels
    [body-n.SLDASM, motors_gear.SLDPRT]
2022-07-19 Modeling
    - simulated moving on a path
    - realized the proper domino release mechanism
    - worked on gears
    - prepared test parts
    [BevelGear.SLDPRT, TT Motor.SLDPRT, back-wall-n.SLDPRT, back-wall.SLDPRT, backupmySquashedBevelMarkedGear.SLDPRT, body-n.SLDASM, body.SLDASM, connector.SLDPRT]
2022-07-20 Model updates
    - moved further into the simulation
    - fixed rpm issue
    - first few irl gear tests went blissfully
    - made dominos
    [TT Motor-n.SLDPRT, back-wall-n.SLDPRT, body-n.SLDASM, domino.SLDPRT, left-wall-n.SLDPRT, leg_gear.SLDPRT, motors_gear.SLDPRT, right-wall-n.SLDPRT]
2022-07-20 Final rpm update (a used 9v battery reference)
    [body-n.SLDASM]
2022-09-18 working on tolerance
    [TT Motor-n.SLDPRT, body-n.SLDASM, domino.SLDPRT, insertion_and_hole.SLDPRT, left-most-wall-n.SLDPRT, leftest-most-wall.SLDPRT, right-wall-n.SLDPRT]
2022-09-18 redoing all the work, bout to do some payback prints then redesign to match previous progress
    [4mm_pin.SLDPRT, CE3MAX_insertion_and_hole.3mf, axis.SLDPRT, back-wall-n.SLDPRT, body-n.SLDASM, floor.SLDPRT, front-smiley-n.SLDPRT, insertion_and_hole.SLDPRT]
2022-09-19 working on useless box circuit, quick testing current version of domino bot
2022-09-19 working on uselessbox
    [4mm_pin.SLDPRT, BevelGear.SLDPRT, BevelGear2.SLDPRT, BevelGear2Backup.SLDPRT, BevelGearBackup.SLDPRT, CE3MAX_insertion_and_hole.3mf, Gear.SLDPRT, TT Motor-n.SLDPRT]
2022-09-21 working on domino model
    [axis.SLDPRT]
2022-09-23 save before overhalls
    [body-n.SLDASM, gear_back_plate-n.SLDPRT, gear_front_plate-n.SLDPRT, mySquashedBevelMarkedGear.SLDPRT, rotating_plate-n.SLDPRT]
2022-09-24 Gear Tuning
    - complete gear redesign
    - test prints
    [body-n.SLDASM, leg-gear.SLDPRT, leg_gear.SLDPRT, motor-gear.SLDPRT, mySquashedBevelMarkedGear.SLDPRT, new-good-gear.SLDPRT, right-wall-n.SLDPRT, sweep-gear.SLDPRT]
2022-09-24 Gear rework V2
    [body-n.SLDASM, leg-gear.SLDPRT, new-good-gear.SLDPRT, sweep-gear.SLDPRT]
2022-09-25 Gear tuning
    - furthering progress in perpendicular gear matchup
    [body-n.SLDASM, left-wall-n.SLDPRT, new-good-gear.SLDPRT, sweep-gear.SLDPRT]
2022-09-25 Useless Box fix
    - widened holes, prepared all initial version print files let's get going
    [axis.SLDPRT, box.SLDPRT, box_openable_top.SLDPRT, box_stationary_top.SLDPRT, entire_thing.SLDASM]
2022-09-26 UselessBox
    - first print of overall parts
    - fixed motor axis rotator dimensions let's go
    [box.SLDPRT, box_openable_top.SLDPRT, entire_thing.SLDASM, rotator.SLDPRT]
2022-09-27 domino robot model improvemetns
    [back-wall-n.SLDPRT, body-n.SLDASM, left-most-wall-n.SLDPRT, left-wall-n.SLDPRT, leg-gear.SLDPRT, motor-gear.SLDPRT, motors_gear.SLDPRT, new-good-gear.SLDPRT]
2022-09-28 updated tiny wheels, need to be shifted forward a bit
    [axis.SLDPRT, small_wheel_axis.SLDPRT, tiny_wheel.SLDPRT, tiny_wheel_hole.SLDPRT]
2022-09-28 tiny wheel save
    [small_wheel_axis.SLDPRT]
2022-10-02 modified tinywheel
    [small_switch_holder.SLDPRT, switch_holder.SLDPRT, tiny_wheel.SLDPRT, wheel-n.SLDPRT]
2022-10-02 moved tiny wheels forward a bit to avoid the intersection it had
    [body-n.SLDASM, floor.SLDPRT, left-wall-n.SLDPRT, right-most-wall-n.SLDPRT, right-wall-n.SLDPRT, tiny_wheel.SLDPRT]
2022-10-09 fixed tiny wheels axies, prepared dominos and such
    [TT Motor-n.SLDPRT, back-wall-n.SLDPRT, body-n.SLDASM, domino.SLDPRT, left_small_wheel_axis.SLDPRT, motor-gear.SLDPRT, right_small_wheel_axis.SLDPRT, small_wheel_axis.SLDPRT]
2022-10-09 working on gear ratios, looks promising but bit far
    [body-n.SLDASM, leg-gear.SLDPRT, motors_gear.SLDPRT, right-most-wall-n.SLDPRT, right-wall-n.SLDPRT]
2022-10-11 domino robot design updates
    X tiny wheels design figured out and finetuned pretty well
    X working on a better ejection system because the robot is a bit fast so the dominos r falling (also attempting to make thiccer dominos
    [domino.SLDPRT, front-wall-n.SLDPRT, left_small_wheel_axis.SLDPRT, right_small_wheel_axis.SLDPRT, tiny_wheel.SLDPRT]
2022-10-12 complete domino robot overhall
    - moved backwall backwards 7mm required
    - made wheels thiccer
    - fixed all dimension mistakes
    - centered all pins onto walls allowing for finetuning
    - made leftest most wall way shorter
    - cut a better slow for dominos to slide out without spinning out or falling hopefully
    - shortened window for front wall to never rock back and forth again
    - added a pinner to every pin completely avoiding the need for the tiny elastic bands that are unfindable in the first place
    - complete mating overhall
    - complete design smart dimensions reference overhall allowing for easy finetuning
    - fixed floor issues with tiny wheels by splitting it up
    x did not apply finetuned and notche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
    [4mm_pin-v.SLDPRT, 4mm_pin.SLDPRT, BevelGear.SLDPRT, BevelGear2.SLDPRT, BevelGear2Backup.SLDPRT, BevelGearBackup.SLDPRT, Gear.SLDPRT, TT Motor-n.SLDPRT]
2022-10-12 Domino Robot Finetuned
    - finished finetuning pin and pinner
    - applied shared dimension text file
    - separated walls into subassemblies
    - exported print files let's do other things now
    [back-wall-v.SLDPRT, body-v.SLDASM, front-smiley-v.SLDPRT, insertion_and_hole.SLDPRT, left-wall-v.SLDPRT, left_small_wheel_axis-v.SLDPRT, leftest-most-wall-v.SLDPRT, pin-v.SLDPRT]
2022-10-13 fixing bugs related to filament differences
    [Copy of right.SLDASM, back-wall-v.SLDPRT, body-v.SLDASM, front-smiley-v.SLDPRT, left-wall-v.SLDPRT, right-most-wall-v.SLDPRT, right-wall-v.SLDPRT, separ.SLDASM]
2022-10-14 fixed bugs
    [body-v.SLDASM, separ.SLDASM, separator-v.SLDPRT]
2022-10-14 big fixes
    [body-v.SLDASM, separ.SLDASM, separator-v.SLDPRT, tiny_wheel-v.SLDPRT, wheel-v.SLDPRT]
2022-10-16 Domino Robot
    - moved leftest gate a bit shorter forward
    - removed fillet on leftest gate
    - fixed tiny wheel axies
    - reduced pre-leg teeth by 5
    - increase motors gear teeth by 5
    - made motors gear thinner from 10mm to 6mm
    - removed design cuts made into leg-gear to help with supports
    [body-v.SLDASM, domino-v.SLDPRT, left_small_wheel_axis-v.SLDPRT, left_small_wheel_axis.SLDPRT, leftest-most-wall-v.SLDPRT, leg-gear-v.SLDPRT, motors_gear-v.SLDPRT, pre-leg-gear-v.SLDPRT]
2022-10-17 First working version
    - made small wheel axies insert thinner from 5mm to idk, and the non-insert thinner too from 7.5mm to 7.2mm and reduced its width too
    - made dominos taller
    [4mm_pin.SLDPRT, BevelGear.SLDPRT, BevelGear2.SLDPRT, BevelGear2Backup.SLDPRT, BevelGearBackup.SLDPRT, Gear.SLDPRT, TT Motor-n.SLDPRT, TT Motor.SLDPRT]
2022-10-20 massive finetuning
    [Copy of right.SLDASM, axis-pinner.SLDPRT, axis-v.SLDPRT, back-wall-v.SLDPRT, body-v.SLDASM, front-smiley-v.SLDPRT, insertion.SLDPRT, left-most-wall-v.SLDPRT]
2022-10-21 2nd Finetune
    - more learning finetuning
    - thiccened small wheels
    - saved new good cura parameters into csv
    - added a handle to leftest most wall who knows
    - reduced robot speed even more thru gears, might be so close to maximum motors gear size before hitting the floor
    - made dominos pathway 1mm wider
    - finetuned tinywheel axies now they good
    - finetuned tinywheels circularhole to fit better faster without wiggling
    [back-wall-v.SLDPRT, body-v.SLDASM, bw-fs-parameters.csv, front-smiley-v.SLDPRT, left_small_wheel_axis-v.SLDPRT, leftest-most-wall-v.SLDPRT, motors_gear-v.SLDPRT, pre-leg-gear-v.SLDPRT]
2022-10-22 Finetuning
    - recovered 24.4mm dominos path width bcz 25.4mm was too wide ig idk, might not be the actual solution
    - moved separator hole back up to match the real robot u have rn, it must be close to main gear and above middle
    - raised distance between sweep gear and rotating plate from 4mm to 4.5mm meaning even if u tighten the screw, it'll still spin freely
    - made front of gate 21mm wide instead of 16mm (i measured the cuts i made manually)
    - removed the two extra mm from front sliding smiley that i cut manually before
    - fixed up axis a little more
    - applied new hole dimensions and chamfers to large wheels
    [axis-v.SLDPRT, back-wall-v.SLDPRT, body-v.SLDASM, front-smiley-v.SLDPRT, front-wall-v.SLDPRT, gear_back_plate-v.SLDPRT, gear_front_plate-v.SLDPRT, left-most-wall-v.SLDPRT]
2022-10-22 Easy of assembly
    - rotating plate gear now snap fits with rotating thumb
    - main gear does not require screws anymore
    [Copy of right.SLDASM, body-v.SLDASM, gear-back-plate-snap.SLDPRT, left-wall-v.SLDPRT, leg-gear-v.SLDPRT, motors_gear-v.SLDPRT, pre-leg-gear-v.SLDPRT, right-wall-v.SLDPRT]
2022-10-23 Finetuning ease of mountability
    - added 2mm to preleg gear for better fit
    - moved rotating plate extender from 4.5mm to 4.0mm
    [4mm_pin-v.SLDPRT, Copy of right.SLDASM, body-v.SLDASM, gear-back-plate-snap.SLDPRT, left-wall-v.SLDPRT, new-good-gear-v.SLDPRT, pre-leg-gear-v.SLDPRT, right-wall-v.SLDPRT]
2022-10-23 file cleanup
    [body-v.SLDASM]
2022-10-23 close to finishing
    [4mm_pin-v.SLDPRT, axis-v.SLDPRT, back-wall-v.SLDPRT, body-v.SLDASM, box.SLDPRT, cover.SLDPRT, front-smiley-v.SLDPRT, gear-back-plate-snap.SLDPRT]
2022-10-24 Final scuffed version v1.0
    [axis-test.SLDPRT, axis-v.SLDPRT, left-tiny_wheel-v.SLDPRT, left-wall-v.SLDPRT, motors_gear-v.SLDPRT, right-tiny_wheel-v.SLDPRT, right_small_wheel_axis-v.SLDPRT, switchholder.SLDPRT]
2023-03-07 redoing files
    [4mm_pin-v.SLDPRT, BevelGear.SLDPRT, BevelGear2.SLDPRT, BevelGear2Backup.SLDPRT, BevelGearBackup.SLDPRT, Gear.SLDPRT, TT Motor.SLDPRT, TT Motor.step]
2023-03-07 adding more friction to wheel socks
    [right_small_wheel_sock.SLDPRT]
2023-03-10 designed simple "grippy" wheel covers
    [large_wheel_sock.SLDPRT]
2023-03-14 wider walls
    [wider-front-smiley-v-between-right-walls.SLDPRT]
2023-03-17 mated body
    [axis-v.SLDPRT, back-wall-v.SLDPRT, body-v.SLDASM, front-smiley-v.SLDPRT, gear-back-plate-snap.SLDPRT, left-most-wall-v.SLDPRT, leg-gear-v.SLDPRT, motors_gear-v.SLDPRT]
2023-03-17 pdf mounting guide (english)
    [back-wall-v.SLDPRT, body-v.SLDASM, box.SLDPRT, gear-back-plate-snap.SLDPRT, left-tiny_wheel-v.SLDPRT, left_small_wheel_sock.SLDPRT, rotating_plate-v.SLDPRT, sweep-gear-v.SLDPRT]
2023-03-17 added french version
    [body-v.SLDASM]
